verdammte/voron_2.4/Mobius-Extruder-M4/Mobius-Extruder-M4/README.md

# VORON M4 Extruder

Image of M4

This is the VORON M4 Extruder. It's a dual geared hobbed filament extruder designed for the Voron family of printers. It features a 4:1 belt driven design to provide torque while being able to be near silent. It borrows the best parts of the various extruders we've released over the past 5 years.

Voron Logo
