verdammte/voron_2.4/Voron-2-2.4r2/Voron-2-2.4r2/README.md

# Voron 2.4

Image of Voron 2.4

The official release of the Voron 2.4 3d printer.  You can find the BOM in the configurator located at the [Voron Design]( http://vorondesign.com/voron2.4) website.

Voron Logo
