verdammte/voron_2.4/Voron-2-2.4r2/Voron-2-2.4r2/firmware/klipper_configurations/SKR_1.4/readme.md

<B>VORON V2.4 SKR 1.4 Config</B>

This config file is for using two BigTreeTech SKR 1.4 boards on the Voron V2.4. For additional reference material, please reference BigTreeTech's Github page:

https://github.com/bigtreetech/BIGTREETECH-SKR-V1.3/tree/master/BTT%20SKR%20V1.4
