verdammte/voron_2.4/Voron-2-2.4r2/Voron-2-2.4r2/STLs/Tools/bottom_panel_modification.png

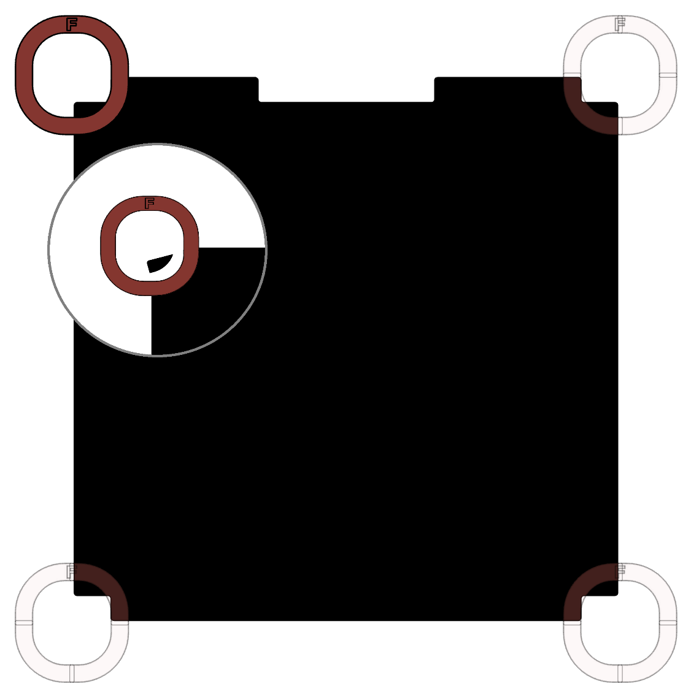
Voron-2-2.4r2/Voron-2-2.4r2/STLs/Tools/bottom_panel_modification.png
