verdammte/voron_2.4/Mobius-Extruder-M4/Mobius-Extruder-M4/STLs/main_body.stl

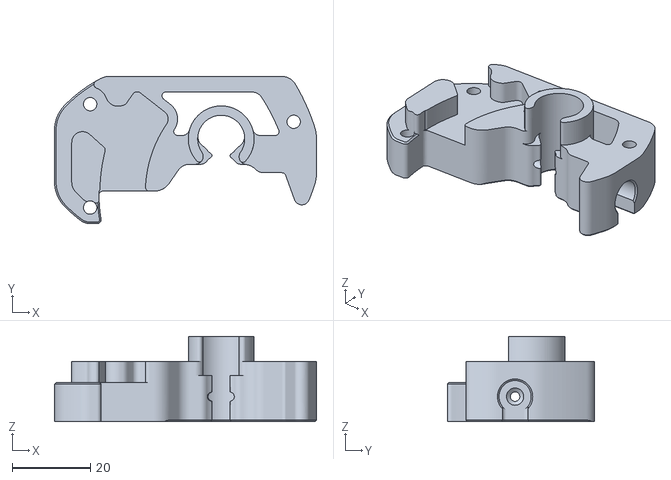
[picture p2: CAD file, 2022-04-12]
Mobius-Extruder-M4/Mobius-Extruder-M4/STLs/main_body.stl
66.8 x 37.6 x 21.8
