verdammte/voron_2.4/Voron-2-2.4r2/Voron-2-2.4r2/STLs/Z_Drive/z_drive_main_a_x2.stl

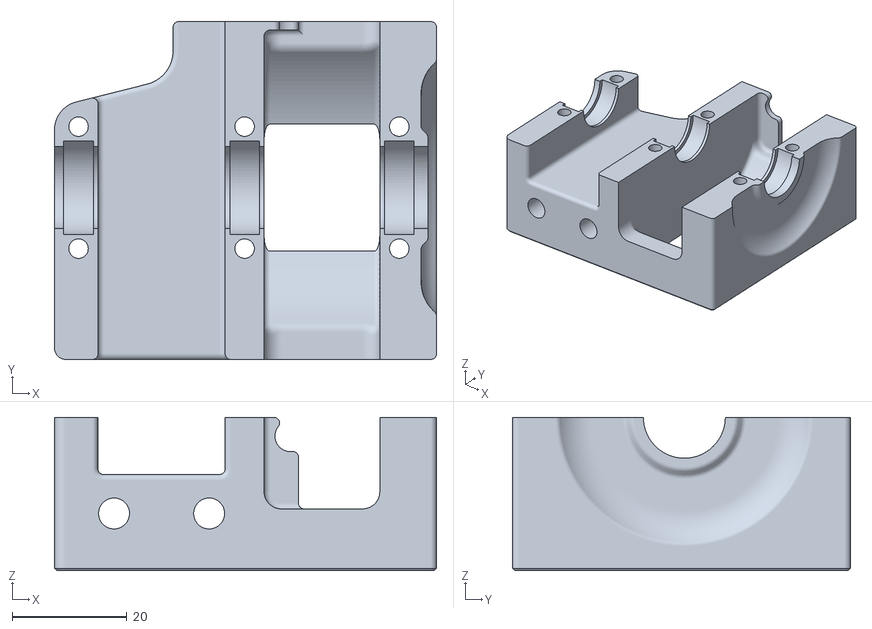
[picture p3: CAD file, 2022-04-12]
Voron-2-2.4r2/Voron-2-2.4r2/STLs/Z_Drive/z_drive_main_a_x2.stl
66.7 x 59.0 x 26.8
