verdammte/voron_2.4/Mobius-Extruder-M4/Mobius-Extruder-M4/STLs/motor_plate.stl

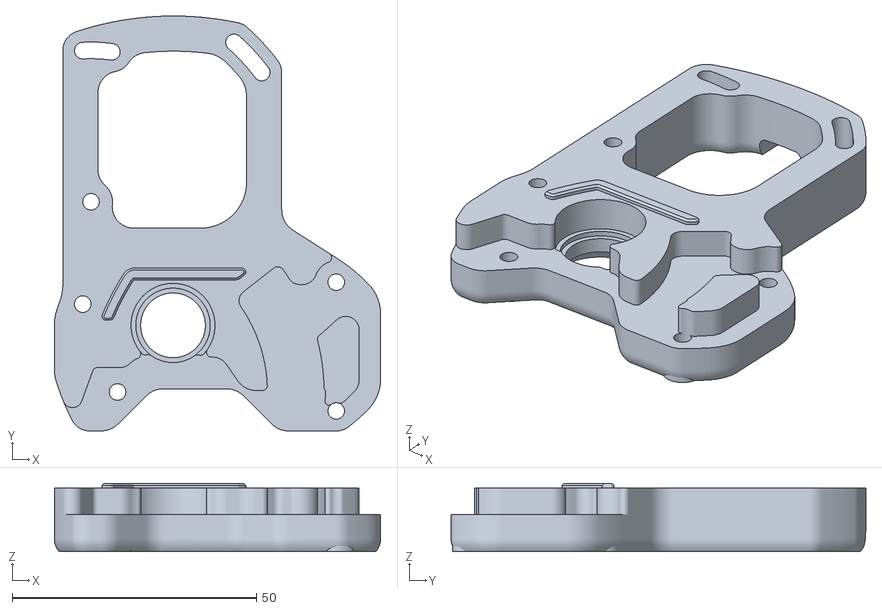
[picture p4: CAD file, 2022-04-12]
Mobius-Extruder-M4/Mobius-Extruder-M4/STLs/motor_plate.stl
66.8 x 85.0 x 14.0
