verdammte/voron_2.4/Voron-2-2.4r2/Voron-2-2.4r2/Drawing_DXFs/Build_Plate/MIC6_Bed_V2_350.step

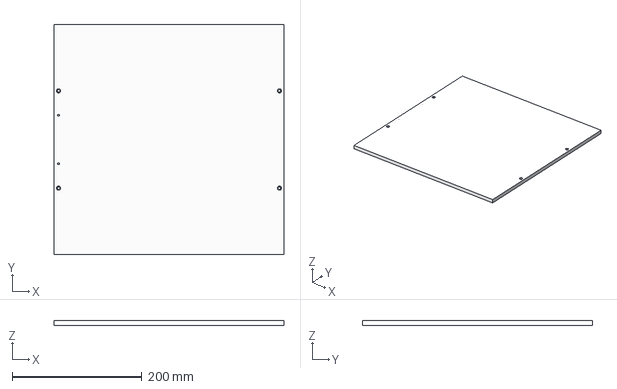
[picture p5: CAD file, 2022-04-12]
Voron-2-2.4r2/Voron-2-2.4r2/Drawing_DXFs/Build_Plate/MIC6_Bed_V2_350.step
355.0 x 355.0 x 7.76 mm
