verdammte/voron_2.4/Voron-2-2.4r2/Voron-2-2.4r2/Drawing_DXFs/Panels/250_Back_Panel.DXF

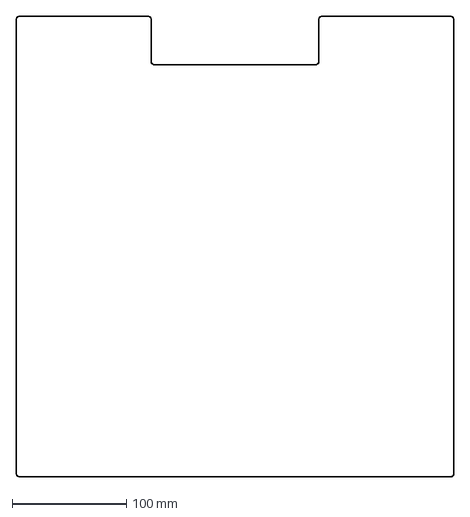
[picture p6: CAD file, 2022-04-12]
Voron-2-2.4r2/Voron-2-2.4r2/Drawing_DXFs/Panels/250_Back_Panel.DXF
383.0 x 403.0 mm
