verdammte/voron_2.4/Voron-2-2.4r2/Voron-2-2.4r2/STLs/Electronics_Bay/Controller_Mounts/GTR_bracket_set.stl

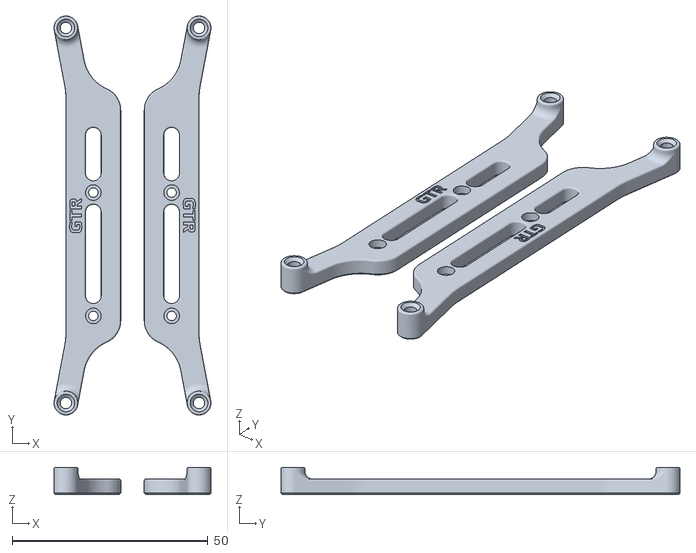
[picture p7: CAD file, 2022-04-12]
Voron-2-2.4r2/Voron-2-2.4r2/STLs/Electronics_Bay/Controller_Mounts/GTR_bracket_set.stl
40.1 x 101.9 x 7.00
