verdammte/voron_2.4/Voron-2-2.4r2/Voron-2-2.4r2/STLs/Electronics_Bay/Other_PS_Mounts/UHP_350_Mount_x2.stl

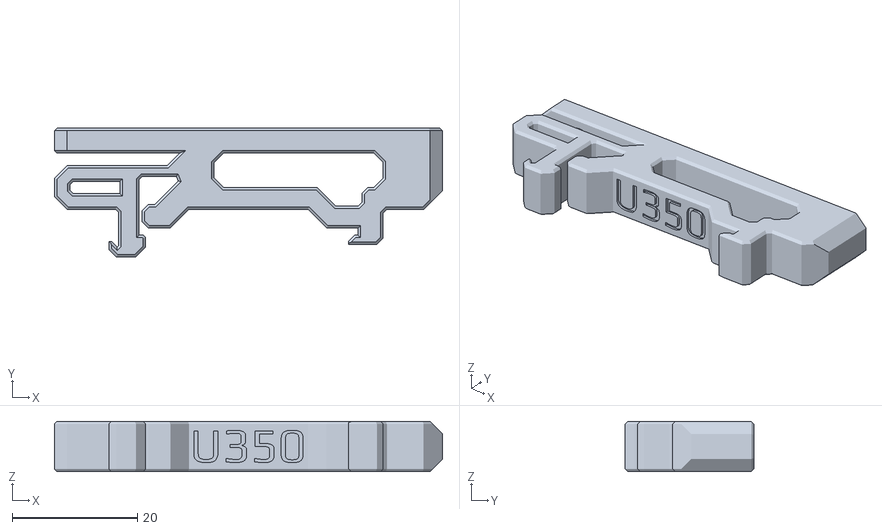
[picture p8: CAD file, 2022-04-12]
Voron-2-2.4r2/Voron-2-2.4r2/STLs/Electronics_Bay/Other_PS_Mounts/UHP_350_Mount_x2.stl
62.0 x 20.6 x 8.00
