verdammte/voron_2.4/Voron-2-2.4r2/Voron-2-2.4r2/STLs/Electronics_Bay/pcb_din_clip_x3.stl

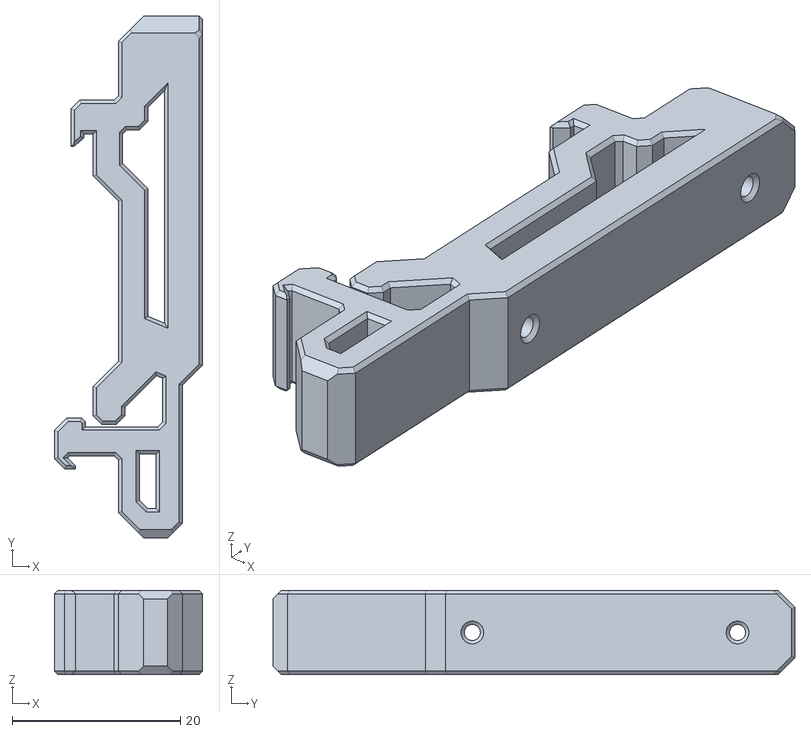
[picture p9: CAD file, 2022-04-12]
Voron-2-2.4r2/Voron-2-2.4r2/STLs/Electronics_Bay/pcb_din_clip_x3.stl
17.6 x 62.0 x 10.0
