verdammte/voron_2.4/Voron-2-2.4r2/Voron-2-2.4r2/STLs/Exhaust_Filter/[a]_exhaust_filter_mount_x2.stl

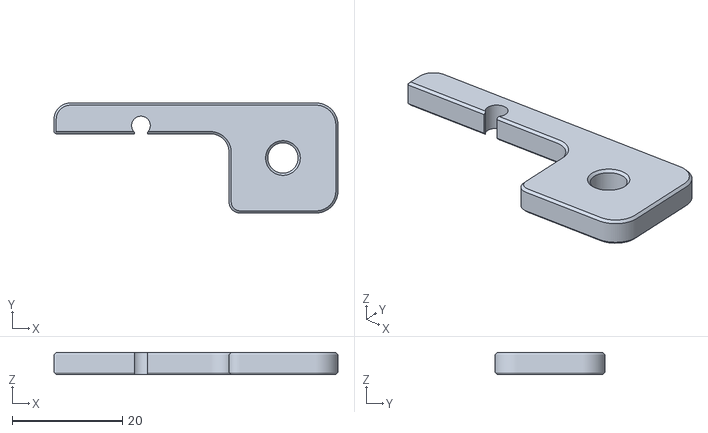
[picture p10: CAD file, 2022-04-12]
Voron-2-2.4r2/Voron-2-2.4r2/STLs/Exhaust_Filter/[a]_exhaust_filter_mount_x2.stl
51.6 x 20.0 x 4.00
