verdammte/voron_2.4/Voron-2-2.4r2/Voron-2-2.4r2/STLs/Gantry/X_Axis/X_Carriage/Bowden/bowden_dual_front_b.stl

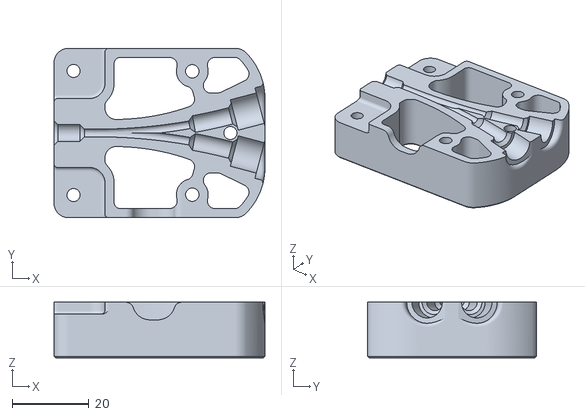
[picture p14: CAD file, 2022-04-12]
Voron-2-2.4r2/Voron-2-2.4r2/STLs/Gantry/X_Axis/X_Carriage/Bowden/bowden_dual_front_b.stl
55.0 x 44.2 x 14.5
