verdammte/voron_2.4/Voron-2-2.4r2/Voron-2-2.4r2/STLs/Gantry/X_Axis/X_Carriage/Direct_Feed/[a]_latch.stl

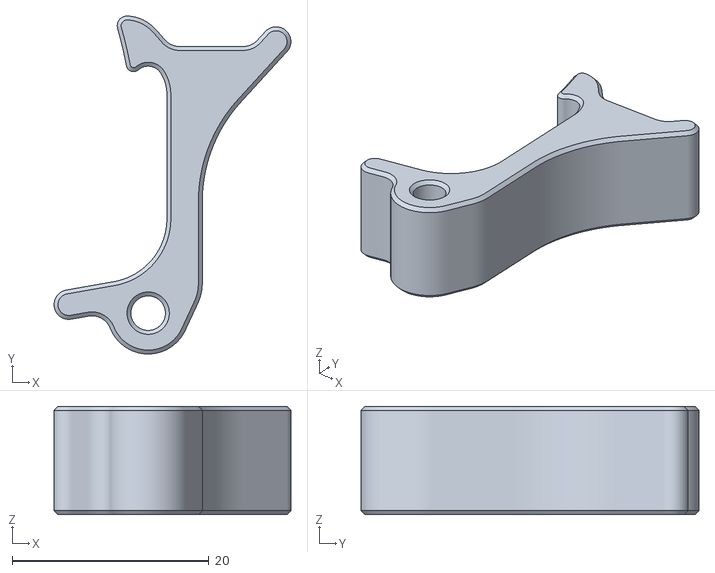
[picture p15: CAD file, 2022-04-12]
Voron-2-2.4r2/Voron-2-2.4r2/STLs/Gantry/X_Axis/X_Carriage/Direct_Feed/[a]_latch.stl
24.1 x 34.3 x 11.0
