verdammte/voron_2.4/Voron-2-2.4r2/Voron-2-2.4r2/STLs/Gantry/X_Axis/X_Carriage/Printheads/Dragonfly_BMO/printhead_front_dragonfly_bmo.stl

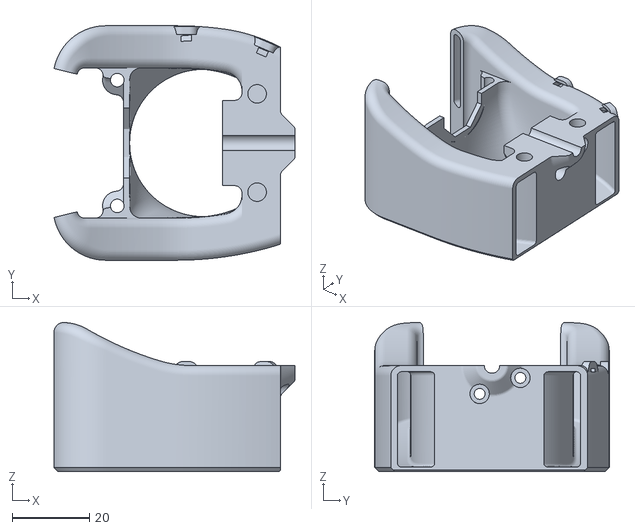
[picture p17: CAD file, 2022-04-12]
Voron-2-2.4r2/Voron-2-2.4r2/STLs/Gantry/X_Axis/X_Carriage/Printheads/Dragonfly_BMO/printhead_front_dragonfly_bmo.stl
62.3 x 60.6 x 38.5
