verdammte/voron_2.4/Voron-2-2.4r2/Voron-2-2.4r2/STLs/Gantry/X_Axis/X_Carriage/Printheads/E3D_V6/printhead_rear_e3dv6.stl

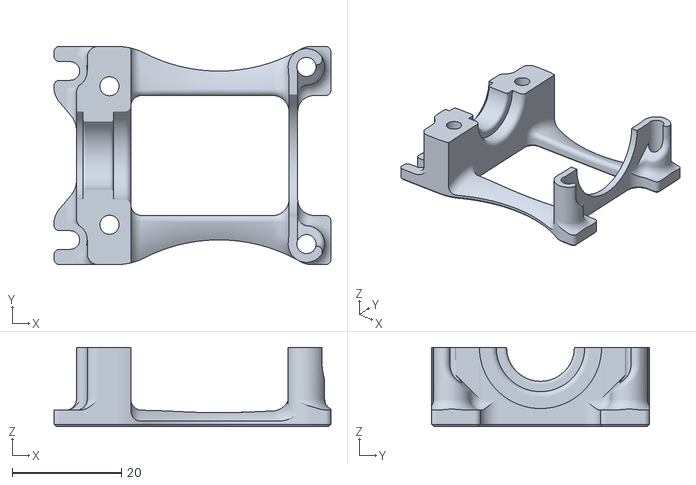
[picture p20: CAD file, 2022-04-12]
Voron-2-2.4r2/Voron-2-2.4r2/STLs/Gantry/X_Axis/X_Carriage/Printheads/E3D_V6/printhead_rear_e3dv6.stl
50.8 x 40.0 x 14.5
