verdammte/voron_2.4/Voron-2-2.4r2/Voron-2-2.4r2/STLs/Gantry/X_Axis/X_Carriage/Printheads/Slice_Mosquito/printhead_front_mosquito.stl

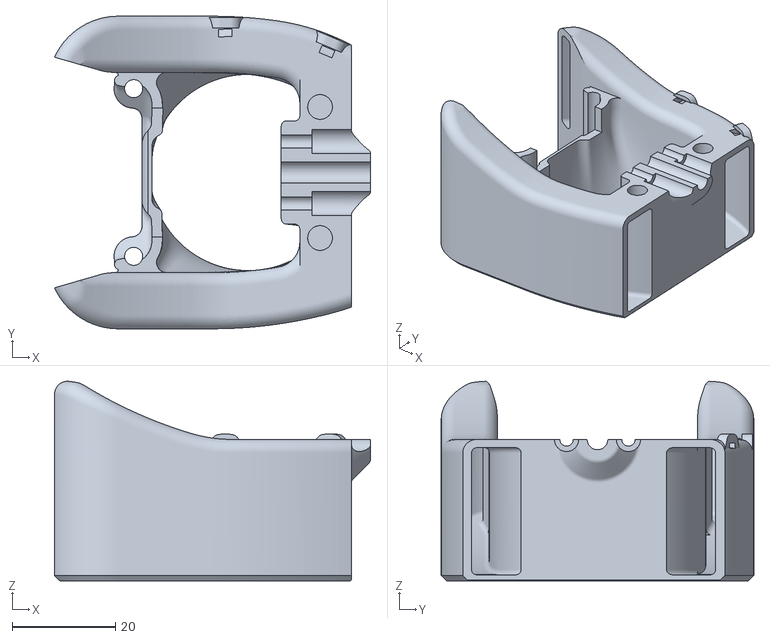
[picture p21: CAD file, 2022-04-12]
Voron-2-2.4r2/Voron-2-2.4r2/STLs/Gantry/X_Axis/X_Carriage/Printheads/Slice_Mosquito/printhead_front_mosquito.stl
61.2 x 60.6 x 38.7
