verdammte/voron_2.4/Voron-2-2.4r2/Voron-2-2.4r2/STLs/Gantry/X_Axis/XY_Joints/[a]_endstop_pod_hall_effect.stl

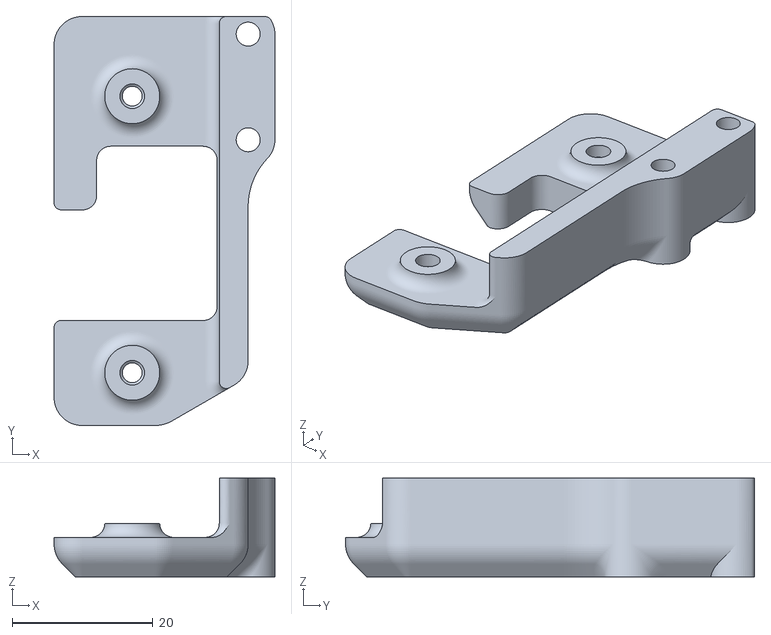
[picture p23: CAD file, 2022-04-12]
Voron-2-2.4r2/Voron-2-2.4r2/STLs/Gantry/X_Axis/XY_Joints/[a]_endstop_pod_hall_effect.stl
31.4 x 58.0 x 14.0
