verdammte/voron_2.4/Voron-2-2.4r2/Voron-2-2.4r2/STLs/Gantry/Z_Joints/z_joint_upper_x4.stl

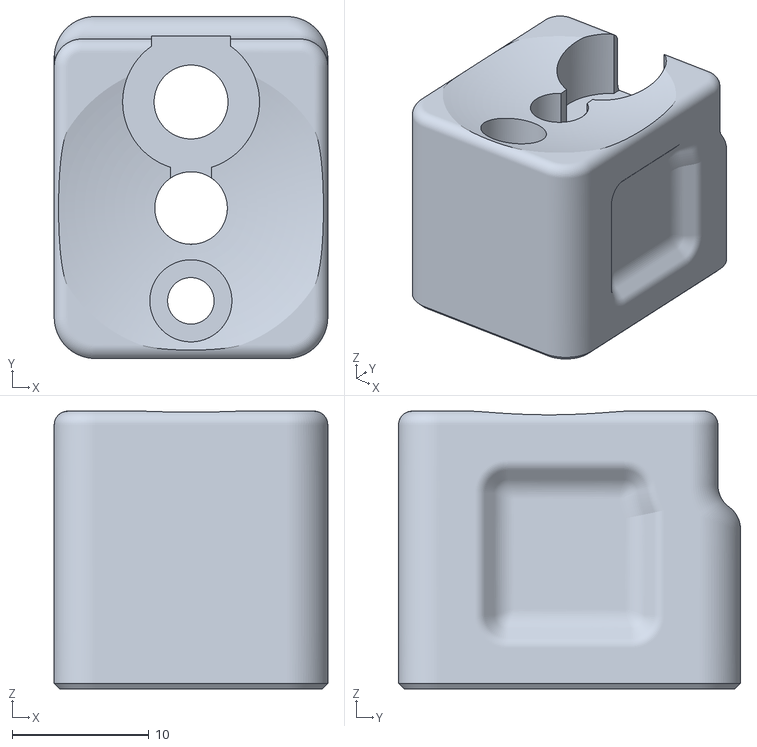
[picture p24: CAD file, 2022-04-12]
Voron-2-2.4r2/Voron-2-2.4r2/STLs/Gantry/Z_Joints/z_joint_upper_x4.stl
20.0 x 25.0 x 20.3
