verdammte/voron_2.4/Voron-2-2.4r2/Voron-2-2.4r2/STLs/Panel_Mounting/Front_Doors/latch_x2.stl

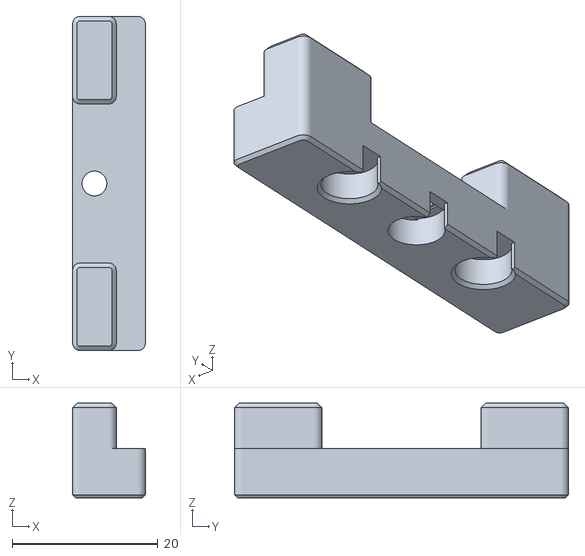
[picture p25: CAD file, 2022-04-12]
Voron-2-2.4r2/Voron-2-2.4r2/STLs/Panel_Mounting/Front_Doors/latch_x2.stl
10.0 x 45.9 x 13.0
