verdammte/voron_2.4/Voron-2-2.4r2/Voron-2-2.4r2/STLs/Panel_Mounting/z_belt_cover_b_x2.stl

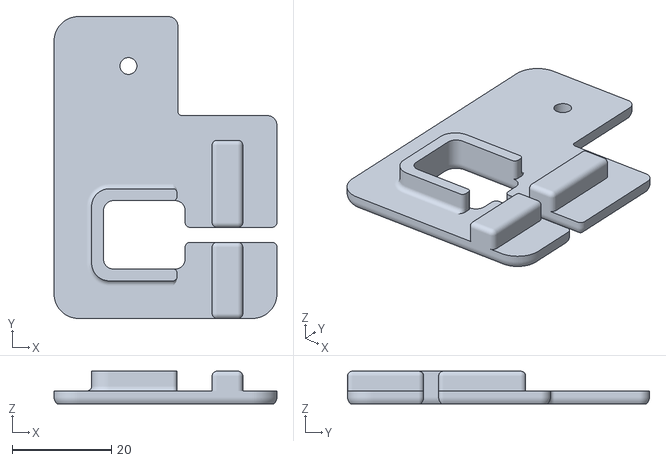
[picture p26: CAD file, 2022-04-12]
Voron-2-2.4r2/Voron-2-2.4r2/STLs/Panel_Mounting/z_belt_cover_b_x2.stl
45.0 x 61.0 x 6.60
