verdammte/voron_2.4/Voron-2-2.4r2/Voron-2-2.4r2/STLs/Skirts/250/side_skirt_b_250_x2.stl

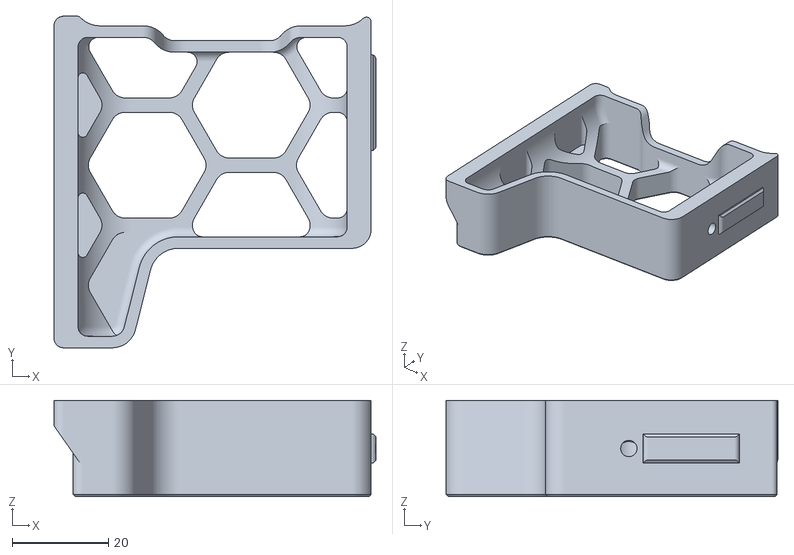
[picture p27: CAD file, 2022-04-12]
Voron-2-2.4r2/Voron-2-2.4r2/STLs/Skirts/250/side_skirt_b_250_x2.stl
67.0 x 69.0 x 20.0
