verdammte/voron_2.4/Voron-2-2.4r2/Voron-2-2.4r2/STLs/Skirts/300/front_skirt_a_300.stl

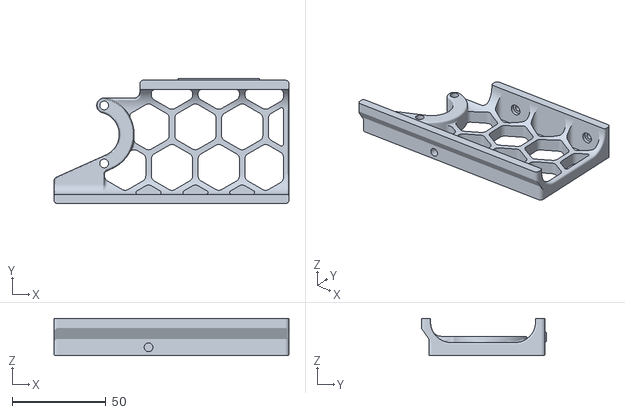
[picture p28: CAD file, 2022-04-12]
Voron-2-2.4r2/Voron-2-2.4r2/STLs/Skirts/300/front_skirt_a_300.stl
125.5 x 67.0 x 20.0
