verdammte/voron_2.4/Voron-2-2.4r2/Voron-2-2.4r2/STLs/Skirts/350/front_skirt_a_350.stl

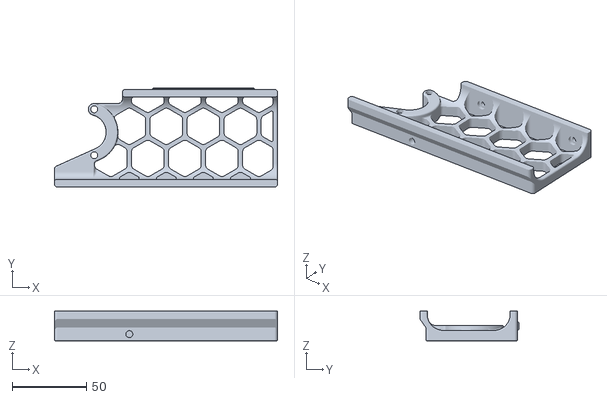
[picture p29: CAD file, 2022-04-12]
Voron-2-2.4r2/Voron-2-2.4r2/STLs/Skirts/350/front_skirt_a_350.stl
150.5 x 67.0 x 20.0
