verdammte/voron_2.4/Voron-2-2.4r2/Voron-2-2.4r2/STLs/Skirts/[a]_mini12864_case_hinge.stl

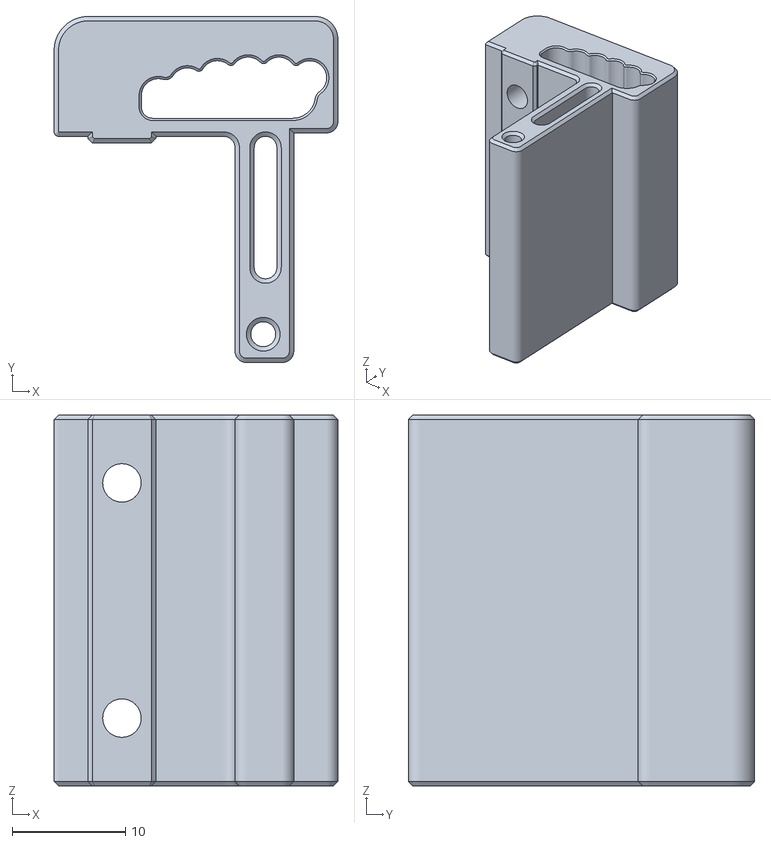
[picture p30: CAD file, 2022-04-12]
Voron-2-2.4r2/Voron-2-2.4r2/STLs/Skirts/[a]_mini12864_case_hinge.stl
25.1 x 30.6 x 32.8
