verdammte/voron_2.4/Voron-2-2.4r2/Voron-2-2.4r2/STLs/Spool_Management/spool_holder.stl

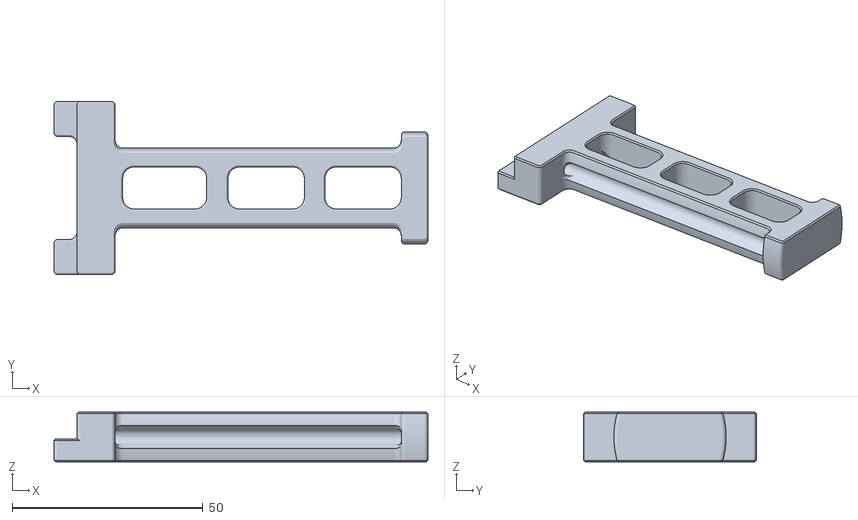
[picture p31: CAD file, 2022-04-12]
Voron-2-2.4r2/Voron-2-2.4r2/STLs/Spool_Management/spool_holder.stl
98.0 x 45.4 x 13.0
