verdammte/voron_2.4/Voron-2-2.4r2/Voron-2-2.4r2/STLs/Superceded_Parts/[a]_stopgap_80T_hubbed_gear.stl

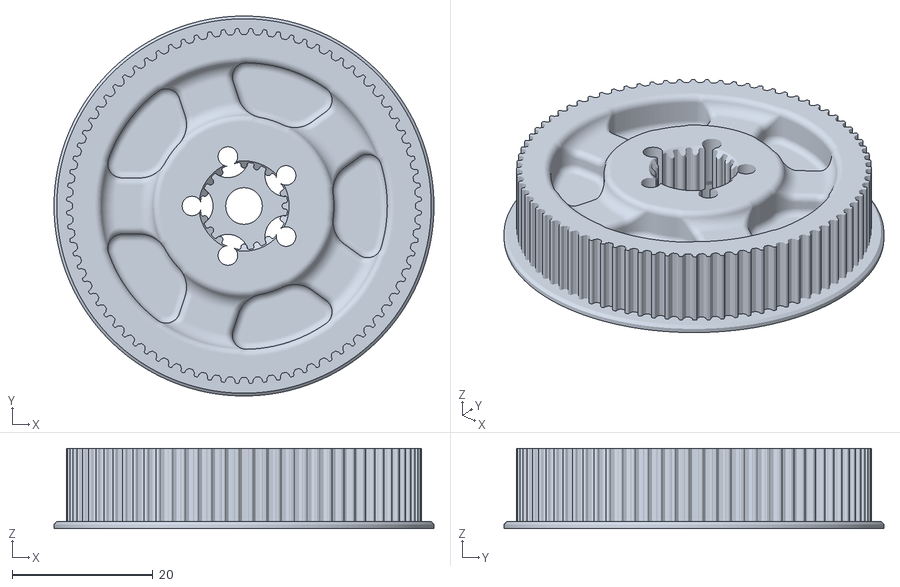
[picture p32: CAD file, 2022-04-12]
Voron-2-2.4r2/Voron-2-2.4r2/STLs/Superceded_Parts/[a]_stopgap_80T_hubbed_gear.stl
54.0 x 54.0 x 11.4
