verdammte/voron_2.4/Voron-2-2.4r2/Voron-2-2.4r2/STLs/Superceded_Parts/Frame_Brackets/lrs_bracket_frame.stl

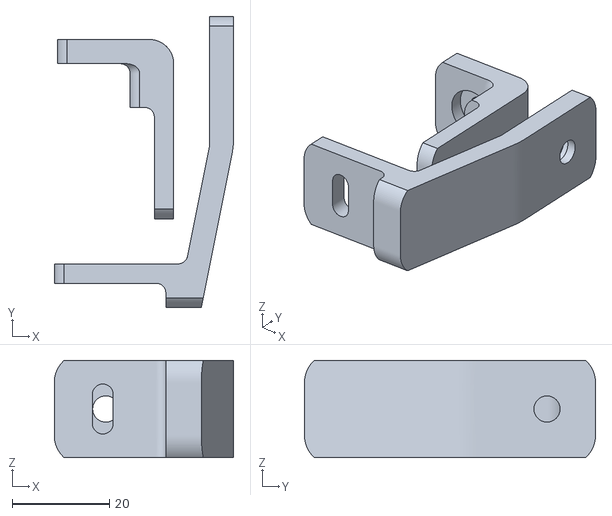
[picture p33: CAD file, 2022-04-12]
Voron-2-2.4r2/Voron-2-2.4r2/STLs/Superceded_Parts/Frame_Brackets/lrs_bracket_frame.stl
37.0 x 60.0 x 20.0
