verdammte/voron_2.4/Voron-2-2.4r2/Voron-2-2.4r2/STLs/Superceded_Parts/MGN9_X/x_carriage_pivot_block_MGN9.stl

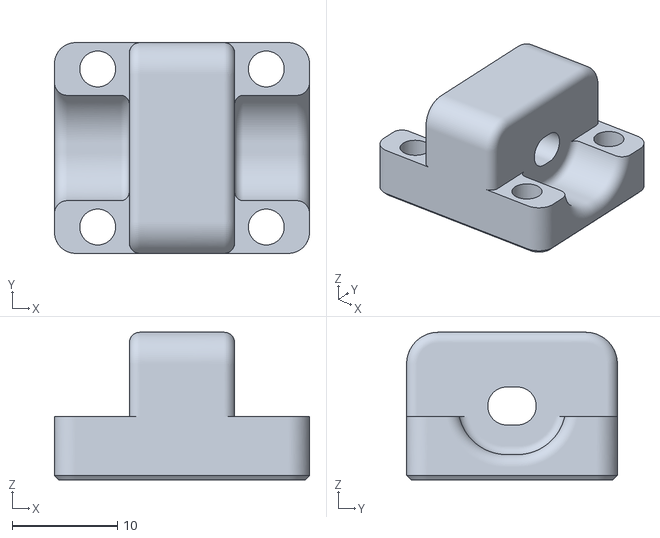
[picture p34: CAD file, 2022-04-12]
Voron-2-2.4r2/Voron-2-2.4r2/STLs/Superceded_Parts/MGN9_X/x_carriage_pivot_block_MGN9.stl
24.2 x 20.0 x 14.0
