verdammte/voron_2.4/Voron-2-2.4r2/Voron-2-2.4r2/STLs/Superceded_Parts/ZipChain/XY/zipchain2_xy_link_b.stl

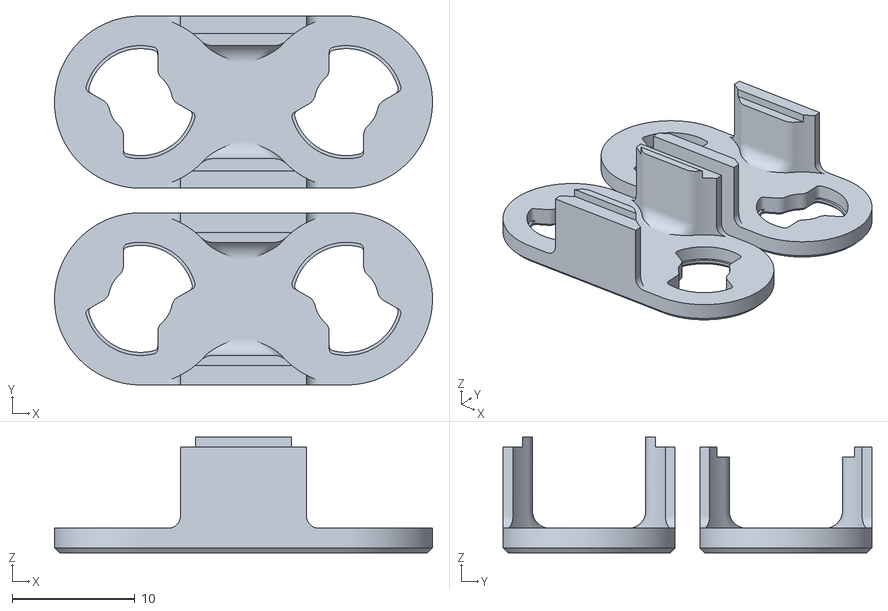
[picture p35: CAD file, 2022-04-12]
Voron-2-2.4r2/Voron-2-2.4r2/STLs/Superceded_Parts/ZipChain/XY/zipchain2_xy_link_b.stl
30.7 x 30.0 x 9.40
