verdammte/voron_2.4/Voron-2-2.4r2/Voron-2-2.4r2/STLs/Superceded_Parts/ZipChain/Z/zipchain2_z_link_b_locking.stl

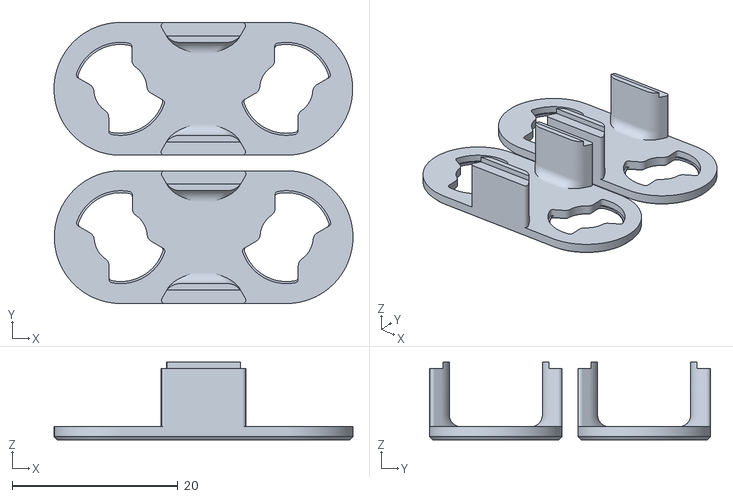
[picture p36: CAD file, 2022-04-12]
Voron-2-2.4r2/Voron-2-2.4r2/STLs/Superceded_Parts/ZipChain/Z/zipchain2_z_link_b_locking.stl
36.0 x 33.9 x 9.40
