verdammte/voron_2.4/Voron-2-2.4r2/Voron-2-2.4r2/STLs/Test_Prints/Thread_Test_3_x1_Rev1.STL

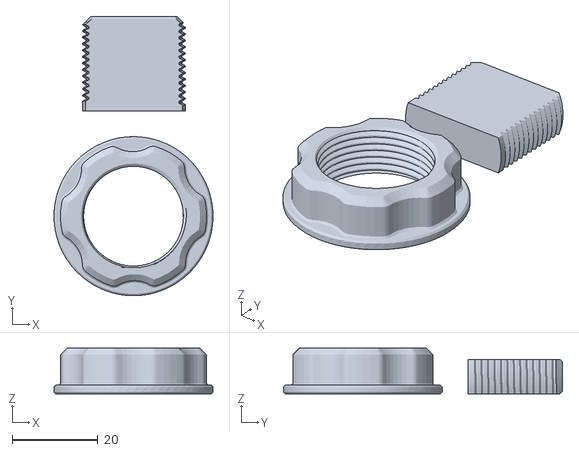
[picture p37: CAD file, 2022-04-12]
Voron-2-2.4r2/Voron-2-2.4r2/STLs/Test_Prints/Thread_Test_3_x1_Rev1.STL
37.0 x 65.0 x 10.6
