verdammte/voron_2.4/Voron-2-2.4r2/Voron-2-2.4r2/STLs/Tools/MGN9_rail_guide_x2.stl

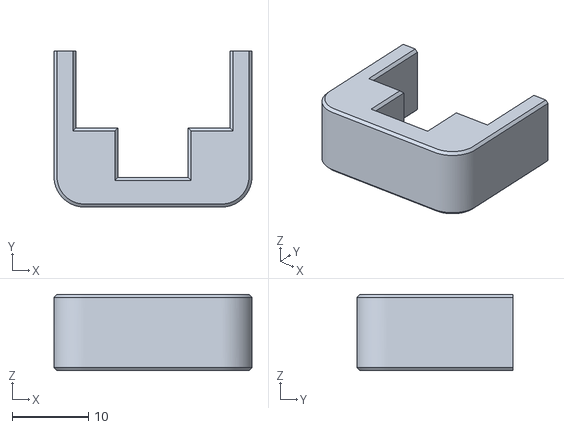
[picture p38: CAD file, 2022-04-12]
Voron-2-2.4r2/Voron-2-2.4r2/STLs/Tools/MGN9_rail_guide_x2.stl
26.0 x 20.5 x 10.0
