verdammte/voron_2.4/Voron-2-2.4r2/Voron-2-2.4r2/STLs/Z_Drive/z_motor_mount_b_x2.stl

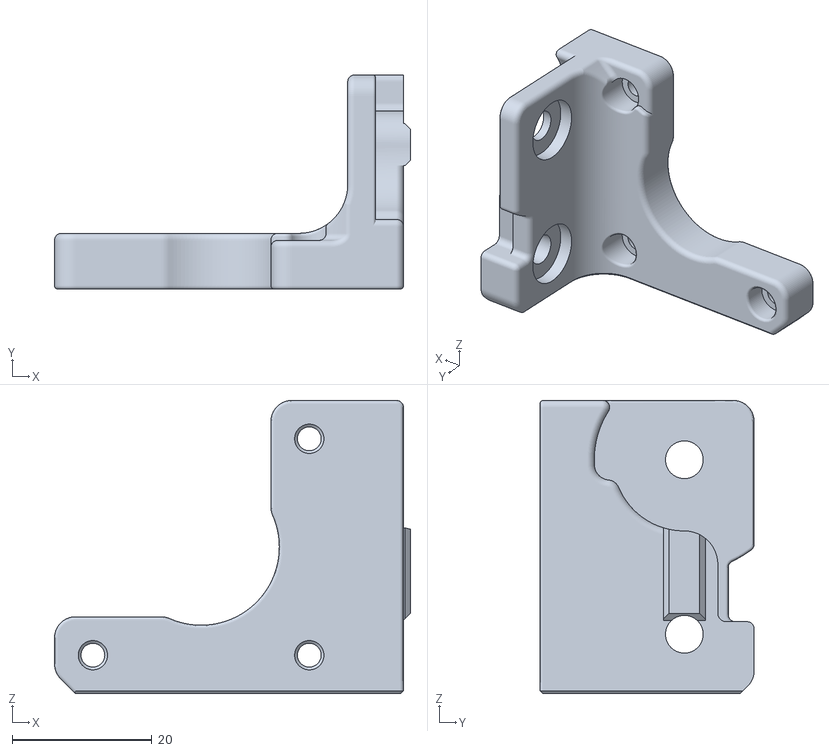
[picture p39: CAD file, 2022-04-12]
Voron-2-2.4r2/Voron-2-2.4r2/STLs/Z_Drive/z_motor_mount_b_x2.stl
51.0 x 30.7 x 42.0
