verdammte/voron_2.4/Voron-2-2.4r2/Voron-2-2.4r2/STLs/Z_Endstop/nozzle_probe.stl

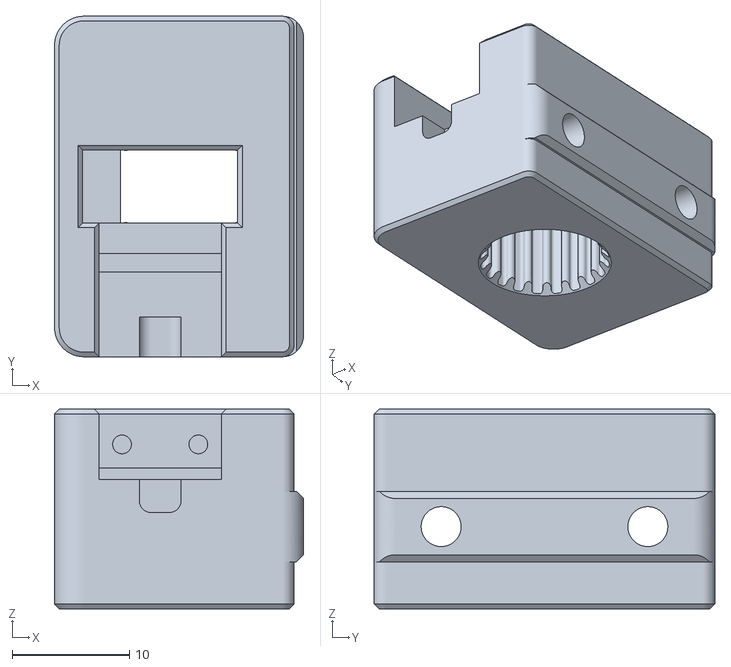
[picture p40: CAD file, 2022-04-12]
Voron-2-2.4r2/Voron-2-2.4r2/STLs/Z_Endstop/nozzle_probe.stl
21.2 x 29.0 x 17.0
