verdammte/voron_2.4/Voron-2-2.4r2/Voron-2-2.4r2/STLs/Z_Idlers/z_tensioner_bracket_b_x2.stl

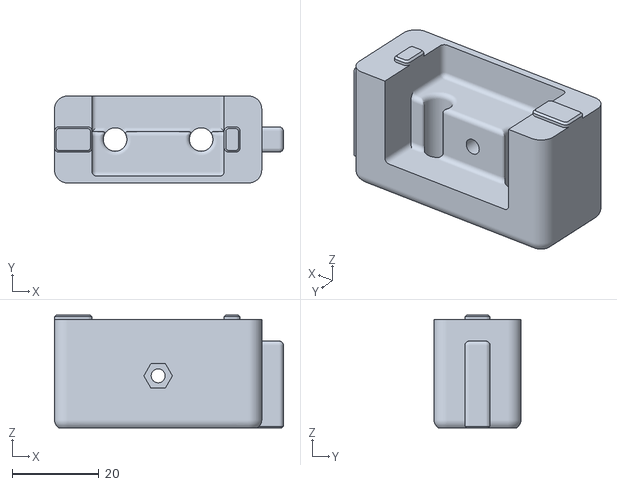
[picture p41: CAD file, 2022-04-12]
Voron-2-2.4r2/Voron-2-2.4r2/STLs/Z_Idlers/z_tensioner_bracket_b_x2.stl
52.7 x 20.0 x 26.0
