verdammte/voron_2.4/Voron-2-2.4r2/Voron-2-2.4r2/Drawing_DXFs/Panels/350_Back_Panel.DXF

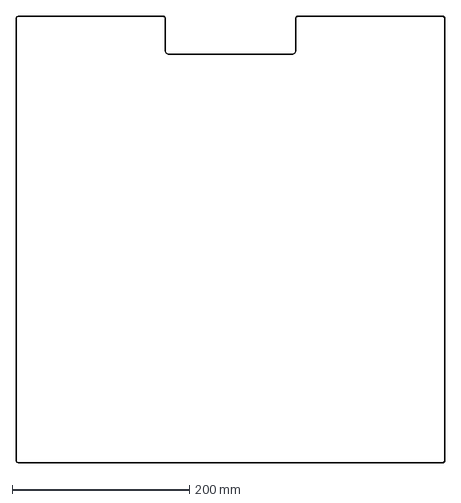
[picture p42: CAD file, 2022-04-12]
Voron-2-2.4r2/Voron-2-2.4r2/Drawing_DXFs/Panels/350_Back_Panel.DXF
483.0 x 503.0 mm
