verdammte/voron_2.4/Voron-2-2.4r2/Voron-2-2.4r2/STLs/Electronics_Bay/Controller_Mounts/BIGDIPPER_bracket_set.stl

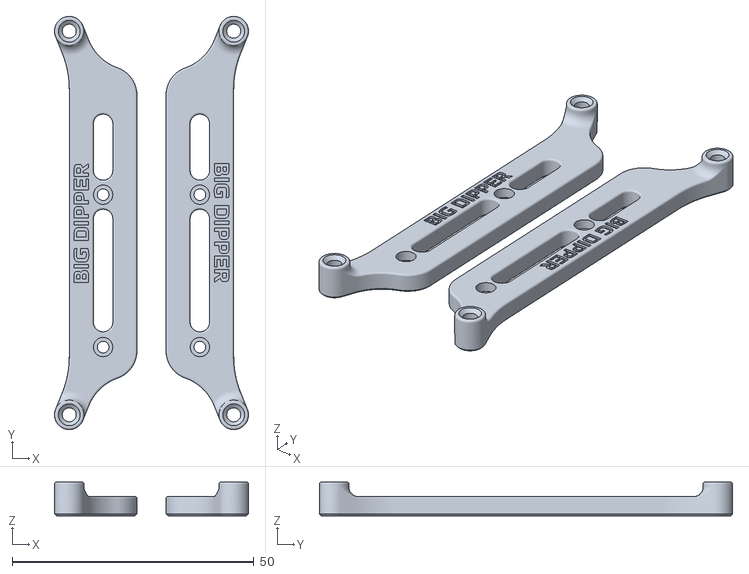
[picture p43: CAD file, 2022-04-12]
Voron-2-2.4r2/Voron-2-2.4r2/STLs/Electronics_Bay/Controller_Mounts/BIGDIPPER_bracket_set.stl
40.1 x 85.4 x 7.00
