verdammte/voron_2.4/Voron-2-2.4r2/Voron-2-2.4r2/STLs/Electronics_Bay/Other_PS_Mounts/UHP_200_Mount_x2.stl

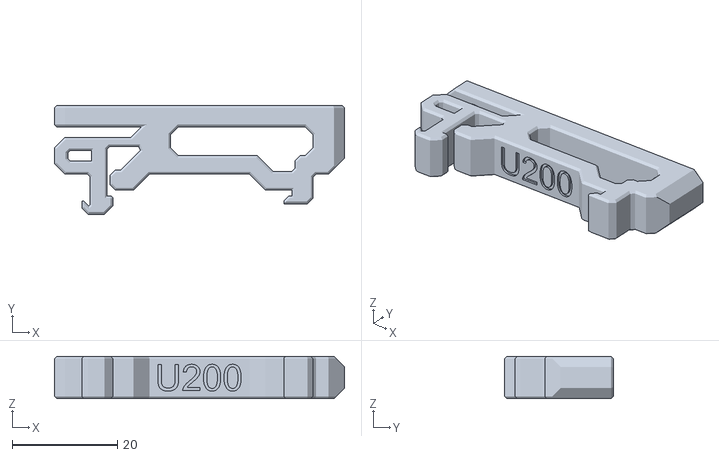
[picture p44: CAD file, 2022-04-12]
Voron-2-2.4r2/Voron-2-2.4r2/STLs/Electronics_Bay/Other_PS_Mounts/UHP_200_Mount_x2.stl
55.0 x 20.6 x 8.00
