verdammte/voron_2.4/Voron-2-2.4r2/Voron-2-2.4r2/STLs/Electronics_Bay/wago_221-415_mount_3x5.stl

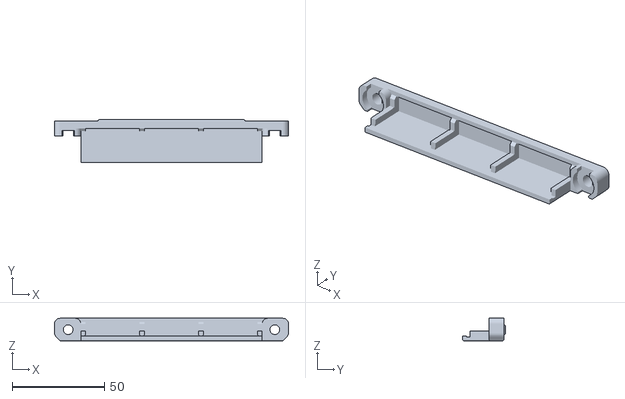
[picture p45: CAD file, 2022-04-12]
Voron-2-2.4r2/Voron-2-2.4r2/STLs/Electronics_Bay/wago_221-415_mount_3x5.stl
126.8 x 23.0 x 12.2
