verdammte/voron_2.4/Voron-2-2.4r2/Voron-2-2.4r2/STLs/Exhaust_Filter/exhaust_filter_grill.stl

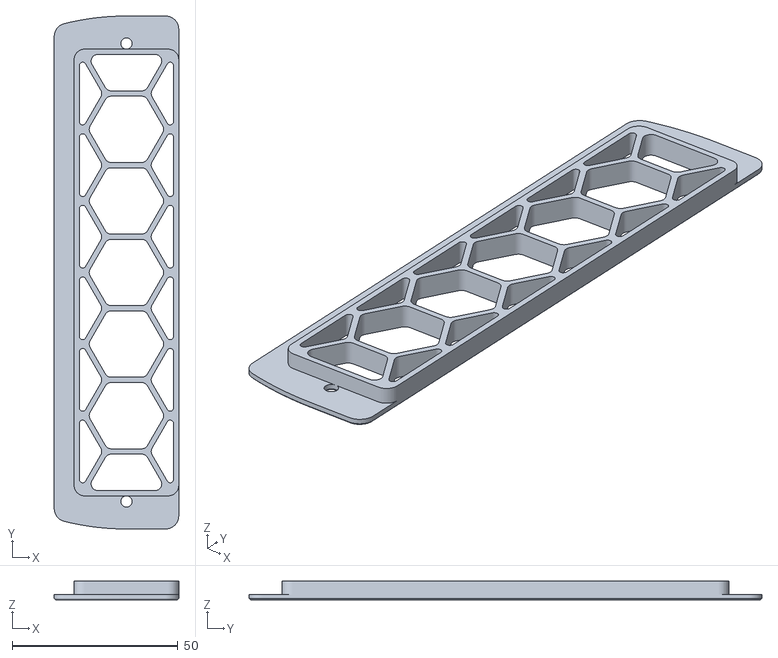
[picture p46: CAD file, 2022-04-12]
Voron-2-2.4r2/Voron-2-2.4r2/STLs/Exhaust_Filter/exhaust_filter_grill.stl
37.6 x 154.8 x 5.60
