verdammte/voron_2.4/Voron-2-2.4r2/Voron-2-2.4r2/STLs/Gantry/AB_Drive_Units/b_drive_frame_lower.stl

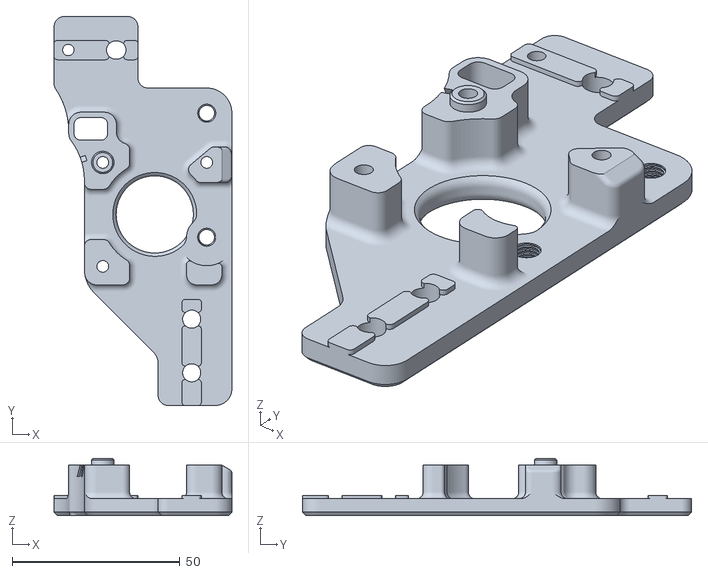
[picture p47: CAD file, 2022-04-12]
Voron-2-2.4r2/Voron-2-2.4r2/STLs/Gantry/AB_Drive_Units/b_drive_frame_lower.stl
53.0 x 116.0 x 17.0
