verdammte/voron_2.4/Voron-2-2.4r2/Voron-2-2.4r2/STLs/Gantry/Front_Idlers/front_idler_left_upper.stl

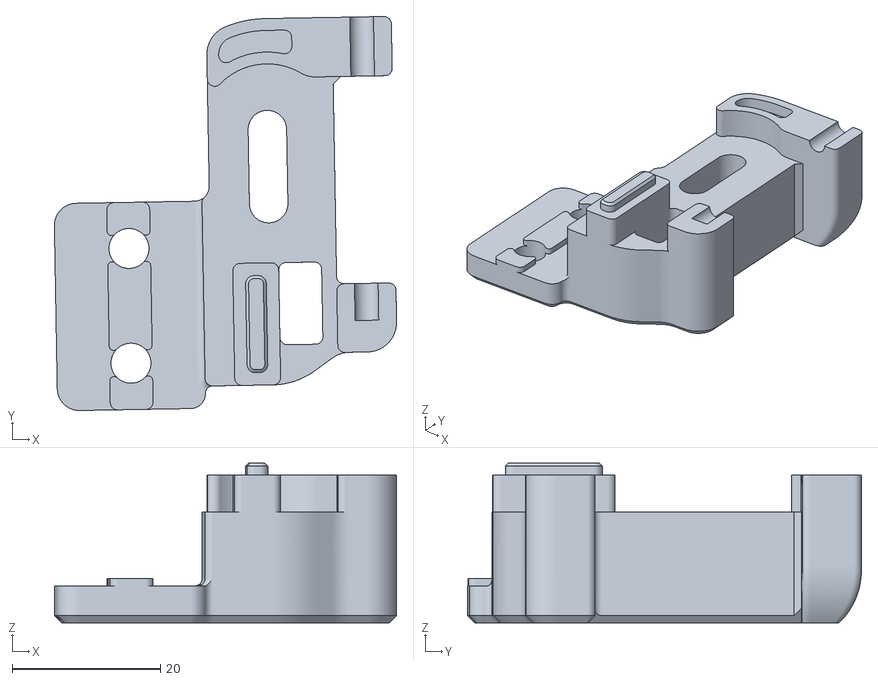
[picture p48: CAD file, 2022-04-12]
Voron-2-2.4r2/Voron-2-2.4r2/STLs/Gantry/Front_Idlers/front_idler_left_upper.stl
46.2 x 53.2 x 21.6
