verdammte/voron_2.4/Voron-2-2.4r2/Voron-2-2.4r2/STLs/Gantry/X_Axis/X_Carriage/Direct_Feed/[a]_connector_cover.stl

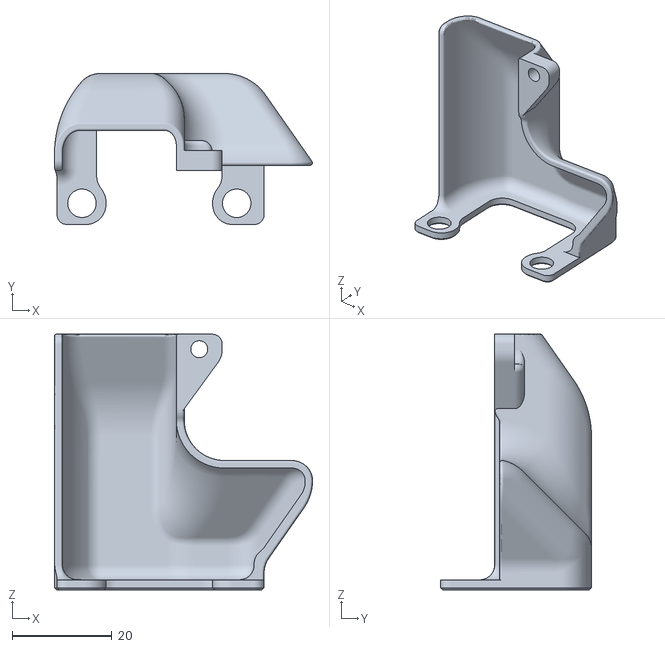
[picture p50: CAD file, 2022-04-12]
Voron-2-2.4r2/Voron-2-2.4r2/STLs/Gantry/X_Axis/X_Carriage/Direct_Feed/[a]_connector_cover.stl
51.7 x 30.3 x 51.2
