verdammte/voron_2.4/Voron-2-2.4r2/Voron-2-2.4r2/STLs/Gantry/X_Axis/X_Carriage/Printheads/Dragonfly_BMO/printhead_rear_dragonfly_bmo.stl

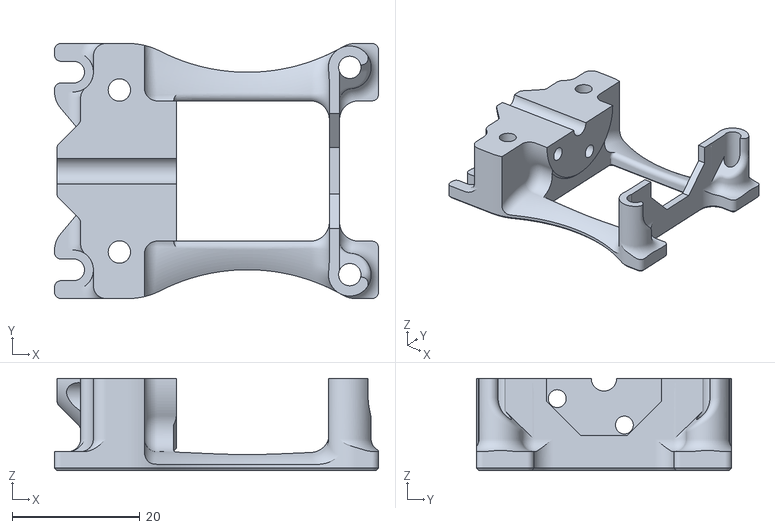
[picture p51: CAD file, 2022-04-12]
Voron-2-2.4r2/Voron-2-2.4r2/STLs/Gantry/X_Axis/X_Carriage/Printheads/Dragonfly_BMO/printhead_rear_dragonfly_bmo.stl
50.8 x 40.0 x 14.5
