verdammte/voron_2.4/Voron-2-2.4r2/Voron-2-2.4r2/STLs/Gantry/X_Axis/X_Carriage/x_carriage_frame_right_MGN12.stl

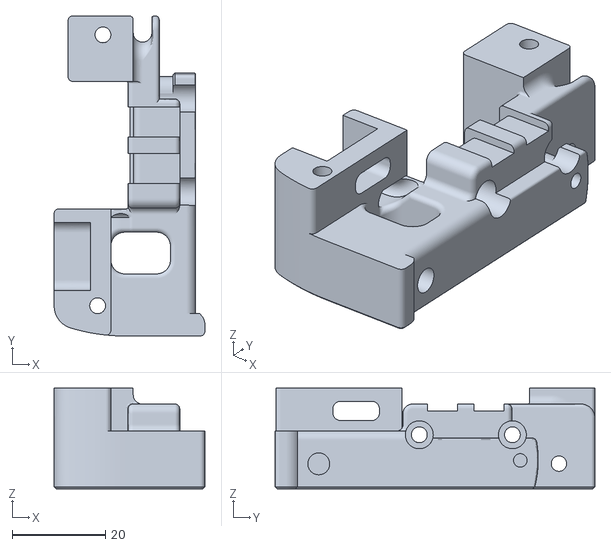
[picture p54: CAD file, 2022-04-12]
Voron-2-2.4r2/Voron-2-2.4r2/STLs/Gantry/X_Axis/X_Carriage/x_carriage_frame_right_MGN12.stl
32.4 x 68.8 x 21.6
