verdammte/voron_2.4/Voron-2-2.4r2/Voron-2-2.4r2/STLs/Gantry/X_Axis/XY_Joints/[a]_xy_joint_cable_bridge_2hole.stl

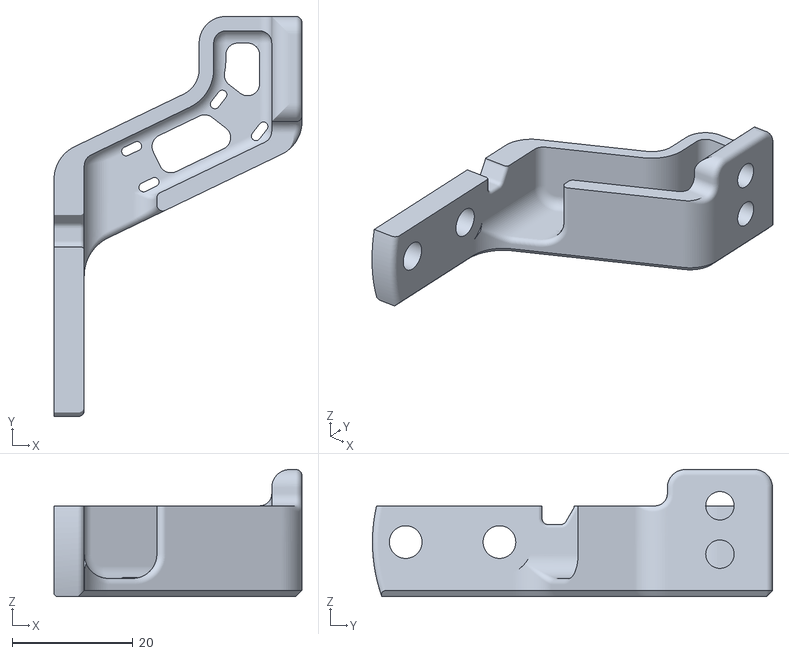
[picture p55: CAD file, 2022-04-12]
Voron-2-2.4r2/Voron-2-2.4r2/STLs/Gantry/X_Axis/XY_Joints/[a]_xy_joint_cable_bridge_2hole.stl
41.0 x 66.1 x 21.0
