verdammte/voron_2.4/Voron-2-2.4r2/Voron-2-2.4r2/STLs/Gantry/z_chain_guide.stl

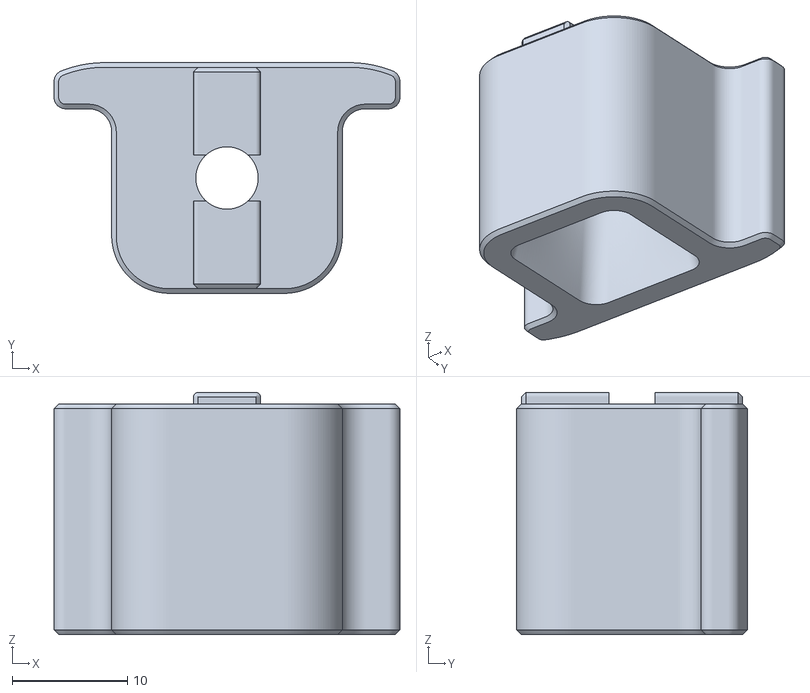
[picture p56: CAD file, 2022-04-12]
Voron-2-2.4r2/Voron-2-2.4r2/STLs/Gantry/z_chain_guide.stl
30.0 x 20.0 x 21.0
