verdammte/voron_2.4/Voron-2-2.4r2/Voron-2-2.4r2/STLs/Panel_Mounting/Front_Doors/handle_a_x2.stl

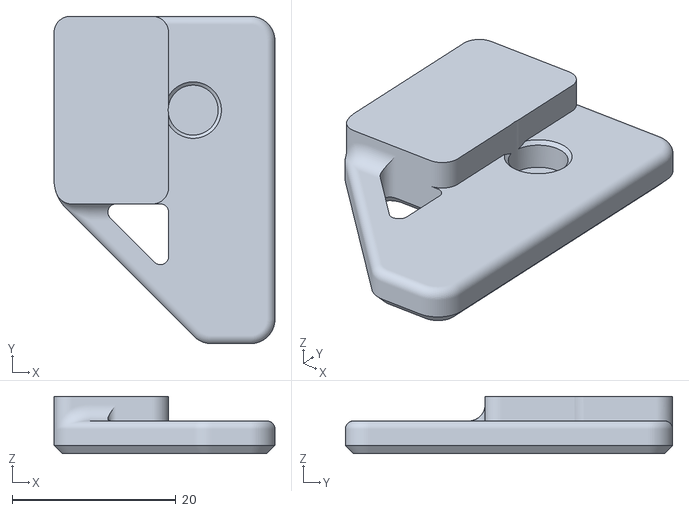
[picture p58: CAD file, 2022-04-12]
Voron-2-2.4r2/Voron-2-2.4r2/STLs/Panel_Mounting/Front_Doors/handle_a_x2.stl
27.0 x 40.0 x 7.00
