verdammte/voron_2.4/Voron-2-2.4r2/Voron-2-2.4r2/STLs/Panel_Mounting/midspan_panel_clip_4mm_x7.stl

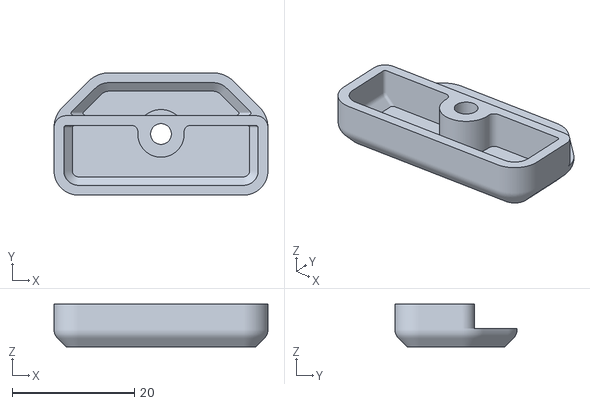
[picture p59: CAD file, 2022-04-12]
Voron-2-2.4r2/Voron-2-2.4r2/STLs/Panel_Mounting/midspan_panel_clip_4mm_x7.stl
35.0 x 20.0 x 7.00
