verdammte/voron_2.4/Voron-2-2.4r2/Voron-2-2.4r2/STLs/Skirts/250/front_skirt_a_250.stl

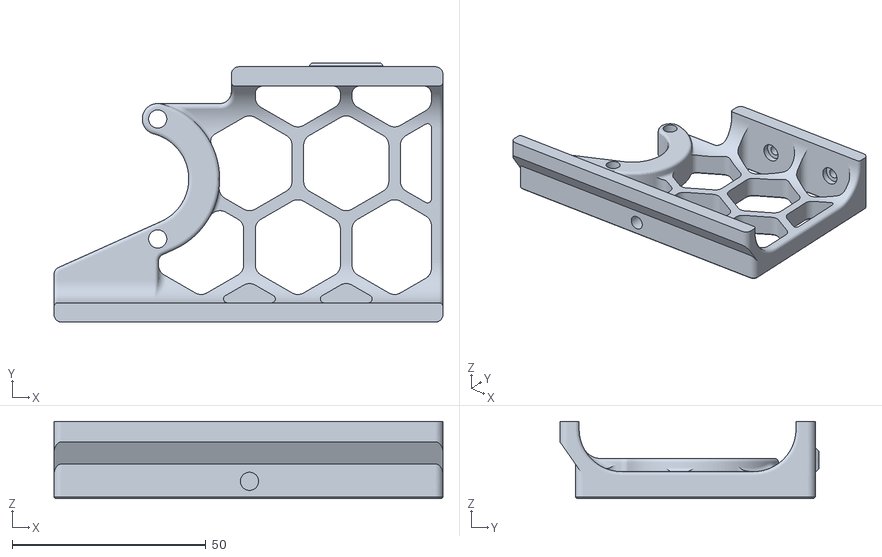
[picture p60: CAD file, 2022-04-12]
Voron-2-2.4r2/Voron-2-2.4r2/STLs/Skirts/250/front_skirt_a_250.stl
100.5 x 67.0 x 20.0
