verdammte/voron_2.4/Voron-2-2.4r2/Voron-2-2.4r2/STLs/Skirts/300/side_skirt_b_300_x2.stl

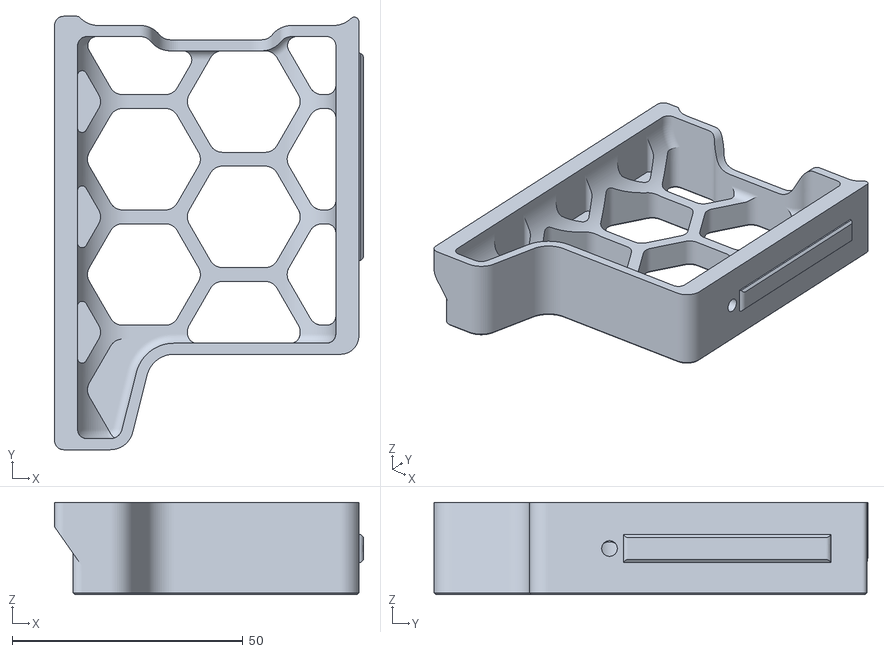
[picture p61: CAD file, 2022-04-12]
Voron-2-2.4r2/Voron-2-2.4r2/STLs/Skirts/300/side_skirt_b_300_x2.stl
67.0 x 94.0 x 20.0
