verdammte/voron_2.4/Voron-2-2.4r2/Voron-2-2.4r2/STLs/Skirts/350/side_skirt_a_350_x2.stl

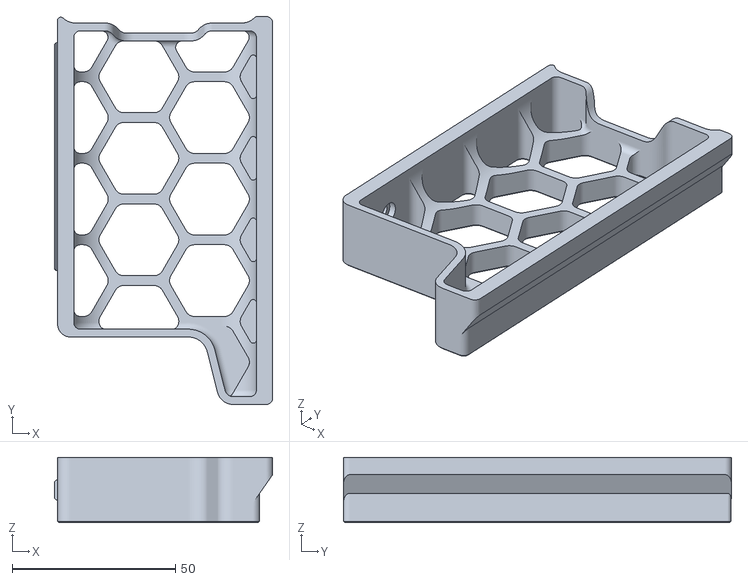
[picture p62: CAD file, 2022-04-12]
Voron-2-2.4r2/Voron-2-2.4r2/STLs/Skirts/350/side_skirt_a_350_x2.stl
67.0 x 119.0 x 20.0
