verdammte/voron_2.4/Voron-2-2.4r2/Voron-2-2.4r2/STLs/Skirts/[a]_belt_guard_b_x2.stl

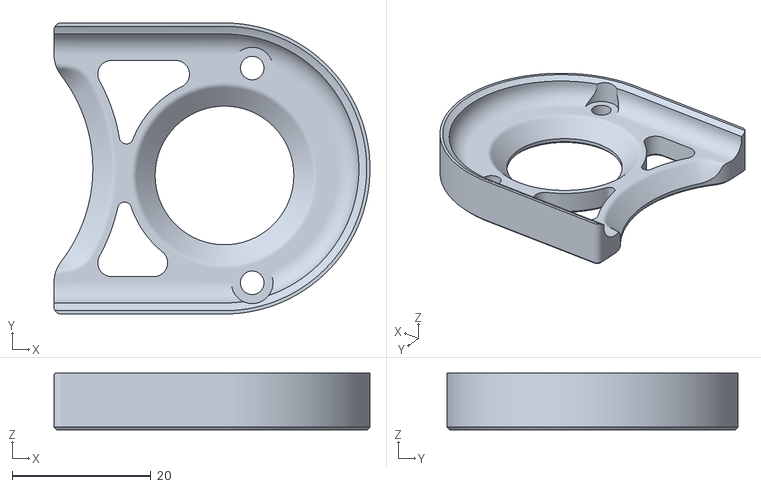
[picture p63: CAD file, 2022-04-12]
Voron-2-2.4r2/Voron-2-2.4r2/STLs/Skirts/[a]_belt_guard_b_x2.stl
45.6 x 42.0 x 8.20
