verdammte/voron_2.4/Voron-2-2.4r2/Voron-2-2.4r2/STLs/Spool_Management/bowden_retainer.stl

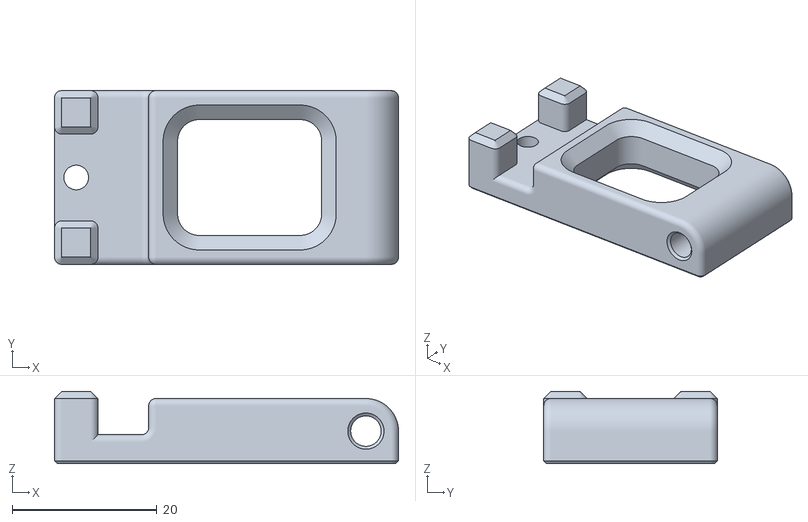
[picture p64: CAD file, 2022-04-12]
Voron-2-2.4r2/Voron-2-2.4r2/STLs/Spool_Management/bowden_retainer.stl
47.5 x 24.0 x 10.00
