verdammte/voron_2.4/Voron-2-2.4r2/Voron-2-2.4r2/STLs/Superceded_Parts/[a]_z_tensioner_x4_6mm.stl

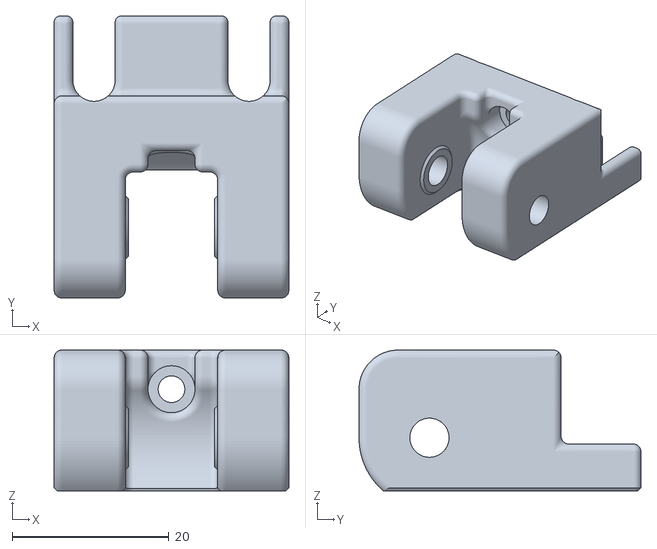
[picture p65: CAD file, 2022-04-12]
Voron-2-2.4r2/Voron-2-2.4r2/STLs/Superceded_Parts/[a]_z_tensioner_x4_6mm.stl
30.0 x 36.0 x 18.0
