verdammte/voron_2.4/Voron-2-2.4r2/Voron-2-2.4r2/STLs/Superceded_Parts/Frame_Brackets/rs_35_bracket_frame.stl

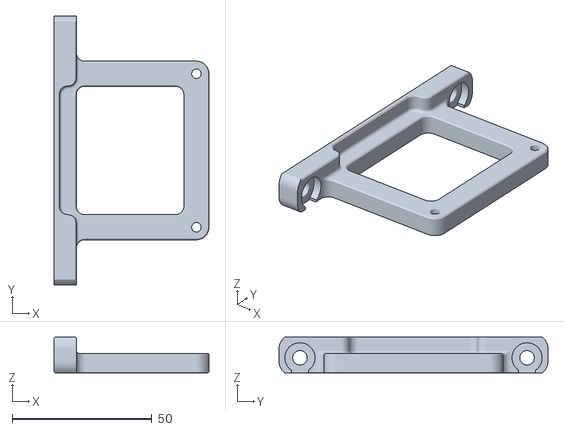
[picture p66: CAD file, 2022-04-12]
Voron-2-2.4r2/Voron-2-2.4r2/STLs/Superceded_Parts/Frame_Brackets/rs_35_bracket_frame.stl
55.5 x 96.3 x 12.8
