verdammte/voron_2.4/Voron-2-2.4r2/Voron-2-2.4r2/STLs/Superceded_Parts/ZipChain/XY/zipchain2_xy_end.stl

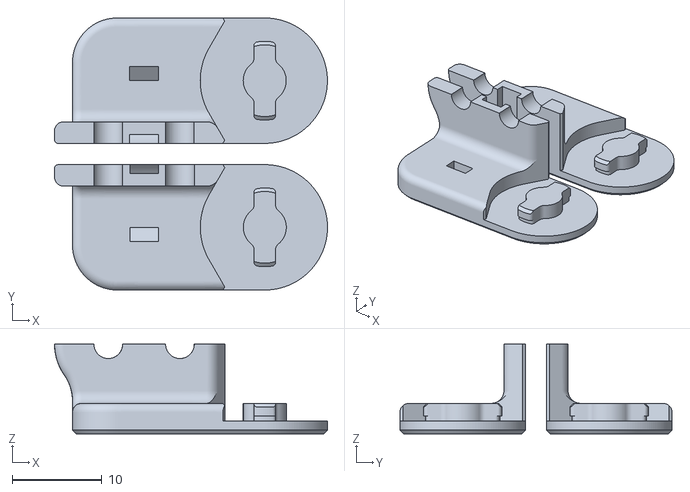
[picture p68: CAD file, 2022-04-12]
Voron-2-2.4r2/Voron-2-2.4r2/STLs/Superceded_Parts/ZipChain/XY/zipchain2_xy_end.stl
30.5 x 30.4 x 10.0
