verdammte/voron_2.4/Voron-2-2.4r2/Voron-2-2.4r2/STLs/Superceded_Parts/ZipChain/Z/zipchain2_z_end.stl

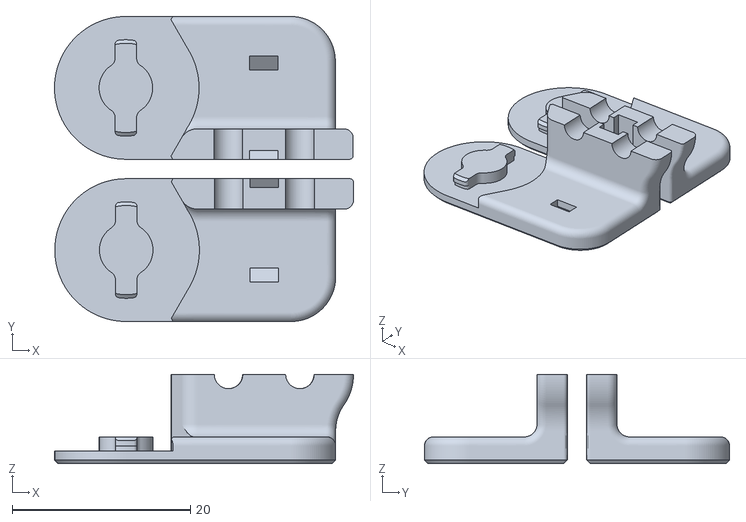
[picture p69: CAD file, 2022-04-12]
Voron-2-2.4r2/Voron-2-2.4r2/STLs/Superceded_Parts/ZipChain/Z/zipchain2_z_end.stl
33.5 x 34.2 x 10.0
