verdammte/voron_2.4/Voron-2-2.4r2/Voron-2-2.4r2/STLs/Test_Prints/Voron_Design_Cube_v7.stl

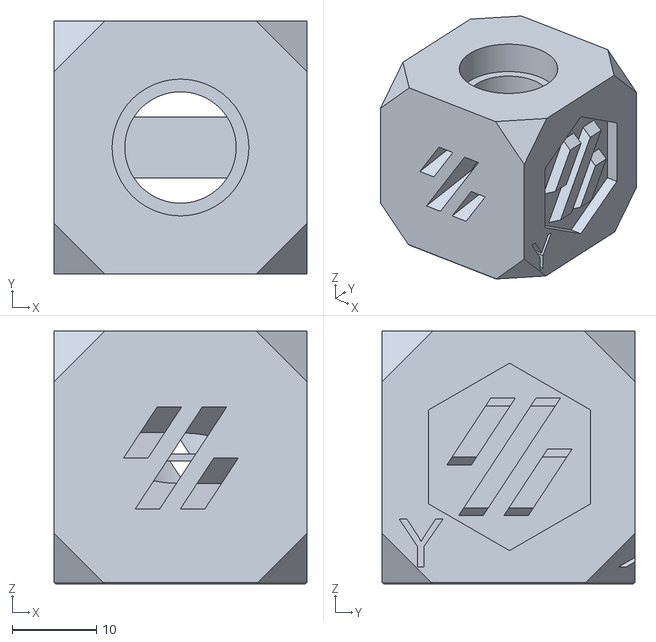
[picture p70: CAD file, 2022-04-12]
Voron-2-2.4r2/Voron-2-2.4r2/STLs/Test_Prints/Voron_Design_Cube_v7.stl
30.0 x 30.0 x 30.0
