verdammte/voron_2.4/Voron-2-2.4r2/Voron-2-2.4r2/STLs/Tools/bottom_panel_template.stl

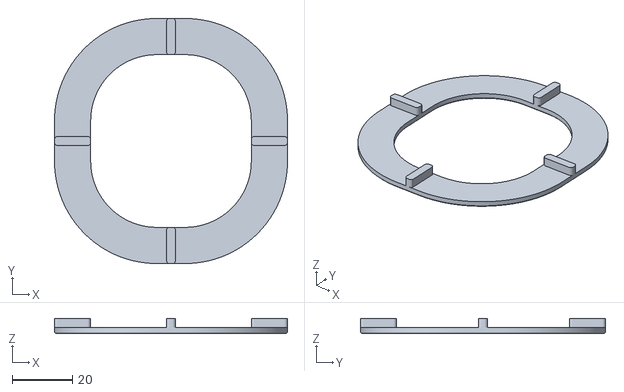
[picture p71: CAD file, 2022-04-12]
Voron-2-2.4r2/Voron-2-2.4r2/STLs/Tools/bottom_panel_template.stl
77.2 x 81.2 x 5.00
