verdammte/voron_2.4/Voron-2-2.4r2/Voron-2-2.4r2/STLs/Z_Drive/[a]_belt_tensioner_a_x2.stl

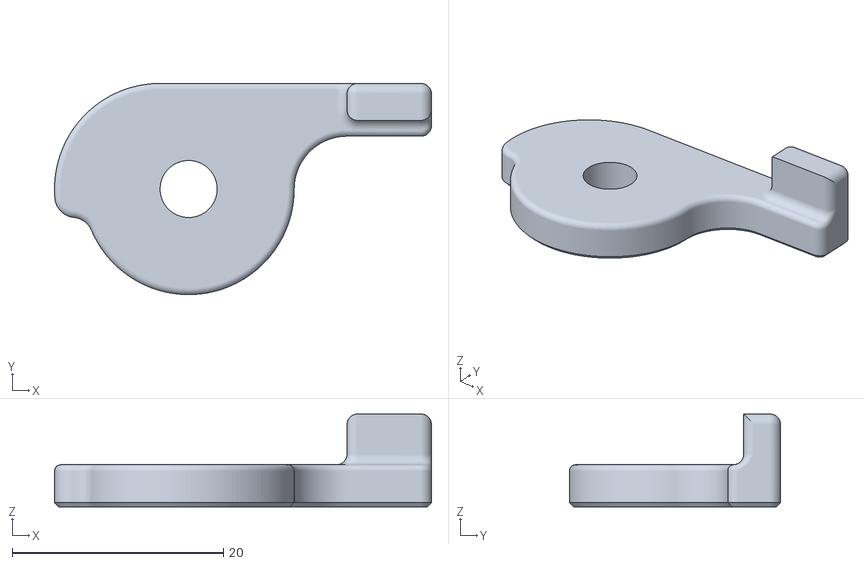
[picture p72: CAD file, 2022-04-12]
Voron-2-2.4r2/Voron-2-2.4r2/STLs/Z_Drive/[a]_belt_tensioner_a_x2.stl
35.7 x 20.0 x 8.80
