verdammte/voron_2.4/Mobius-Extruder-M4/Mobius-Extruder-M4/STLs/[a]_guidler_mirror.stl

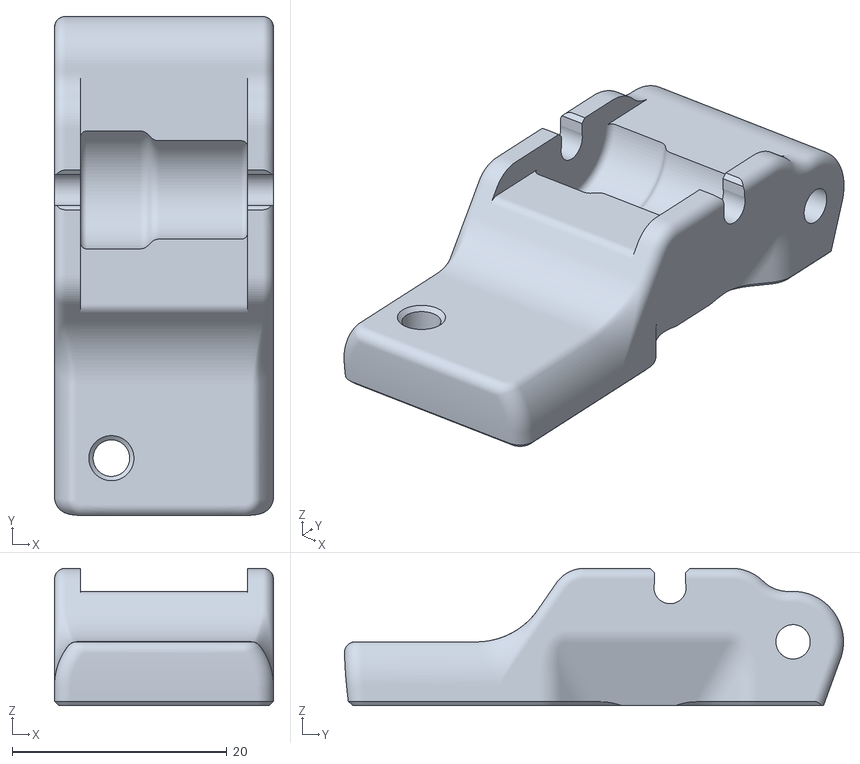
[picture p73: CAD file, 2022-04-12]
Mobius-Extruder-M4/Mobius-Extruder-M4/STLs/[a]_guidler_mirror.stl
20.4 x 46.5 x 12.8
