verdammte/voron_2.4/Voron-2-2.4r2/Voron-2-2.4r2/Drawing_DXFs/Panels/350_Bottom_Panel.dxf

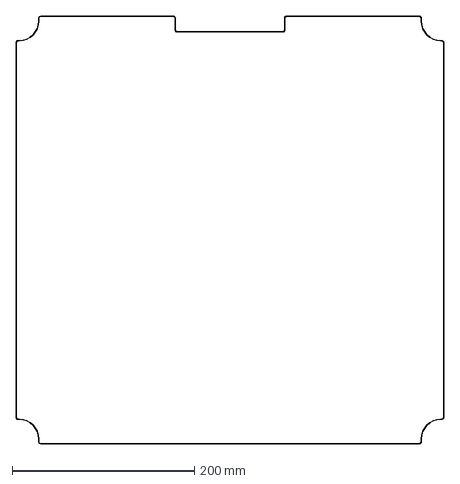
[picture p75: CAD file, 2022-04-12]
Voron-2-2.4r2/Voron-2-2.4r2/Drawing_DXFs/Panels/350_Bottom_Panel.dxf
469.2 x 469.2 mm
