verdammte/voron_2.4/Voron-2-2.4r2/Voron-2-2.4r2/STLs/Electronics_Bay/Controller_Mounts/Duet2_Duet3Mini5_bracket_set.stl

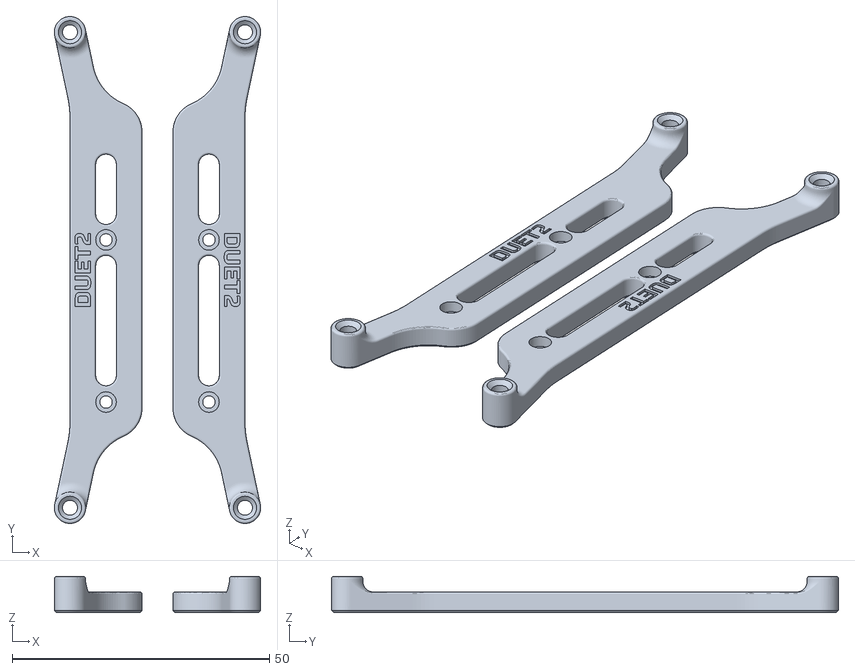
[picture p76: CAD file, 2022-04-12]
Voron-2-2.4r2/Voron-2-2.4r2/STLs/Electronics_Bay/Controller_Mounts/Duet2_Duet3Mini5_bracket_set.stl
40.1 x 98.5 x 7.00
