verdammte/voron_2.4/Voron-2-2.4r2/Voron-2-2.4r2/STLs/Electronics_Bay/rs25_psu_bracket.stl

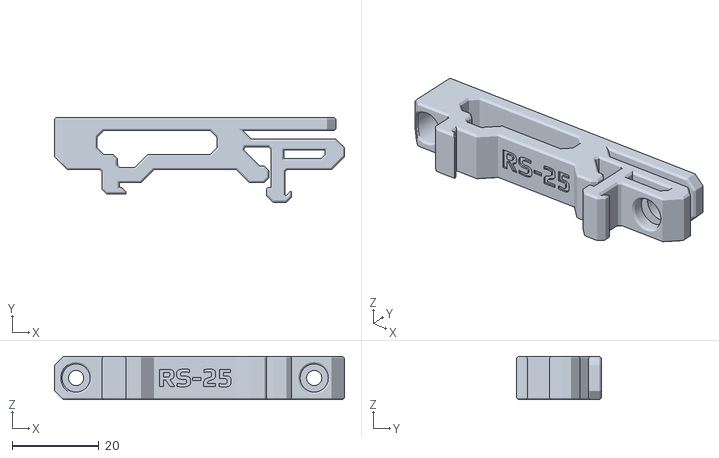
[picture p77: CAD file, 2022-04-12]
Voron-2-2.4r2/Voron-2-2.4r2/STLs/Electronics_Bay/rs25_psu_bracket.stl
67.0 x 19.6 x 10.0
