verdammte/voron_2.4/Voron-2-2.4r2/Voron-2-2.4r2/STLs/Exhaust_Filter/exhaust_filter_housing.stl

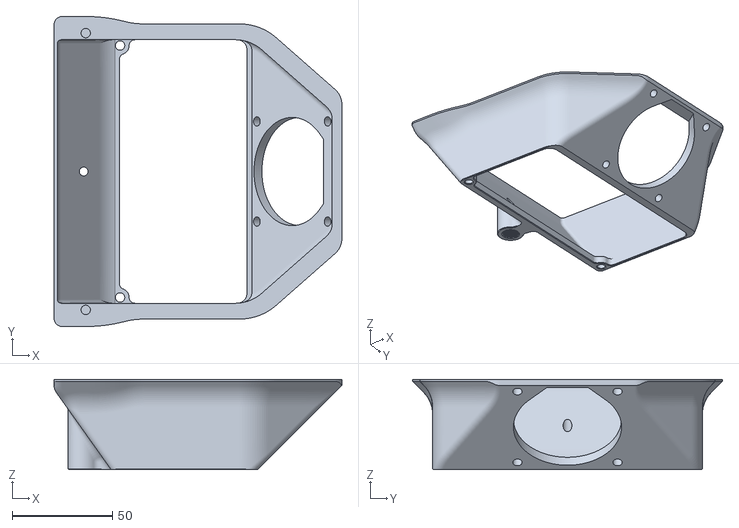
[picture p78: CAD file, 2022-04-12]
Voron-2-2.4r2/Voron-2-2.4r2/STLs/Exhaust_Filter/exhaust_filter_housing.stl
143.7 x 154.8 x 45.0
