verdammte/voron_2.4/Voron-2-2.4r2/Voron-2-2.4r2/STLs/Gantry/[a]_z_belt_clip_lower_x4.stl

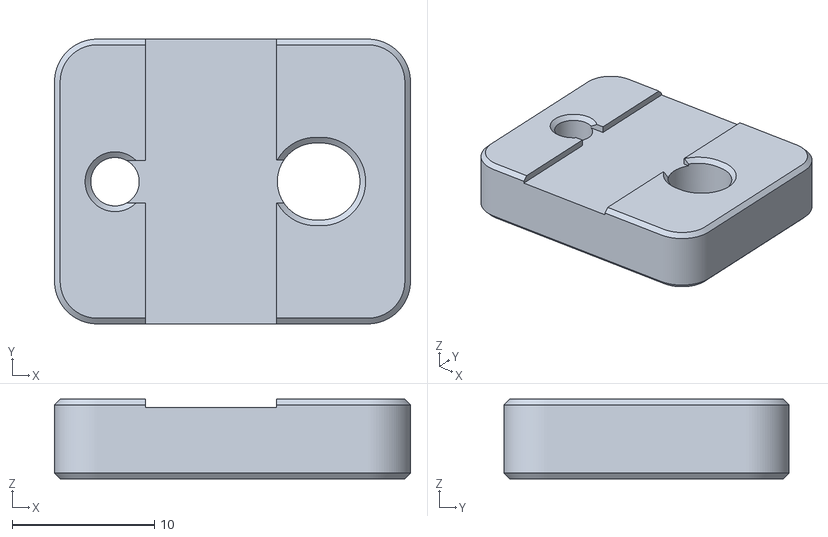
[picture p79: CAD file, 2022-04-12]
Voron-2-2.4r2/Voron-2-2.4r2/STLs/Gantry/[a]_z_belt_clip_lower_x4.stl
25.0 x 20.0 x 5.60
