verdammte/voron_2.4/Voron-2-2.4r2/Voron-2-2.4r2/STLs/Gantry/AB_Drive_Units/b_drive_frame_upper.stl

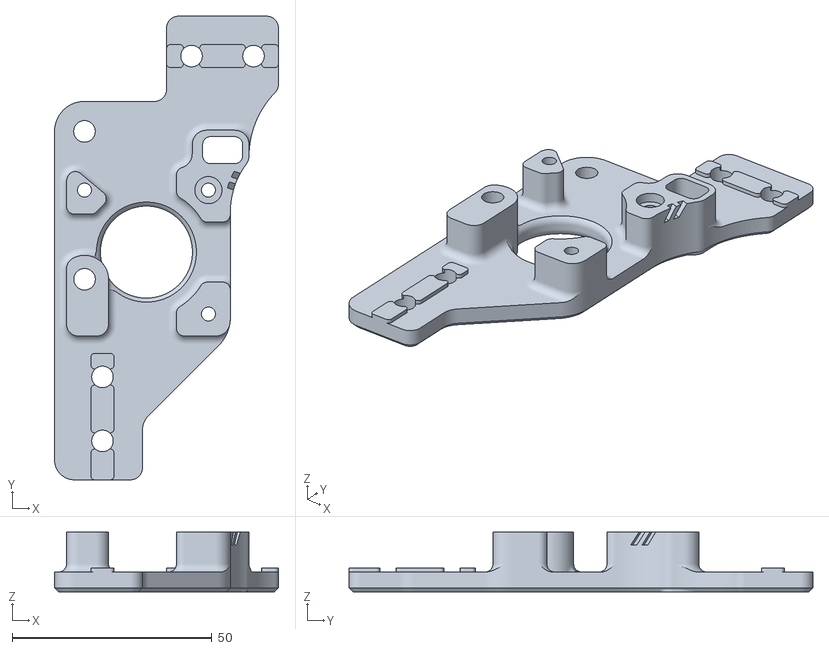
[picture p80: CAD file, 2022-04-12]
Voron-2-2.4r2/Voron-2-2.4r2/STLs/Gantry/AB_Drive_Units/b_drive_frame_upper.stl
56.0 x 116.0 x 15.0
