verdammte/voron_2.4/Voron-2-2.4r2/Voron-2-2.4r2/STLs/Gantry/Front_Idlers/front_idler_right_upper.stl

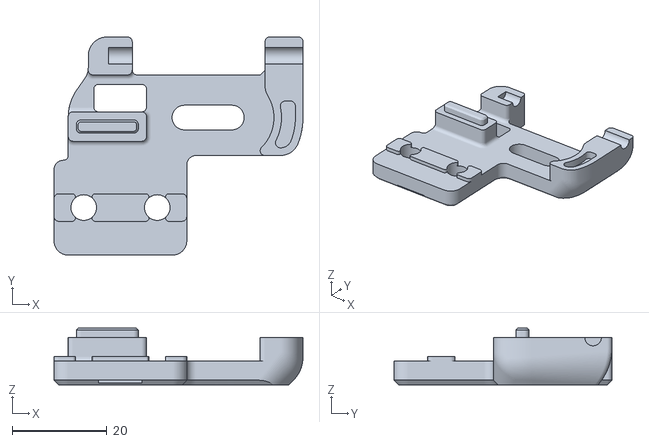
[picture p81: CAD file, 2022-04-12]
Voron-2-2.4r2/Voron-2-2.4r2/STLs/Gantry/Front_Idlers/front_idler_right_upper.stl
52.5 x 46.0 x 12.0
