verdammte/voron_2.4/Voron-2-2.4r2/Voron-2-2.4r2/STLs/Gantry/X_Axis/X_Carriage/Bowden/bowden_dual_front_a.stl

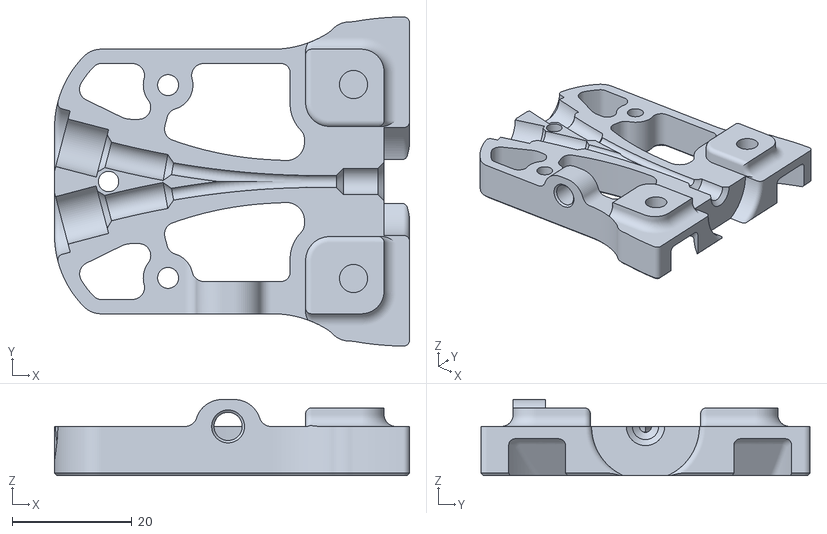
[picture p82: CAD file, 2022-04-12]
Voron-2-2.4r2/Voron-2-2.4r2/STLs/Gantry/X_Axis/X_Carriage/Bowden/bowden_dual_front_a.stl
59.3 x 55.0 x 12.7
