verdammte/voron_2.4/Voron-2-2.4r2/Voron-2-2.4r2/STLs/Gantry/X_Axis/X_Carriage/Direct_Feed/extruder_body.stl

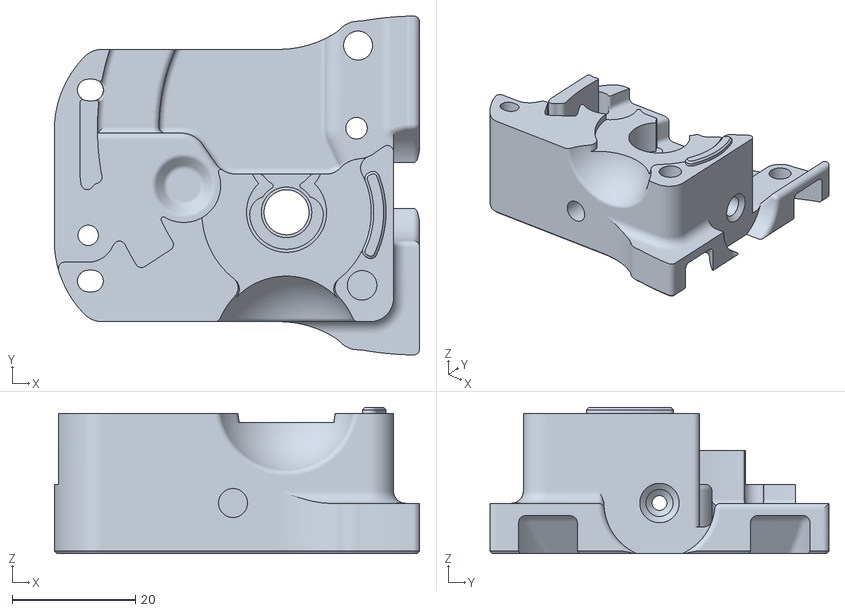
[picture p83: CAD file, 2022-04-12]
Voron-2-2.4r2/Voron-2-2.4r2/STLs/Gantry/X_Axis/X_Carriage/Direct_Feed/extruder_body.stl
59.3 x 55.0 x 23.7
