verdammte/voron_2.4/Voron-2-2.4r2/Voron-2-2.4r2/STLs/Gantry/Z_Joints/z_joint_lower_x4.stl

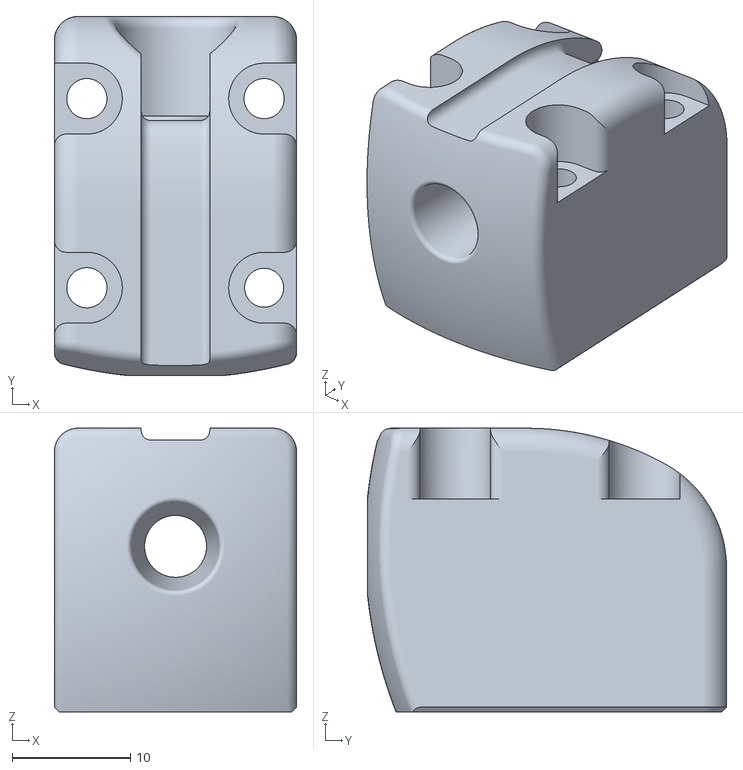
[picture p86: CAD file, 2022-04-12]
Voron-2-2.4r2/Voron-2-2.4r2/STLs/Gantry/Z_Joints/z_joint_lower_x4.stl
20.5 x 30.4 x 24.0
