verdammte/voron_2.4/Voron-2-2.4r2/Voron-2-2.4r2/STLs/Skirts/350/rear_center_skirt_350.stl

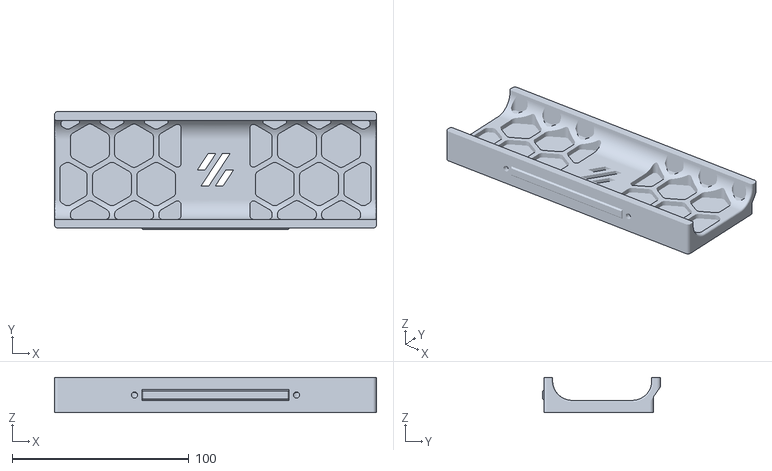
[picture p87: CAD file, 2022-04-12]
Voron-2-2.4r2/Voron-2-2.4r2/STLs/Skirts/350/rear_center_skirt_350.stl
182.0 x 66.8 x 20.0
