verdammte/voron_2.4/Voron-2-2.4r2/Voron-2-2.4r2/STLs/Skirts/power_inlet_filtered.stl

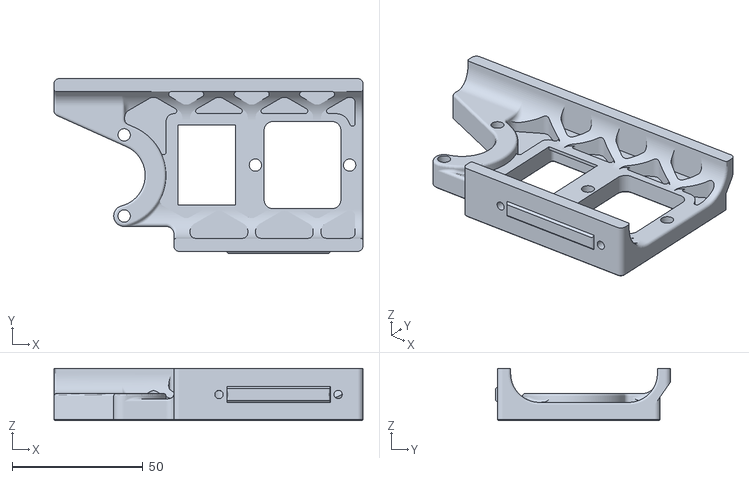
[picture p88: CAD file, 2022-04-12]
Voron-2-2.4r2/Voron-2-2.4r2/STLs/Skirts/power_inlet_filtered.stl
118.0 x 66.8 x 20.0
