verdammte/voron_2.4/Voron-2-2.4r2/Voron-2-2.4r2/STLs/Superceded_Parts/Frame_Brackets/raspberry_pi_bracket.stl

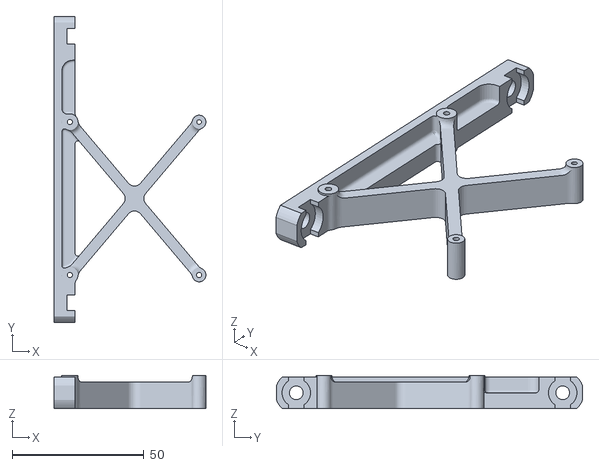
[picture p89: CAD file, 2022-04-12]
Voron-2-2.4r2/Voron-2-2.4r2/STLs/Superceded_Parts/Frame_Brackets/raspberry_pi_bracket.stl
57.6 x 116.0 x 12.6
