verdammte/voron_2.4/Voron-2-2.4r2/Voron-2-2.4r2/STLs/Superceded_Parts/MGN9_X/xy_joint_right_upper_MGN9.stl

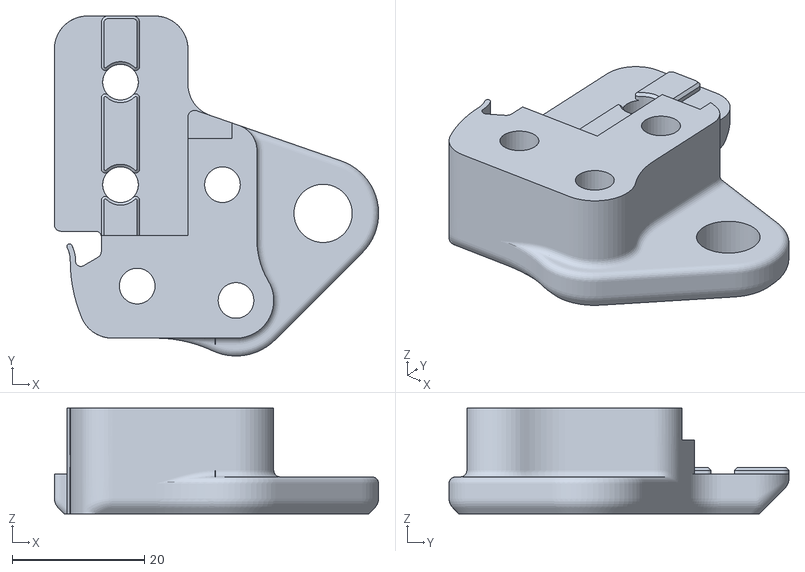
[picture p90: CAD file, 2022-04-12]
Voron-2-2.4r2/Voron-2-2.4r2/STLs/Superceded_Parts/MGN9_X/xy_joint_right_upper_MGN9.stl
49.0 x 51.4 x 16.0
