verdammte/voron_2.4/Voron-2-2.4r2/Voron-2-2.4r2/STLs/Superceded_Parts/ZipChain/XY/zipchain2_xy_link_a.stl

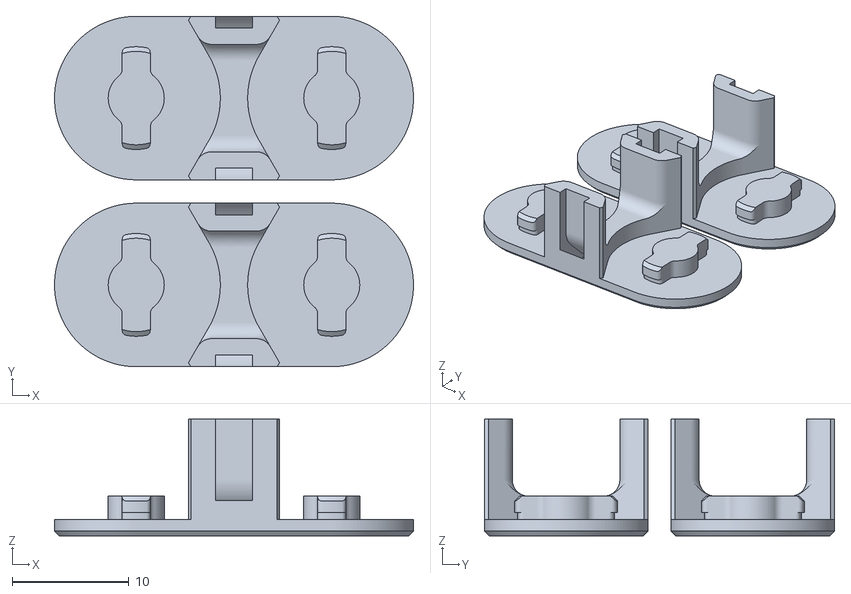
[picture p91: CAD file, 2022-04-12]
Voron-2-2.4r2/Voron-2-2.4r2/STLs/Superceded_Parts/ZipChain/XY/zipchain2_xy_link_a.stl
30.7 x 30.0 x 10.0
