verdammte/voron_2.4/Voron-2-2.4r2/Voron-2-2.4r2/STLs/Test_Prints/Filament_Card_Caddy_25.stl

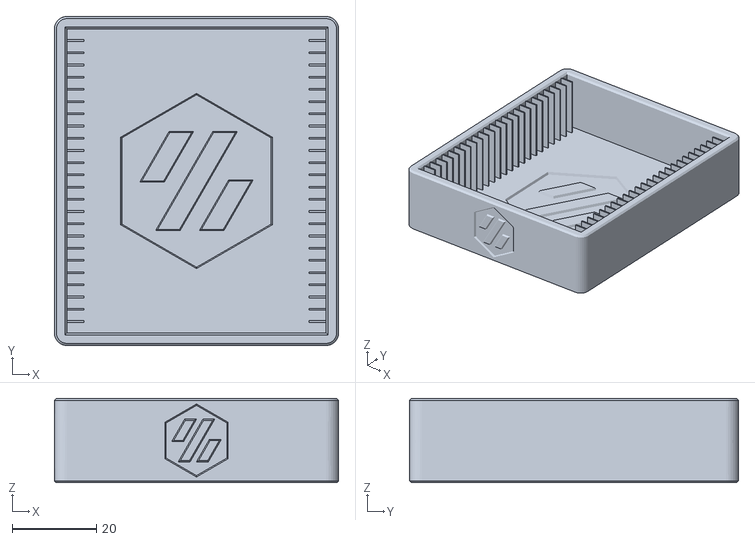
[picture p92: CAD file, 2022-04-12]
Voron-2-2.4r2/Voron-2-2.4r2/STLs/Test_Prints/Filament_Card_Caddy_25.stl
67.5 x 78.1 x 20.0
