verdammte/voron_2.4/Voron-2-2.4r2/Voron-2-2.4r2/STLs/Tools/pulley_jig.stl

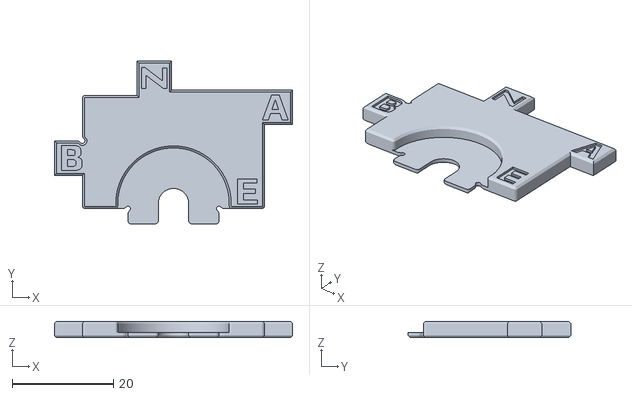
[picture p93: CAD file, 2022-04-12]
Voron-2-2.4r2/Voron-2-2.4r2/STLs/Tools/pulley_jig.stl
47.0 x 32.2 x 3.20
