verdammte/voron_2.4/Voron-2-2.4r2/Voron-2-2.4r2/STLs/Z_Idlers/[a]_z_tensioner_x4_9mm.stl

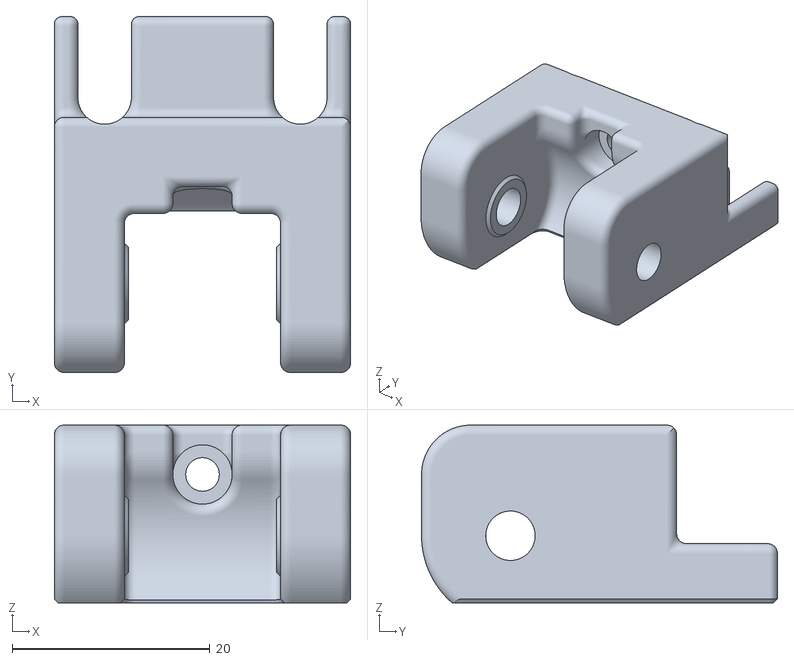
[picture p94: CAD file, 2022-04-12]
Voron-2-2.4r2/Voron-2-2.4r2/STLs/Z_Idlers/[a]_z_tensioner_x4_9mm.stl
30.0 x 36.0 x 18.0
