verdammte/voron_2.4/Mobius-Extruder-M4/Mobius-Extruder-M4/STLs/[a]_80t_gear.stl

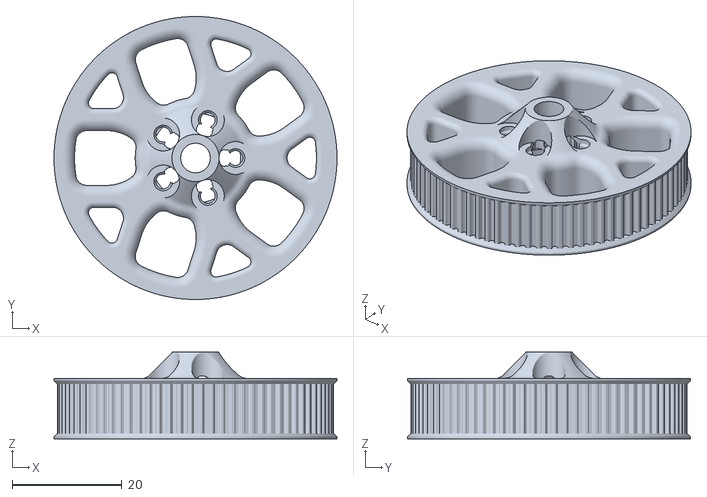
[picture p95: CAD file, 2022-04-12]
Mobius-Extruder-M4/Mobius-Extruder-M4/STLs/[a]_80t_gear.stl
51.6 x 51.6 x 15.8
