verdammte/voron_2.4/Voron-2-2.4r2/Voron-2-2.4r2/Drawing_DXFs/Panels/300_Back_Panel.DXF

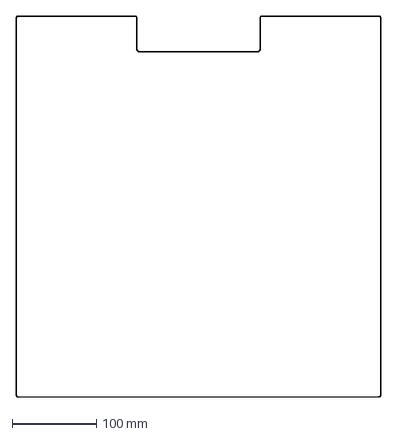
[picture p97: CAD file, 2022-04-12]
Voron-2-2.4r2/Voron-2-2.4r2/Drawing_DXFs/Panels/300_Back_Panel.DXF
433.0 x 453.0 mm
