verdammte/voron_2.4/Voron-2-2.4r2/Voron-2-2.4r2/STLs/Electronics_Bay/PSU_stabilizer_50mm.stl

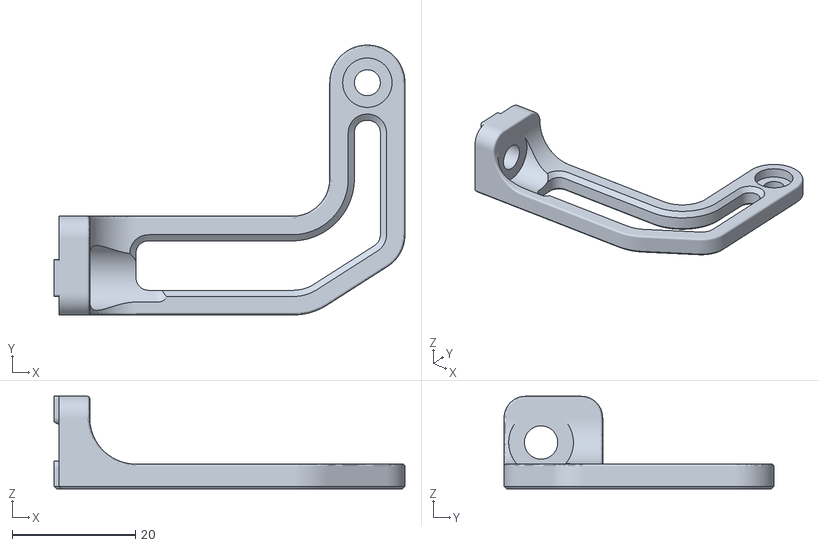
[picture p99: CAD file, 2022-04-12]
Voron-2-2.4r2/Voron-2-2.4r2/STLs/Electronics_Bay/PSU_stabilizer_50mm.stl
56.9 x 43.8 x 15.0
