verdammte/voron_2.4/Voron-2-2.4r2/Voron-2-2.4r2/STLs/Exhaust_Filter/[a]_exhaust_fan_grill.stl

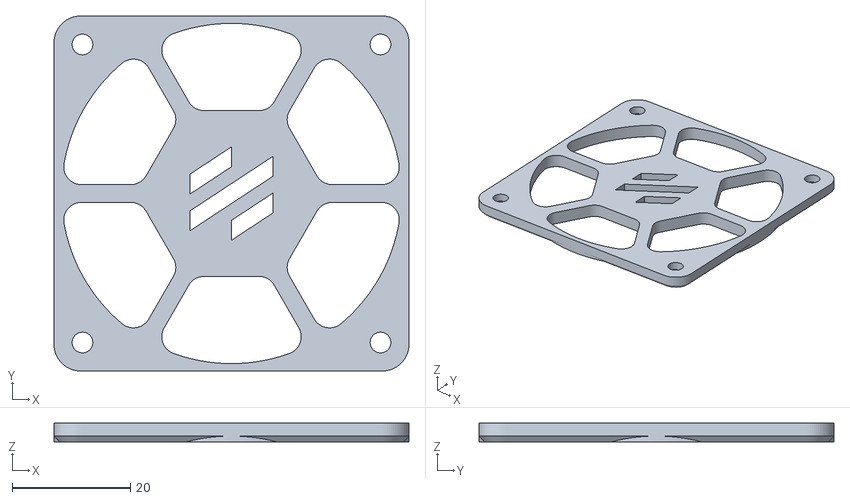
[picture p100: CAD file, 2022-04-12]
Voron-2-2.4r2/Voron-2-2.4r2/STLs/Exhaust_Filter/[a]_exhaust_fan_grill.stl
60.0 x 60.0 x 3.20
