verdammte/voron_2.4/Voron-2-2.4r2/Voron-2-2.4r2/STLs/Gantry/Front_Idlers/[a]_tensioner_left.stl

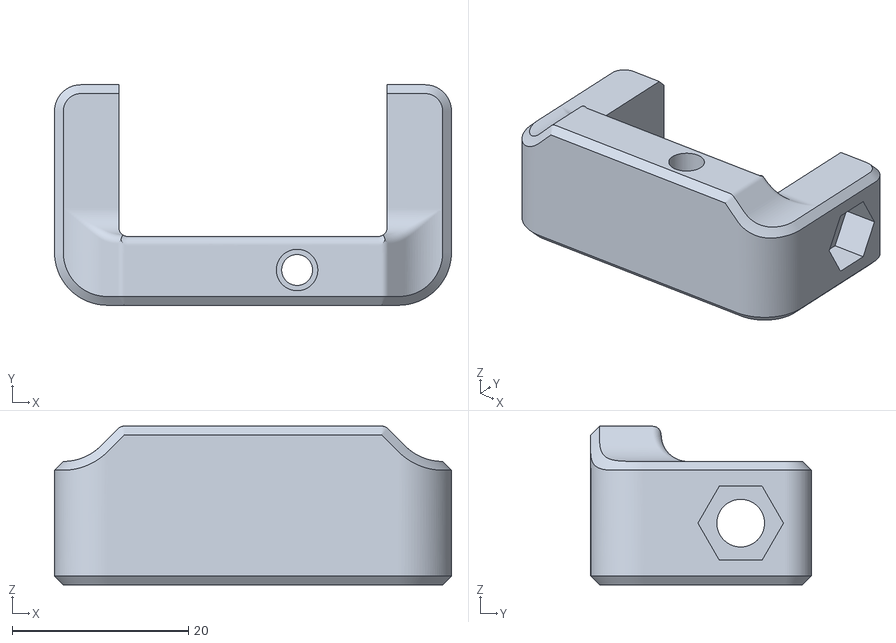
[picture p101: CAD file, 2022-04-12]
Voron-2-2.4r2/Voron-2-2.4r2/STLs/Gantry/Front_Idlers/[a]_tensioner_left.stl
45.0 x 25.0 x 18.0
