verdammte/voron_2.4/Voron-2-2.4r2/Voron-2-2.4r2/STLs/Gantry/X_Axis/X_Carriage/[a]_blower_housing_front.stl

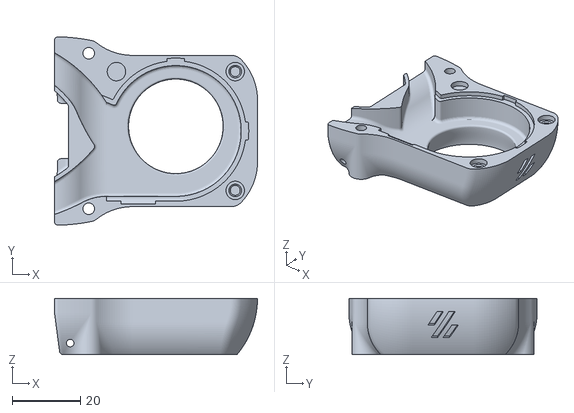
[picture p102: CAD file, 2022-04-12]
Voron-2-2.4r2/Voron-2-2.4r2/STLs/Gantry/X_Axis/X_Carriage/[a]_blower_housing_front.stl
59.3 x 55.0 x 16.5
