verdammte/voron_2.4/Voron-2-2.4r2/Voron-2-2.4r2/STLs/Gantry/X_Axis/X_Carriage/Bowden/bowden_single_tl_collet_adapter.stl

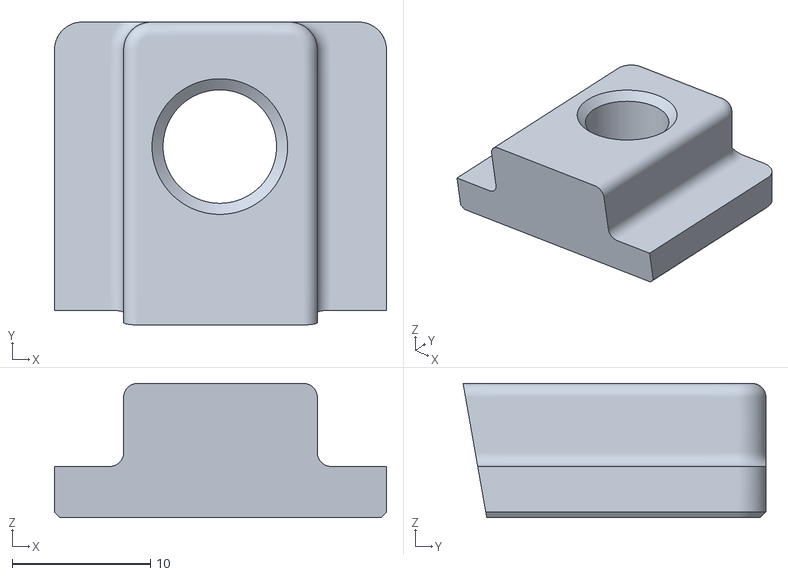
[picture p103: CAD file, 2022-04-12]
Voron-2-2.4r2/Voron-2-2.4r2/STLs/Gantry/X_Axis/X_Carriage/Bowden/bowden_single_tl_collet_adapter.stl
24.0 x 21.9 x 9.70
