verdammte/voron_2.4/Voron-2-2.4r2/Voron-2-2.4r2/STLs/Gantry/X_Axis/X_Carriage/Direct_Feed/extruder_motor_plate.stl

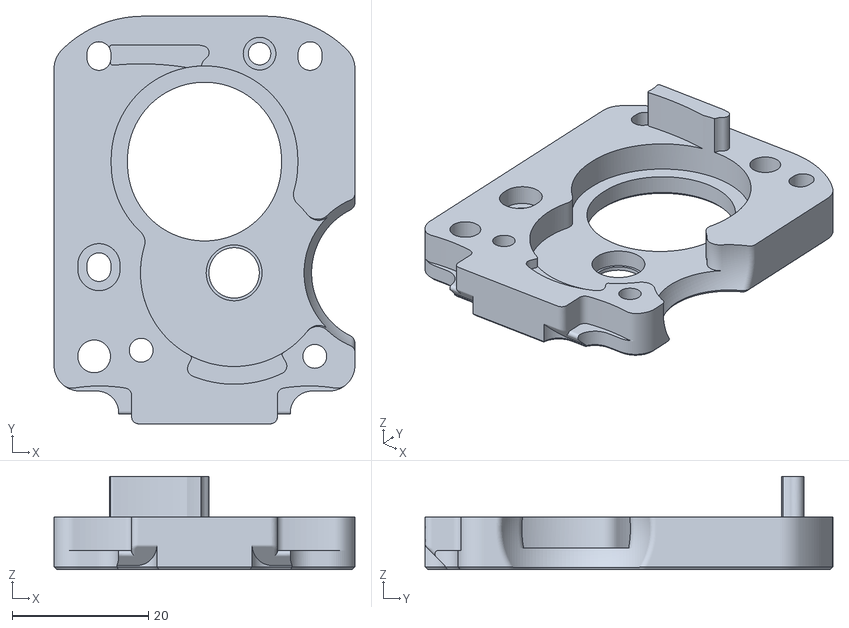
[picture p104: CAD file, 2022-04-12]
Voron-2-2.4r2/Voron-2-2.4r2/STLs/Gantry/X_Axis/X_Carriage/Direct_Feed/extruder_motor_plate.stl
44.2 x 59.9 x 13.7
