verdammte/voron_2.4/Voron-2-2.4r2/Voron-2-2.4r2/STLs/Gantry/X_Axis/XY_Joints/xy_joint_right_lower_MGN12.stl

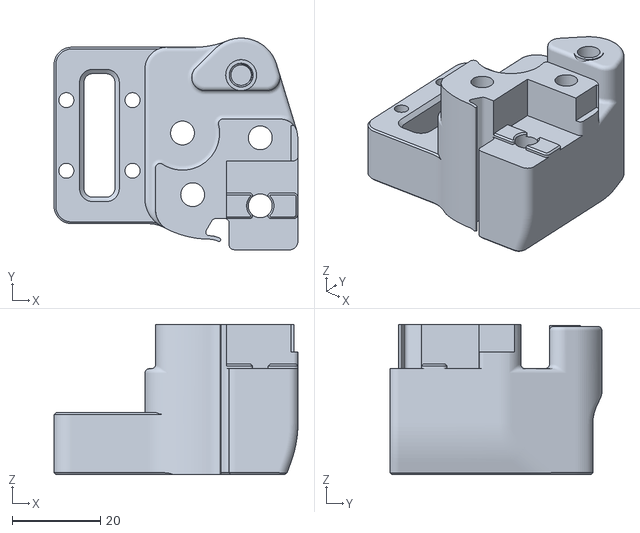
[picture p105: CAD file, 2022-04-12]
Voron-2-2.4r2/Voron-2-2.4r2/STLs/Gantry/X_Axis/XY_Joints/xy_joint_right_lower_MGN12.stl
55.3 x 48.0 x 34.0
