verdammte/voron_2.4/Voron-2-2.4r2/Voron-2-2.4r2/STLs/Gantry/z_chain_bottom_anchor.stl

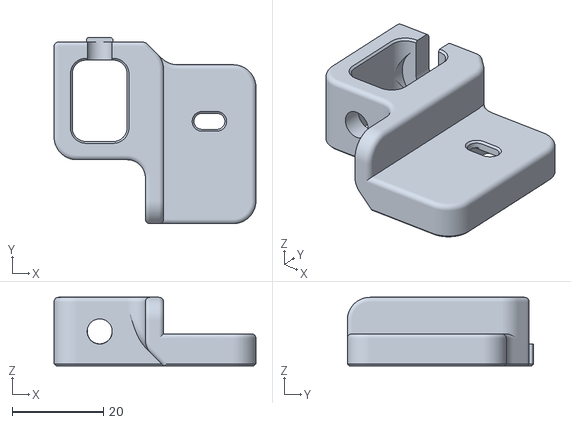
[picture p106: CAD file, 2022-04-12]
Voron-2-2.4r2/Voron-2-2.4r2/STLs/Gantry/z_chain_bottom_anchor.stl
44.2 x 40.8 x 15.0
