verdammte/voron_2.4/Voron-2-2.4r2/Voron-2-2.4r2/STLs/Panel_Mounting/bottom_panel_hinge_x2.stl

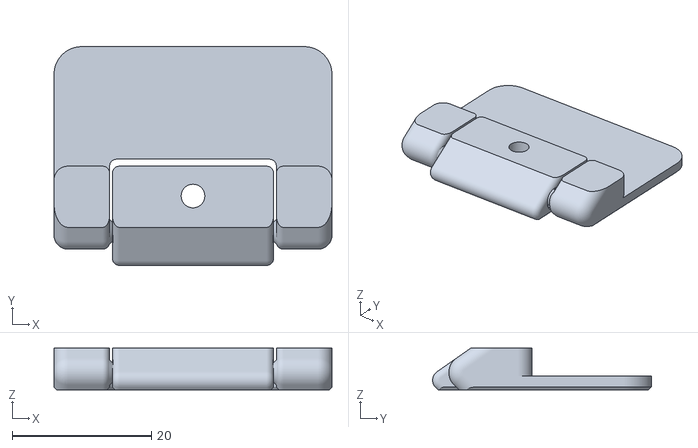
[picture p107: CAD file, 2022-04-12]
Voron-2-2.4r2/Voron-2-2.4r2/STLs/Panel_Mounting/bottom_panel_hinge_x2.stl
40.0 x 31.5 x 6.00
