verdammte/voron_2.4/Voron-2-2.4r2/Voron-2-2.4r2/STLs/Panel_Mounting/Front_Doors/door_hinge_x6.stl

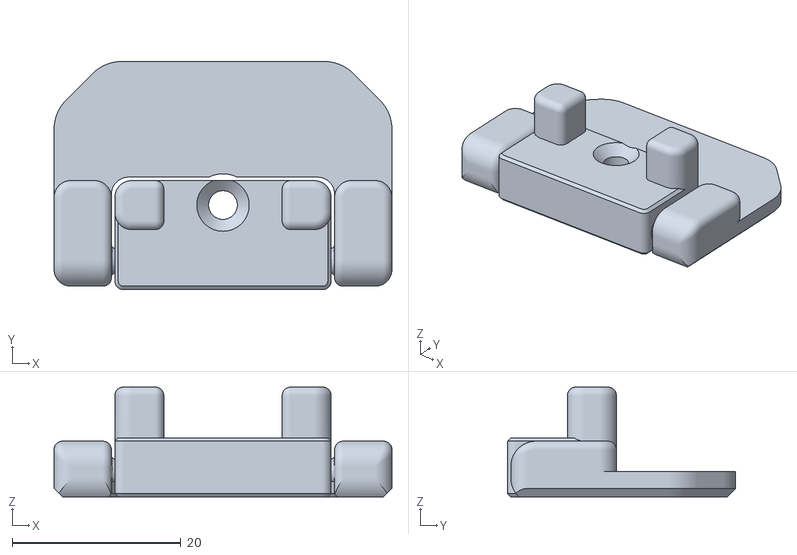
[picture p108: CAD file, 2022-04-12]
Voron-2-2.4r2/Voron-2-2.4r2/STLs/Panel_Mounting/Front_Doors/door_hinge_x6.stl
40.0 x 27.0 x 13.0
