verdammte/voron_2.4/Voron-2-2.4r2/Voron-2-2.4r2/STLs/Skirts/250/rear_center_skirt_250.stl

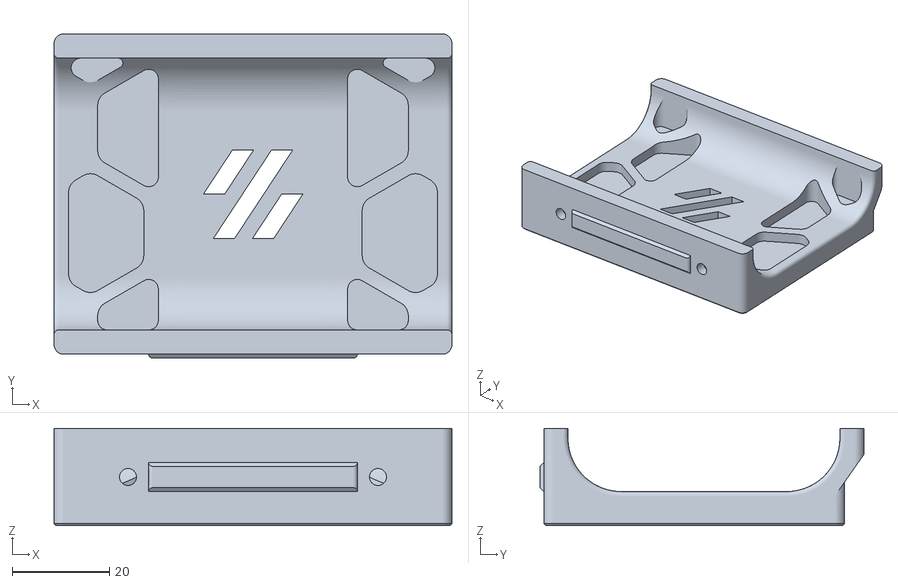
[picture p109: CAD file, 2022-04-12]
Voron-2-2.4r2/Voron-2-2.4r2/STLs/Skirts/250/rear_center_skirt_250.stl
82.0 x 66.8 x 20.0
