verdammte/voron_2.4/Voron-2-2.4r2/Voron-2-2.4r2/STLs/Skirts/[a]_fan_grill_open_optional_x2.stl

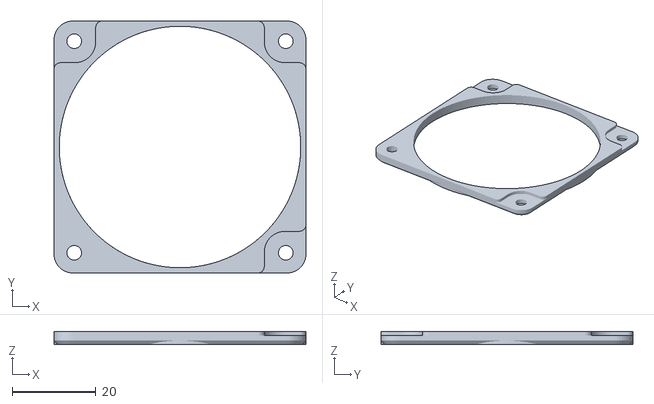
[picture p110: CAD file, 2022-04-12]
Voron-2-2.4r2/Voron-2-2.4r2/STLs/Skirts/[a]_fan_grill_open_optional_x2.stl
60.0 x 60.0 x 3.20
