verdammte/voron_2.4/Voron-2-2.4r2/Voron-2-2.4r2/STLs/Superceded_Parts/Frame_Brackets/rs_25_psu_bracket_frame.stl

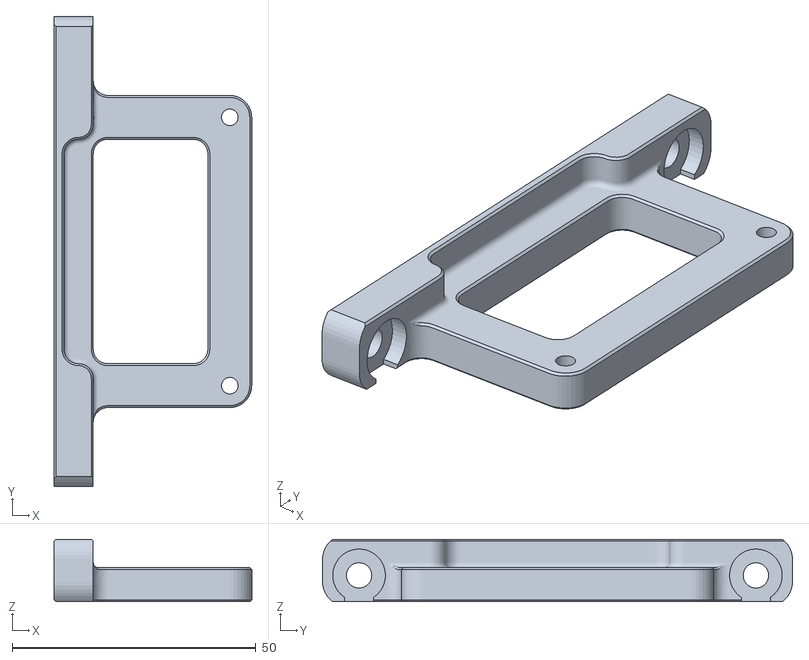
[picture p111: CAD file, 2022-04-12]
Voron-2-2.4r2/Voron-2-2.4r2/STLs/Superceded_Parts/Frame_Brackets/rs_25_psu_bracket_frame.stl
40.5 x 96.3 x 12.8
