verdammte/voron_2.4/Voron-2-2.4r2/Voron-2-2.4r2/STLs/Superceded_Parts/MGN9_X/x_carriage_frame_left_MGN9.stl

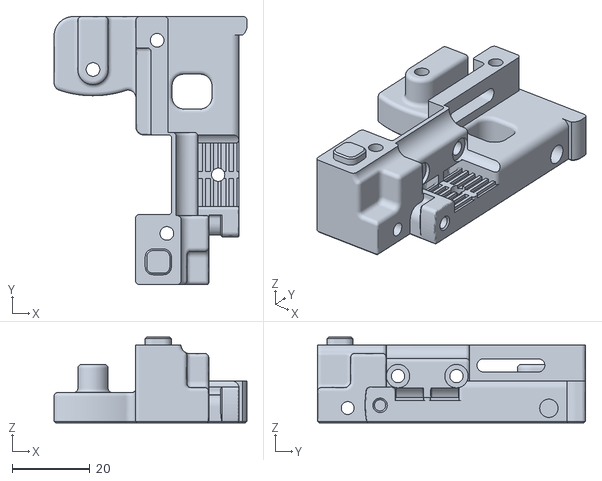
[picture p112: CAD file, 2022-04-12]
Voron-2-2.4r2/Voron-2-2.4r2/STLs/Superceded_Parts/MGN9_X/x_carriage_frame_left_MGN9.stl
49.5 x 68.8 x 22.0
