verdammte/voron_2.4/Voron-2-2.4r2/Voron-2-2.4r2/STLs/Superceded_Parts/ZipChain/Z/zipchain2_z_link_a.stl

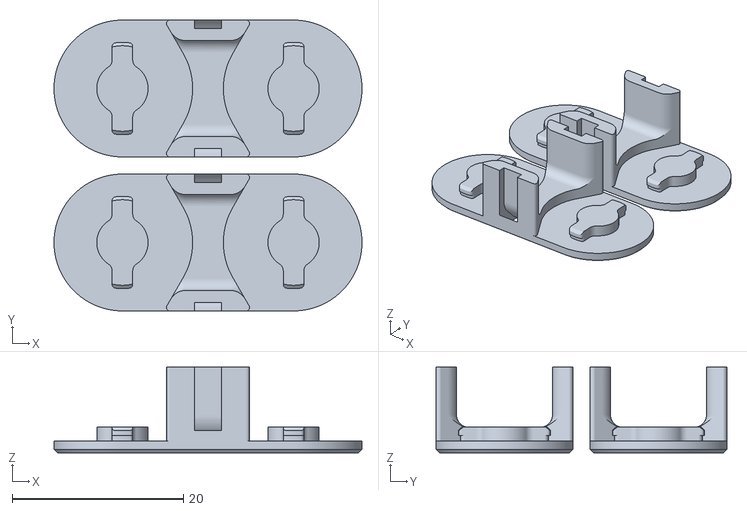
[picture p113: CAD file, 2022-04-12]
Voron-2-2.4r2/Voron-2-2.4r2/STLs/Superceded_Parts/ZipChain/Z/zipchain2_z_link_a.stl
36.0 x 34.0 x 10.0
