verdammte/voron_2.4/Voron-2-2.4r2/Voron-2-2.4r2/STLs/Test_Prints/Heatset_Practice.stl

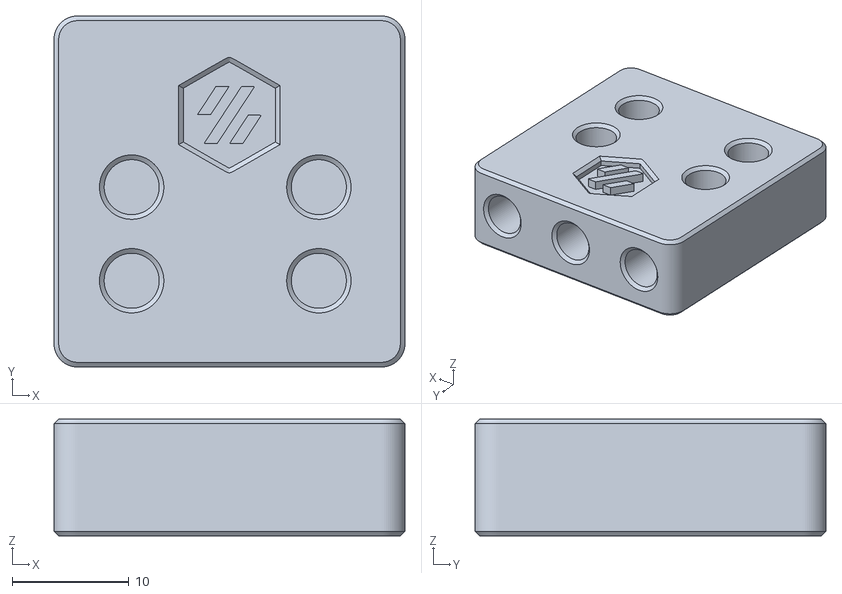
[picture p114: CAD file, 2022-04-12]
Voron-2-2.4r2/Voron-2-2.4r2/STLs/Test_Prints/Heatset_Practice.stl
30.0 x 30.0 x 10.0
