verdammte/voron_2.4/Voron-2-2.4r2/Voron-2-2.4r2/STLs/Tools/bed_hole_marking_template_x1_Rev2.STL

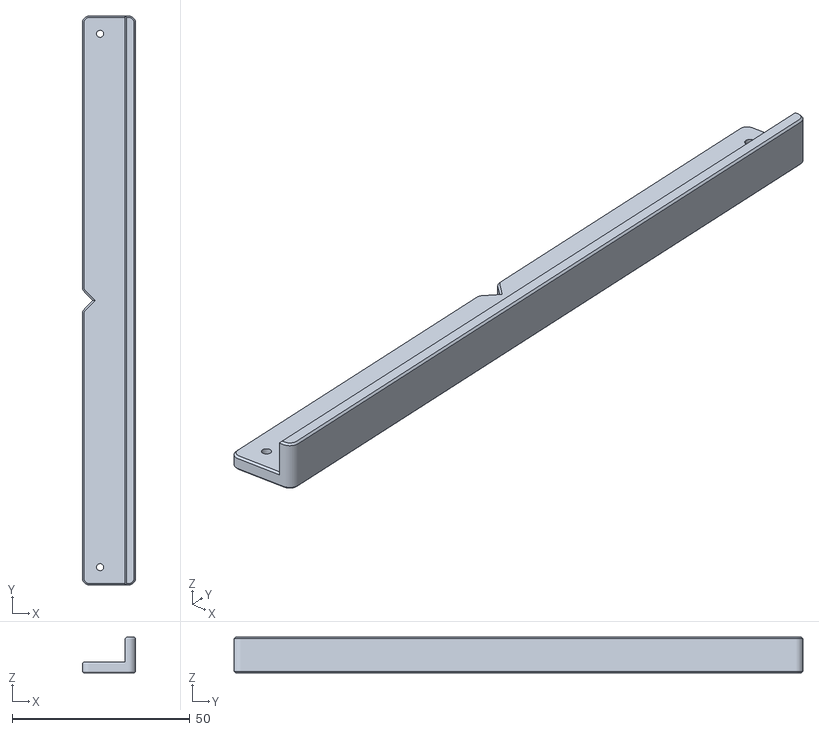
[picture p115: CAD file, 2022-04-12]
Voron-2-2.4r2/Voron-2-2.4r2/STLs/Tools/bed_hole_marking_template_x1_Rev2.STL
15.0 x 160.0 x 10.0
