verdammte/voron_2.4/Voron-2-2.4r2/Voron-2-2.4r2/STLs/Z_Drive/[a]_z_drive_baseplate_b_x2.stl

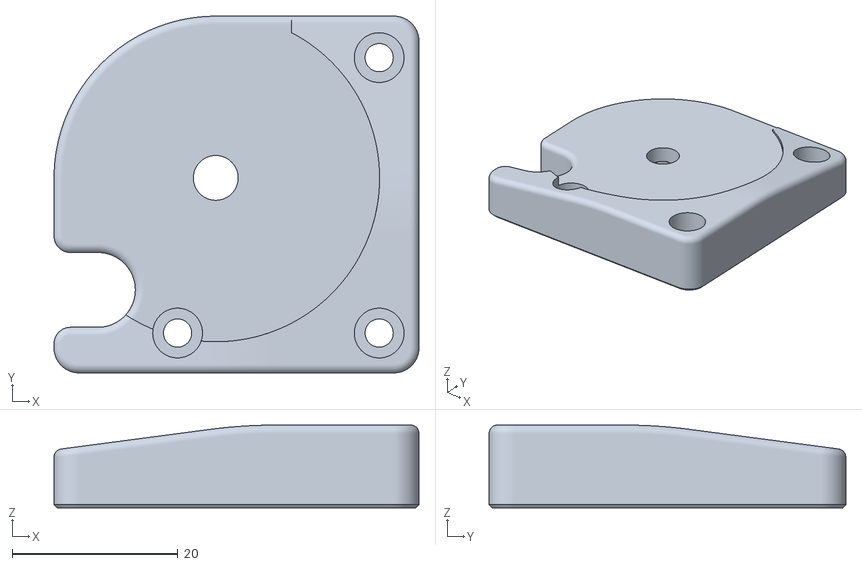
[picture p116: CAD file, 2022-04-12]
Voron-2-2.4r2/Voron-2-2.4r2/STLs/Z_Drive/[a]_z_drive_baseplate_b_x2.stl
44.0 x 43.0 x 10.0
