verdammte/voron_2.4/Voron-2-2.4r2/Voron-2-2.4r2/Drawing_DXFs/Panels/300_Deck_Panel.dxf

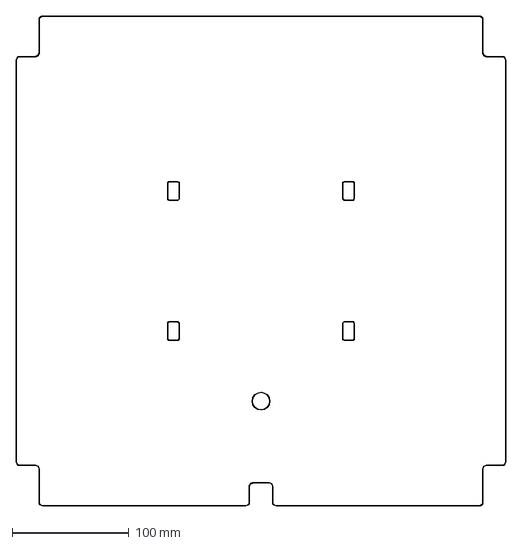
[picture p117: CAD file, 2022-04-12]
Voron-2-2.4r2/Voron-2-2.4r2/Drawing_DXFs/Panels/300_Deck_Panel.dxf
419.0 x 419.0 mm
