verdammte/voron_2.4/Voron-2-2.4r2/Voron-2-2.4r2/STLs/Electronics_Bay/Controller_Mounts/S6_bracket_set.stl

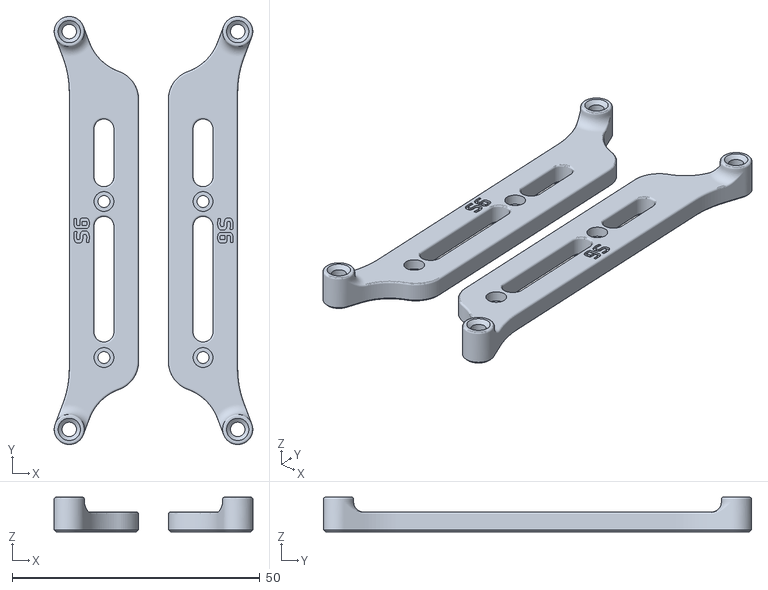
[picture p118: CAD file, 2022-04-12]
Voron-2-2.4r2/Voron-2-2.4r2/STLs/Electronics_Bay/Controller_Mounts/S6_bracket_set.stl
40.1 x 86.4 x 7.00
