verdammte/voron_2.4/Voron-2-2.4r2/Voron-2-2.4r2/STLs/Electronics_Bay/lrs_200_psu_bracket_x2.stl

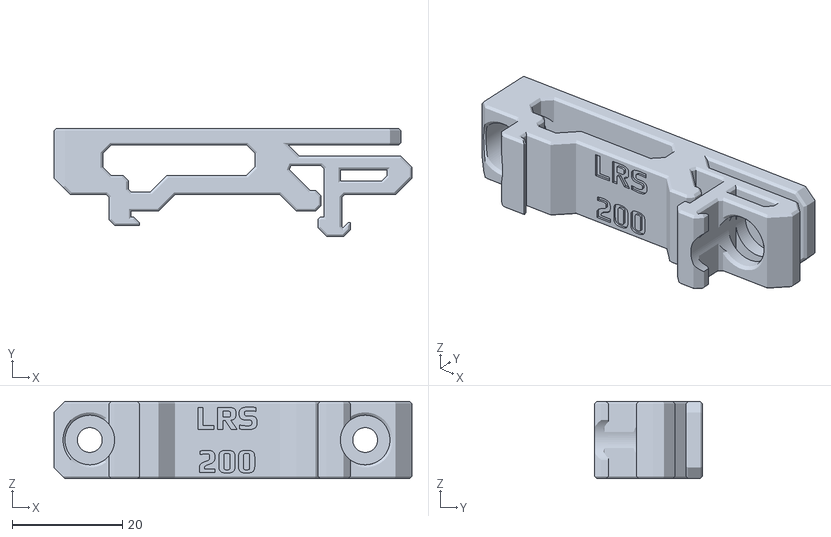
[picture p119: CAD file, 2022-04-12]
Voron-2-2.4r2/Voron-2-2.4r2/STLs/Electronics_Bay/lrs_200_psu_bracket_x2.stl
65.0 x 19.6 x 14.0
