verdammte/voron_2.4/Voron-2-2.4r2/Voron-2-2.4r2/STLs/Exhaust_Filter/[a]_filter_access_cover.stl

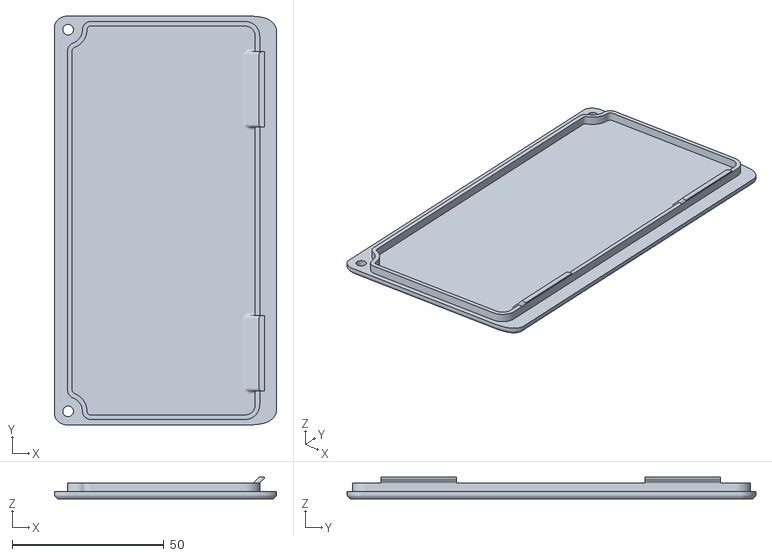
[picture p120: CAD file, 2022-04-12]
Voron-2-2.4r2/Voron-2-2.4r2/STLs/Exhaust_Filter/[a]_filter_access_cover.stl
73.2 x 134.8 x 7.20
