verdammte/voron_2.4/Voron-2-2.4r2/Voron-2-2.4r2/STLs/Gantry/AB_Drive_Units/[a]_z_chain_retainer_bracket_x2.stl

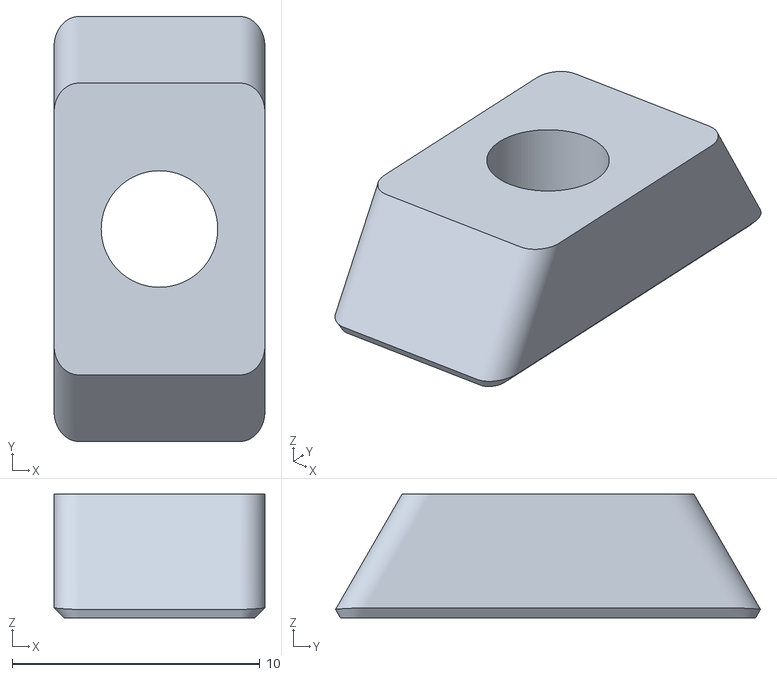
[picture p121: CAD file, 2022-04-12]
Voron-2-2.4r2/Voron-2-2.4r2/STLs/Gantry/AB_Drive_Units/[a]_z_chain_retainer_bracket_x2.stl
8.50 x 17.1 x 5.00
