verdammte/voron_2.4/Voron-2-2.4r2/Voron-2-2.4r2/STLs/Gantry/Front_Idlers/front_idler_right_lower.stl

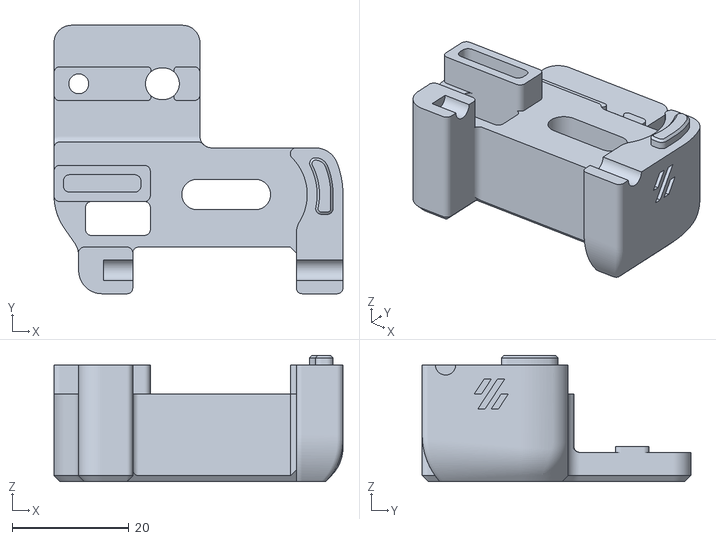
[picture p122: CAD file, 2022-04-12]
Voron-2-2.4r2/Voron-2-2.4r2/STLs/Gantry/Front_Idlers/front_idler_right_lower.stl
49.5 x 46.0 x 21.6
