verdammte/voron_2.4/Voron-2-2.4r2/Voron-2-2.4r2/STLs/Gantry/X_Axis/X_Carriage/Direct_Feed/chain_anchor_3hole.stl

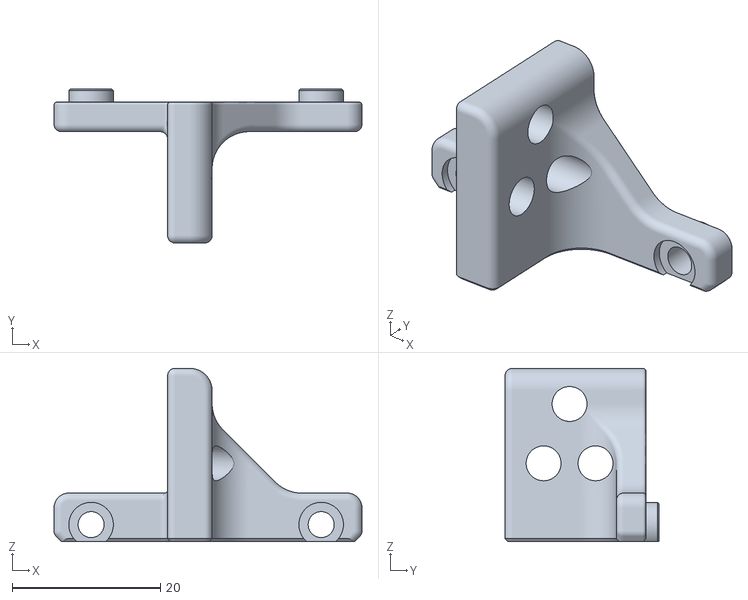
[picture p124: CAD file, 2022-04-12]
Voron-2-2.4r2/Voron-2-2.4r2/STLs/Gantry/X_Axis/X_Carriage/Direct_Feed/chain_anchor_3hole.stl
41.5 x 20.7 x 23.4
