verdammte/voron_2.4/Voron-2-2.4r2/Voron-2-2.4r2/STLs/Panel_Mounting/bottom_panel_clip_x4.stl

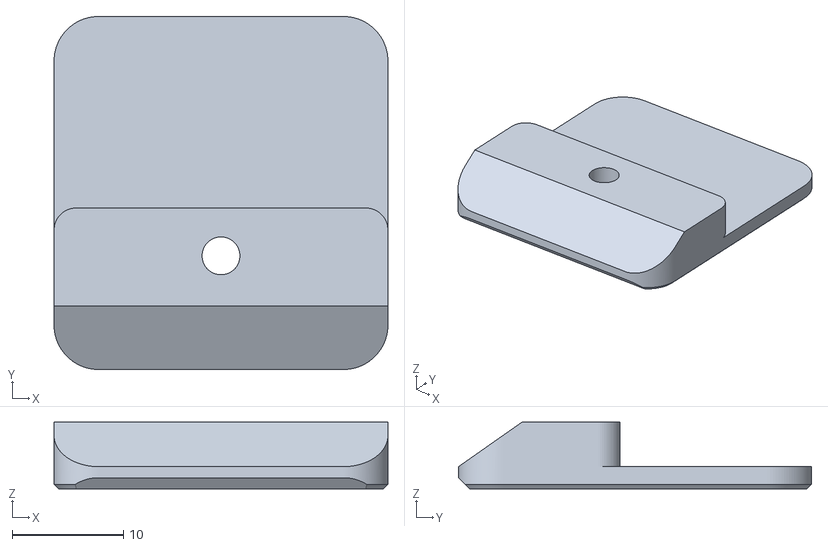
[picture p126: CAD file, 2022-04-12]
Voron-2-2.4r2/Voron-2-2.4r2/STLs/Panel_Mounting/bottom_panel_clip_x4.stl
30.0 x 31.7 x 6.00
