verdammte/voron_2.4/Voron-2-2.4r2/Voron-2-2.4r2/STLs/Skirts/300/rear_center_skirt_300.stl

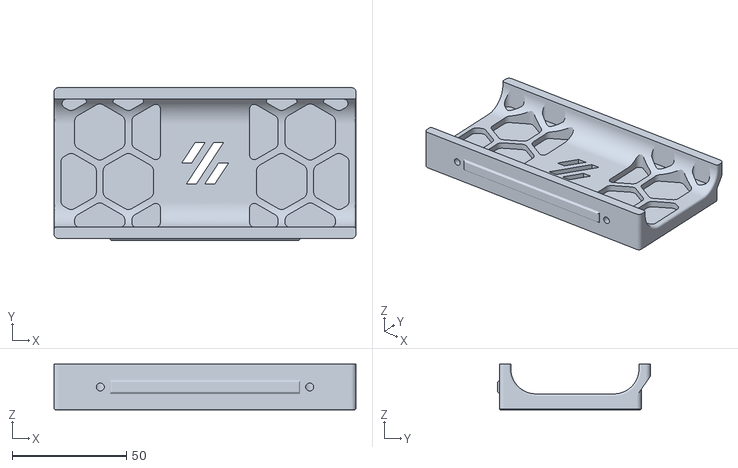
[picture p127: CAD file, 2022-04-12]
Voron-2-2.4r2/Voron-2-2.4r2/STLs/Skirts/300/rear_center_skirt_300.stl
132.0 x 66.8 x 20.0
