verdammte/voron_2.4/Voron-2-2.4r2/Voron-2-2.4r2/STLs/Superceded_Parts/Frame_Brackets/skr_mini_e3_bracket_frame.stl

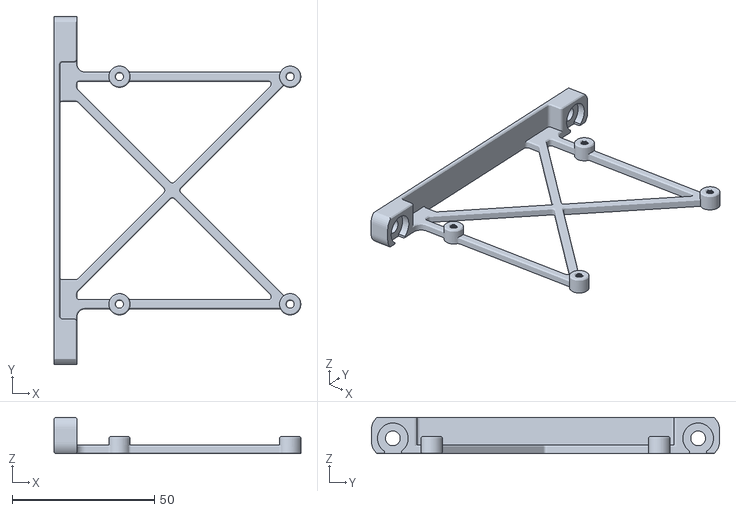
[picture p128: CAD file, 2022-04-12]
Voron-2-2.4r2/Voron-2-2.4r2/STLs/Superceded_Parts/Frame_Brackets/skr_mini_e3_bracket_frame.stl
86.8 x 122.3 x 12.8
