verdammte/voron_2.4/Voron-2-2.4r2/Voron-2-2.4r2/STLs/Superceded_Parts/MGN9_X/xy_joint_right_lower_MGN9.stl

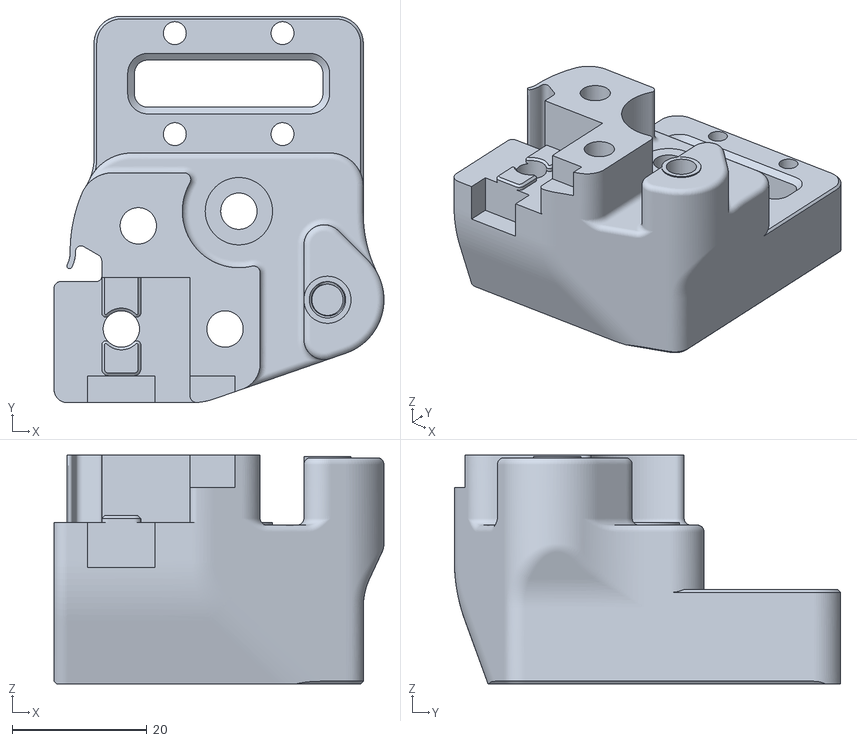
[picture p129: CAD file, 2022-04-12]
Voron-2-2.4r2/Voron-2-2.4r2/STLs/Superceded_Parts/MGN9_X/xy_joint_right_lower_MGN9.stl
49.0 x 57.4 x 34.0
