verdammte/voron_2.4/Voron-2-2.4r2/Voron-2-2.4r2/STLs/Test_Prints/Filament_Card.stl

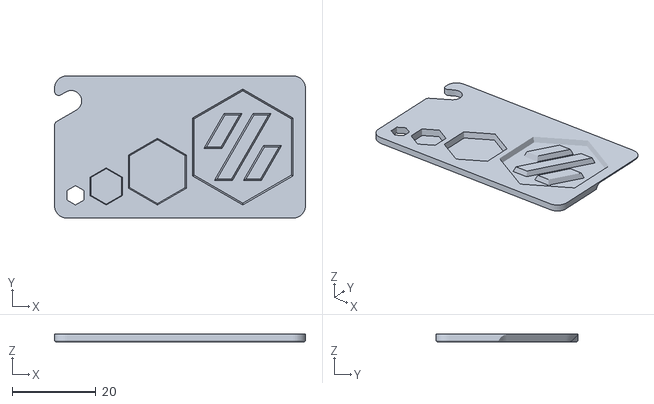
[picture p130: CAD file, 2022-04-12]
Voron-2-2.4r2/Voron-2-2.4r2/STLs/Test_Prints/Filament_Card.stl
60.0 x 34.0 x 2.00
