verdammte/voron_2.4/Voron-2-2.4r2/Voron-2-2.4r2/STLs/Tools/MGN12_rail_guide_x2.stl

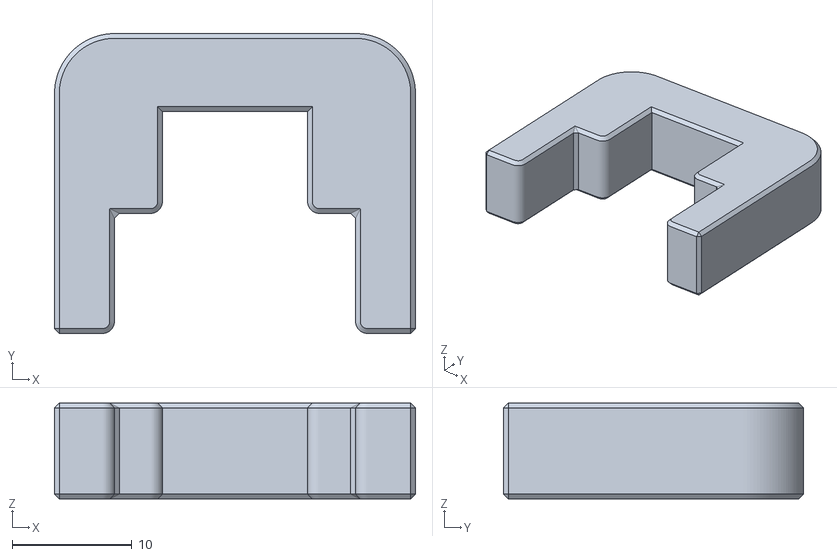
[picture p131: CAD file, 2022-04-12]
Voron-2-2.4r2/Voron-2-2.4r2/STLs/Tools/MGN12_rail_guide_x2.stl
30.1 x 25.0 x 8.00
