verdammte/voron_2.4/Mobius-Extruder-M4/Mobius-Extruder-M4/STLs/end_plate_mirror.stl

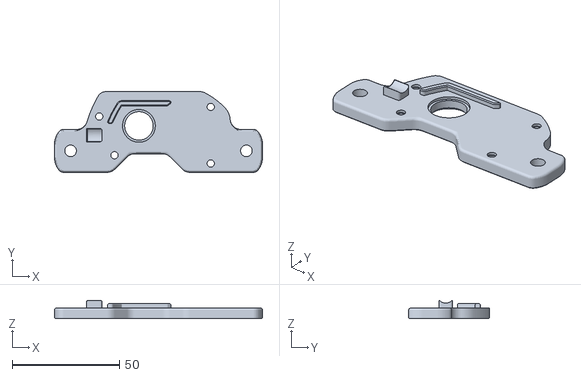
[picture p132: CAD file, 2022-04-12]
Mobius-Extruder-M4/Mobius-Extruder-M4/STLs/end_plate_mirror.stl
96.8 x 37.6 x 8.60
