verdammte/voron_2.4/Voron-2-2.4r2/Voron-2-2.4r2/Drawing_DXFs/Build_Plate/VORON_Design_-_2.4Build_Plate_250mm.dxf

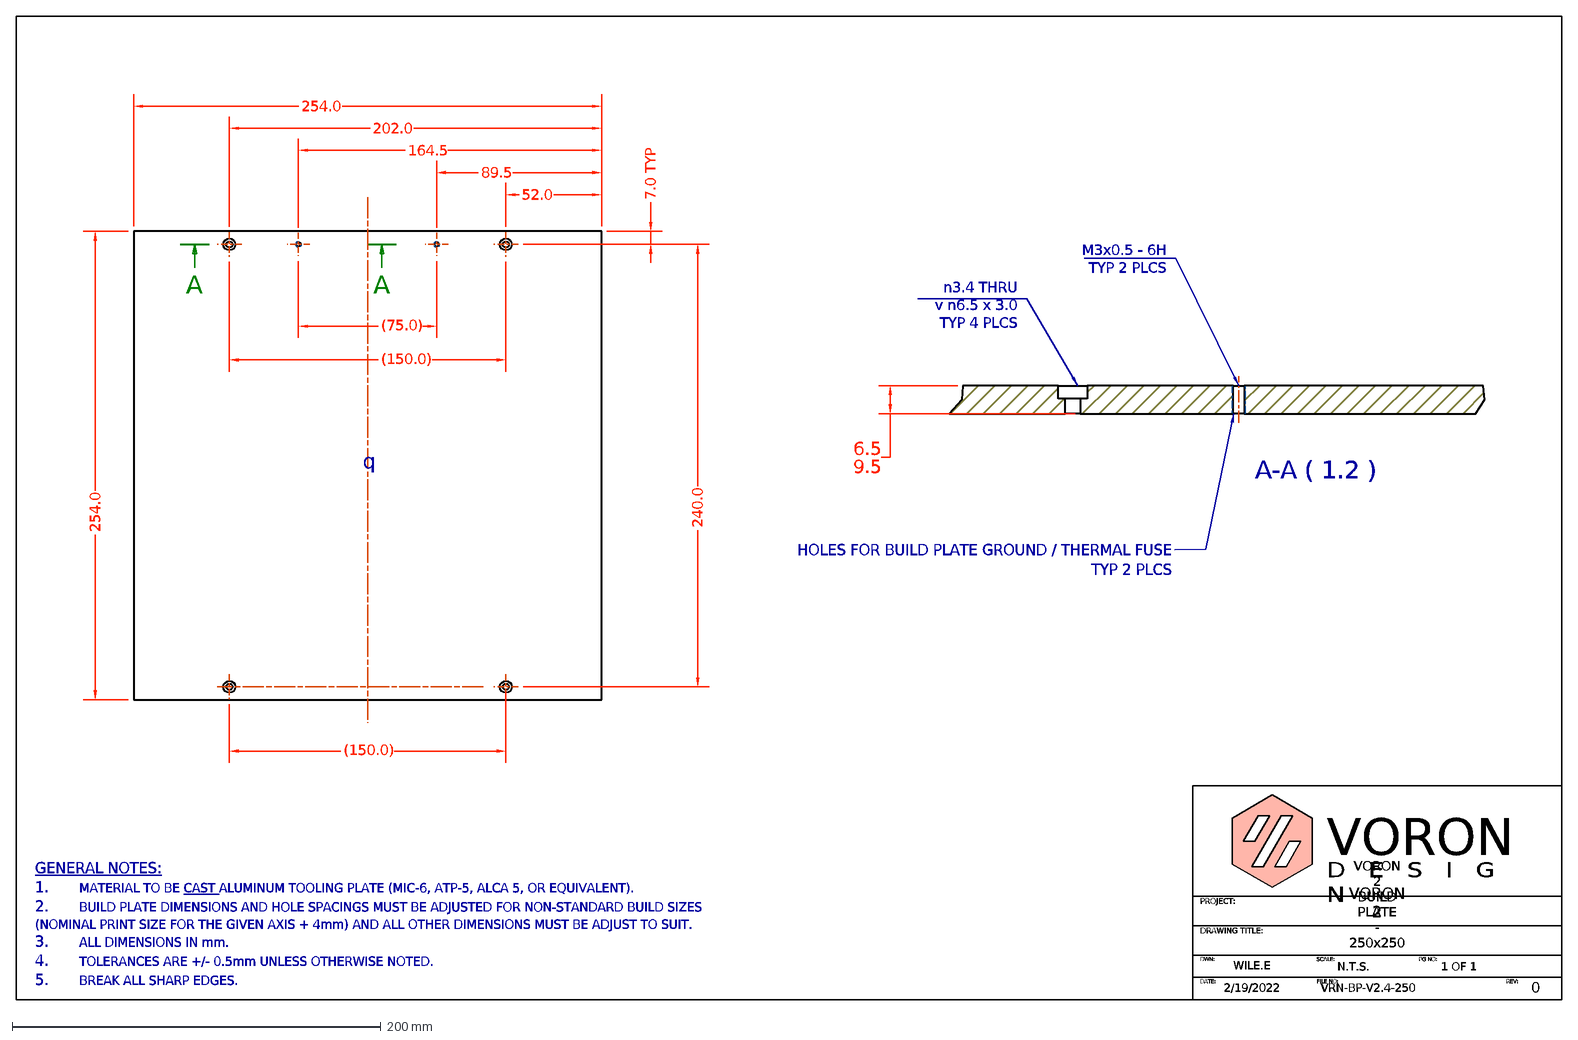
[picture p133: CAD file, 2022-04-12]
Voron-2-2.4r2/Voron-2-2.4r2/Drawing_DXFs/Build_Plate/VORON_Design_-_2.4Build_Plate_250mm.dxf
2/19/2022
VRN-BP-V2.4-250
VORON 2
WILE.E
0
DATE:
FILE NO:
PROJECT:
DRAWING TITLE:
SCALE:
PG NO:
DWN:
1 OF 1
N.T.S.
VORON
D E S I G N
REV:
VORON 2 BUILD PLATE - 250x250
A
A-A ( 1.2 )
6.5^9.5
164.5
240.0
7.0 TYP
(150.0)
GENERAL NOTES: 1. MATERIAL TO BE CAST ALUMINUM TOOLING PLATE (MIC-6, ATP-5, ALCA 5, OR EQUIVALENT). 2. BUILD PLATE DIMENSIONS AND HOLE SPACINGS MUST BE ADJUSTED
254.0
89.5
202.0
HOLES FOR BUILD PLATE GROUND / THERMAL FUSE TYP 2 PLCS
52.0
M3x0.5 - 6H TYP 2 PLCS
(75.0)
