verdammte/voron_2.4/Voron-2-2.4r2/Voron-2-2.4r2/Drawing_DXFs/Panels/350_Deck_Panel.dxf

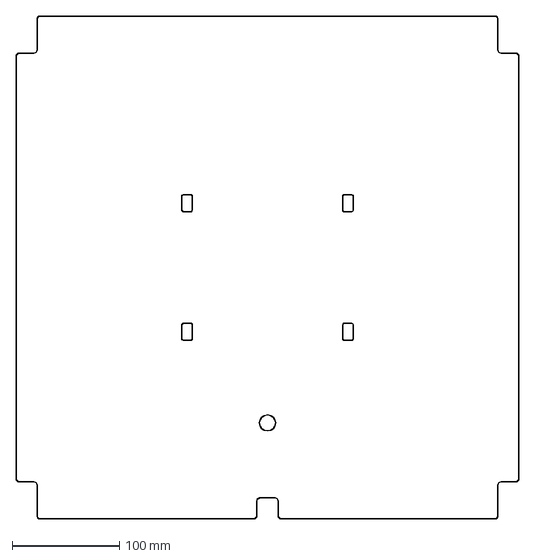
[picture p134: CAD file, 2022-04-12]
Voron-2-2.4r2/Voron-2-2.4r2/Drawing_DXFs/Panels/350_Deck_Panel.dxf
469.0 x 469.0 mm
