verdammte/voron_2.4/(list of files, cad)

Other CAD files:
Voron-2-2.4r2/Voron-2-2.4r2/STLs/Z_Drive/z_drive_main_b_x2.stl
Mobius-Extruder-M4/Mobius-Extruder-M4/STLs/main_body_mirror.stl
Voron-2-2.4r2/Voron-2-2.4r2/STLs/Z_Idlers/z_tensioner_bracket_a_x2.stl
Voron-2-2.4r2/Voron-2-2.4r2/STLs/Panel_Mounting/Front_Doors/handle_b_x2.stl
Voron-2-2.4r2/Voron-2-2.4r2/STLs/Panel_Mounting/z_belt_cover_a_x2.stl
Voron-2-2.4r2/Voron-2-2.4r2/STLs/Skirts/250/front_skirt_b_250.stl
Voron-2-2.4r2/Voron-2-2.4r2/STLs/Skirts/300/side_skirt_a_300_x2.stl
Voron-2-2.4r2/Voron-2-2.4r2/STLs/Superceded_Parts/ZipChain/Z/zipchain2_z_link_b.stl
Voron-2-2.4r2/Voron-2-2.4r2/STLs/Gantry/AB_Drive_Units/a_drive_frame_upper.stl
Voron-2-2.4r2/Voron-2-2.4r2/STLs/Skirts/300/front_skirt_b_300.stl
Voron-2-2.4r2/Voron-2-2.4r2/STLs/Skirts/350/front_skirt_b_350.stl
Mobius-Extruder-M4/Mobius-Extruder-M4/STLs/motor_plate_mirror.stl
Voron-2-2.4r2/Voron-2-2.4r2/STLs/Gantry/X_Axis/XY_Joints/[a]_xy_joint_cable_bridge_3hole.stl
Voron-2-2.4r2/Voron-2-2.4r2/STLs/Skirts/250/side_skirt_a_250_x2.stl
Voron-2-2.4r2/Voron-2-2.4r2/STLs/Skirts/350/side_skirt_b_350_x2.stl
Voron-2-2.4r2/Voron-2-2.4r2/STLs/Skirts/[a]_fan_grill_a_x2.stl
Voron-2-2.4r2/Voron-2-2.4r2/STLs/Z_Drive/[a]_z_drive_baseplate_a_x2.stl
Mobius-Extruder-M4/Mobius-Extruder-M4/STLs/[a]_5x4mm_spacer.stl
Mobius-Extruder-M4/Mobius-Extruder-M4/STLs/[a]_guidler.stl
Mobius-Extruder-M4/Mobius-Extruder-M4/STLs/[a]_latch.stl
Mobius-Extruder-M4/Mobius-Extruder-M4/STLs/end_plate.stl
Mobius-Extruder-M4/Mobius-Extruder-M4/STLs/latch_shuttle.stl
Voron-2-2.4r2/Voron-2-2.4r2/Drawing_DXFs/Build_Plate/MIC6_Bed_V2_250.step
Voron-2-2.4r2/Voron-2-2.4r2/Drawing_DXFs/Build_Plate/MIC6_Bed_V2_300.step
Voron-2-2.4r2/Voron-2-2.4r2/Drawing_DXFs/Panels/250_Bottom_Panel.dxf
Voron-2-2.4r2/Voron-2-2.4r2/Drawing_DXFs/Panels/250_Deck_Panel.dxf
Voron-2-2.4r2/Voron-2-2.4r2/Drawing_DXFs/Panels/300_Bottom_Panel.dxf
Voron-2-2.4r2/Voron-2-2.4r2/STLs/Electronics_Bay/Controller_Mounts/BTT_MOT_EXP_bracket.stl
Voron-2-2.4r2/Voron-2-2.4r2/STLs/Electronics_Bay/Controller_Mounts/SKR_Pro_bracket_set.stl
Voron-2-2.4r2/Voron-2-2.4r2/STLs/Electronics_Bay/Controller_Mounts/SKR_bracket_inline_set.stl
Voron-2-2.4r2/Voron-2-2.4r2/STLs/Electronics_Bay/Controller_Mounts/Spider_bracket_set.stl
Voron-2-2.4r2/Voron-2-2.4r2/STLs/Electronics_Bay/raspberrypi_bracket.stl
Voron-2-2.4r2/Voron-2-2.4r2/STLs/Gantry/AB_Drive_Units/[a]_cable_cover.stl
Voron-2-2.4r2/Voron-2-2.4r2/STLs/Gantry/Front_Idlers/[a]_tensioner_right.stl
Voron-2-2.4r2/Voron-2-2.4r2/STLs/Gantry/X_Axis/XY_Joints/[a]_endstop_pod_D2F_switch.stl
Voron-2-2.4r2/Voron-2-2.4r2/STLs/Gantry/X_Axis/XY_Joints/xy_joint_left_lower_MGN12.stl
Voron-2-2.4r2/Voron-2-2.4r2/STLs/Gantry/X_Axis/XY_Joints/xy_joint_left_upper_MGN12.stl
Voron-2-2.4r2/Voron-2-2.4r2/STLs/Gantry/X_Axis/X_Carriage/Direct_Feed/[a]_guidler.stl
Voron-2-2.4r2/Voron-2-2.4r2/STLs/Gantry/X_Axis/X_Carriage/Direct_Feed/[a]_latch_shuttle.stl
Voron-2-2.4r2/Voron-2-2.4r2/STLs/Gantry/X_Axis/X_Carriage/Direct_Feed/chain_anchor_2hole.stl
Voron-2-2.4r2/Voron-2-2.4r2/STLs/Gantry/X_Axis/X_Carriage/Direct_Feed/extruder_motor_plate_for_pcb.stl
Voron-2-2.4r2/Voron-2-2.4r2/STLs/Gantry/X_Axis/X_Carriage/blower_housing_rear.stl
Voron-2-2.4r2/Voron-2-2.4r2/STLs/Gantry/X_Axis/X_Carriage/probe_retainer_bracket.stl
Voron-2-2.4r2/Voron-2-2.4r2/STLs/Gantry/X_Axis/X_Carriage/probe_retainer_bracket_9mm.stl
Voron-2-2.4r2/Voron-2-2.4r2/STLs/Panel_Mounting/corner_panel_clip_4mm_x8.stl
Voron-2-2.4r2/Voron-2-2.4r2/STLs/Panel_Mounting/corner_panel_clip_6mm_x8.stl
Voron-2-2.4r2/Voron-2-2.4r2/STLs/Panel_Mounting/deck_support_3mm_x8.stl
Voron-2-2.4r2/Voron-2-2.4r2/STLs/Panel_Mounting/deck_support_4mm_x8.stl
Voron-2-2.4r2/Voron-2-2.4r2/STLs/Panel_Mounting/midspan_panel_clip_6mm_x8.stl
Voron-2-2.4r2/Voron-2-2.4r2/STLs/Skirts/[a]_belt_guard_a_x2.stl
Voron-2-2.4r2/Voron-2-2.4r2/STLs/Skirts/[a]_btt_knob_light_shield.stl
Voron-2-2.4r2/Voron-2-2.4r2/STLs/Skirts/[a]_fan_grill_b_x2.stl
Voron-2-2.4r2/Voron-2-2.4r2/STLs/Skirts/[a]_fan_grill_retainer_x2.stl
Voron-2-2.4r2/Voron-2-2.4r2/STLs/Skirts/[a]_keystone_blank_insert.stl
Voron-2-2.4r2/Voron-2-2.4r2/STLs/Skirts/[a]_mini12864_case_front_insert.stl
Voron-2-2.4r2/Voron-2-2.4r2/STLs/Skirts/keystone_panel.stl
Voron-2-2.4r2/Voron-2-2.4r2/STLs/Skirts/mini12864_case_front.stl
Voron-2-2.4r2/Voron-2-2.4r2/STLs/Skirts/mini12864_case_rear.stl
Voron-2-2.4r2/Voron-2-2.4r2/STLs/Skirts/power_inlet_IECGS_1.2mm.stl
Voron-2-2.4r2/Voron-2-2.4r2/STLs/Skirts/power_inlet_IECGS_1mm.stl
Voron-2-2.4r2/Voron-2-2.4r2/STLs/Skirts/side_fan_support_x2.stl
Voron-2-2.4r2/Voron-2-2.4r2/STLs/Superceded_Parts/Frame_Brackets/dual_ramps_bracket_frame.stl
Voron-2-2.4r2/Voron-2-2.4r2/STLs/Superceded_Parts/Frame_Brackets/duet_duex_bracket_frame_x2.stl
Voron-2-2.4r2/Voron-2-2.4r2/STLs/Superceded_Parts/Frame_Brackets/mks_gen_1.4_bracket_frame_x2.stl
Voron-2-2.4r2/Voron-2-2.4r2/STLs/Superceded_Parts/Frame_Brackets/mks_gen_L_bracket_frame_x2.stl
Voron-2-2.4r2/Voron-2-2.4r2/STLs/Superceded_Parts/Frame_Brackets/skr_1.3_bracket_frame.stl
Voron-2-2.4r2/Voron-2-2.4r2/STLs/Superceded_Parts/MGN9_X/[a]_belt_clamp_MGN9_x2.stl
Voron-2-2.4r2/Voron-2-2.4r2/STLs/Superceded_Parts/MGN9_X/x_carriage_frame_right_MGN9.stl
Voron-2-2.4r2/Voron-2-2.4r2/STLs/Superceded_Parts/MGN9_X/xy_joint_left_lower_MGN9.stl
Voron-2-2.4r2/Voron-2-2.4r2/STLs/Test_Prints/Thread_Test_1_x1_Rev1.STL
Voron-2-2.4r2/Voron-2-2.4r2/STLs/Test_Prints/Thread_Test_2_x1_Rev1.STL
Voron-2-2.4r2/Voron-2-2.4r2/STLs/Z_Drive/[a]_belt_tensioner_b_x2.stl
Voron-2-2.4r2/Voron-2-2.4r2/STLs/Z_Drive/z_drive_retainer_a_x2.stl
Voron-2-2.4r2/Voron-2-2.4r2/STLs/Z_Drive/z_drive_retainer_b_x2.stl
Voron-2-2.4r2/Voron-2-2.4r2/STLs/Z_Drive/z_motor_mount_a_x2.stl
