verdammte/voron_2.4/Assembly_Manual_M4.pdf

1

### WWW.VORONDESIGN.COM

VERSION 2020-10-19

# M4 ASSEMBLY MANUAL

## We build space shuttles with gardening tools

so anyone can have a space shuttle of their own.

# VORON

2

INTRODUCTION | WWW.VORONDESIGN.COM

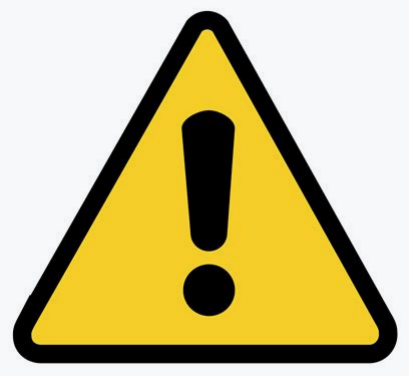
[picture p136: figure]

Before you begin on your journey, a word of caution.

In the comfort of your own home you are about to assemble a robot. This
machine can maim, burn, and electrocute you if you are not careful. Please
do not become the first VORON fatality. There is no special Reddit flair for that.

Please, read the entire manual before you start assembly. As you begin wrenching, please check our Discord channels for any tips and questions that may halt your progress.

Most of all, good luck!
THE VORON TEAM

3

INTRODUCTION | WWW.VORONDESIGN.COM

PART PRINTING GUIDELINES
The Voron Team has provided the following print guidelines for you to follow in order to have the best chance at success with your parts. There are often questions about substituting materials or changing printing standards, but we recommend you follow these.

3D PRINTING PROCESS
Fused Deposition Modeling (FDM)

MATERIAL
ABS

LAYER HEIGHT
Recommended: 0.2mm

EXTRUSION WIDTH
Recommended: Forced 0.4mm

INFILL TYPE
Grid, Gyroid, Honeycomb, Triangle or Cubic

INFILL PERCENTAGE
Recommended: 40%

WALL COUNT
Recommended: 4

SOLID TOP/BOTTOM LAYERS
Recommended: 5

PRINT IT FORWARD (PIF)
Often times our community members have issues printing ABS will bootstrap themselves into a VORON using our Print It Forward program. This is a service where approved members with VORON printers can make you a functional set of parts to get your own machine up and running.
Check Discord if you have any interest in having someone help you out.

4

INTRODUCTION | WWW.VORONDESIGN.COM

HOW TO GET HELP
If you need assistance with your build, we’re here to help. Head on over to our Discord group and post your questions. This is our primary medium to help VORON Users and we have a great community that can help you out if you get stuck.

https://discord.gg/voron


THIS IS JUST A REFERENCE
This manual is designed to be a simple reference manual. Building a Voron can be a complex endeavour and for that reason we recommend downloading the CAD files off our Github repository if there are sections you need clarification on. It can be sometimes be easier to follow along when you have the whole assembly in front of you.


https://github.com/vorondesign

5

### WWW.VORONDESIGN.COM

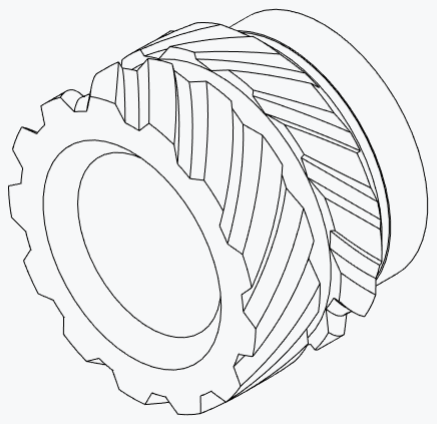
[picture p139: figure]

SOCKET HEAD CAP SCREW (SHCS) Metric fastener with a cylindrical head and hex drive. The most common fastener used on the Voron.

ISO 4762

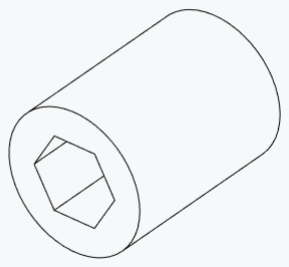
[picture p141: figure]

WASHER
Small metal disc to increase the surface area.

DIN 988

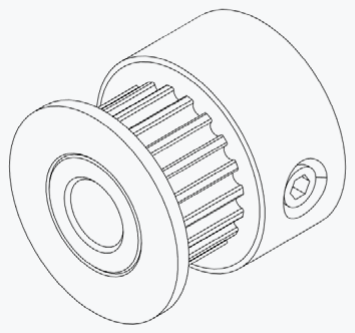
[picture p143: figure]

PULLEY
GT2 pulley used on the motion system of the Voron.

HARDWARE
HEAT SET INSERT
Heat inserts with a soldering tip so that they melt the plastic when installed. As the plastic cools, it solidifies around the knurls and ridges on the insert for excellent resistance to both torque and pull-out.

F695 BEARING
A ball bearing with a flange used in various gantry locations.

GRUB SCREW
Small headless screw with an internal drive.

ISO 4026


BUTTON HEAD CAP SCREW (BHCS) Metric fastener with a domed shape head and hex drive. Most commonly found in locations where M5 fasteners are used.

ISO 7380-1

### WWW.VORONDESIGN.COM


6

REMOVE FLANGE
Use a bottle opener or some pliers to remove the top flange.

GT2 Pulley

M3x8 BHCS

80T GEAR

7

### WWW.VORONDESIGN.COM

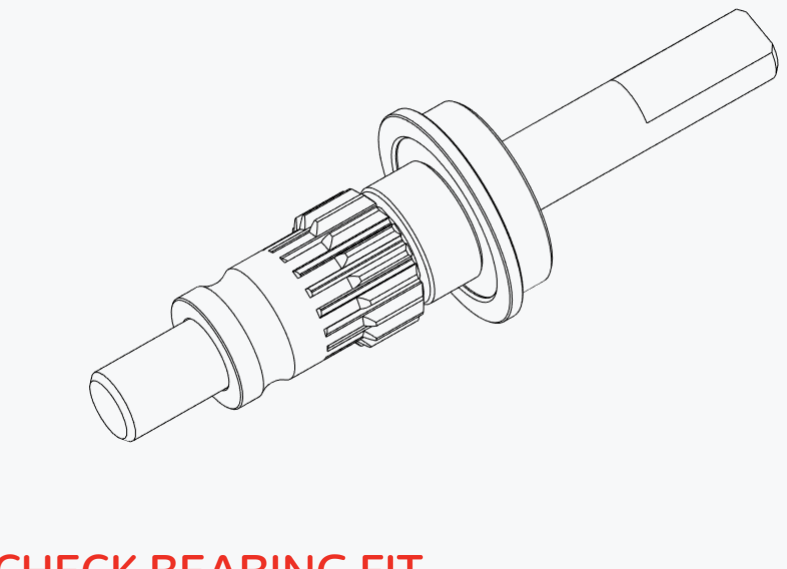
[picture p146: figure]

CHECK BEARING FIT
The bearings must slip on and off the shaft easily. Pressing the bearings on the shaft will damage them. Lightly sand the shaft if required.


5x50mm Shaft w/ Flats
F695 Bearing

4mm Printed Spacer

DRIVE GEAR POSITION
Position the drive gear 8mm from the end of the shaft and tighten the grub screw.
Use thread locker.

DRIVE SHAFT

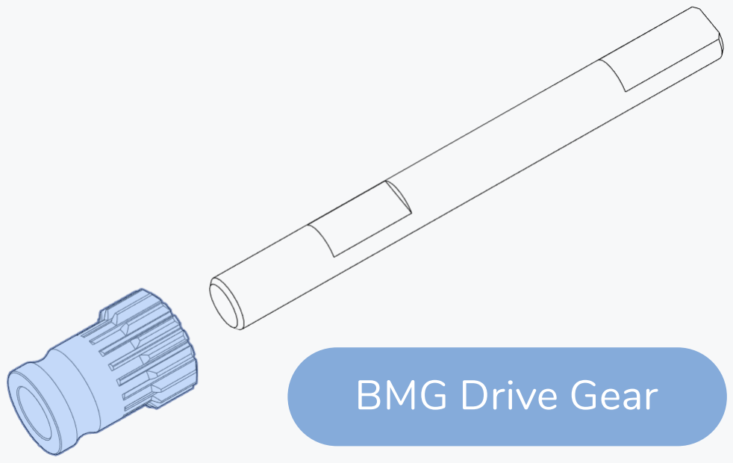
[picture p149: figure]
BMG Drive Gear

FLAT FACE ON THE SHAFT
Align the flat face of the shaft with the grub screw of the drive gear. If your shaft is fully round make a small flat spot with a file to ensure proper seating.


8

### WWW.VORONDESIGN.COM


LUBRICATE BEARINGS
A light lubrication film will help with smooth operation and longevity.


BMG Idler Assembly

IDLER ASSEMBLY

### WWW.VORONDESIGN.COM


9

HEAT SET INSERTS
You will need to install heat set inserts into the tension arms. If you need help on the correct procedure, ask in Discord.

Heat Set Insert

F695 Bearing

HEAT SET INSERTS

BODY ASSEMBLY | WWW.VORONDESIGN.COM


10

CHECK ALIGNMENT
The hobbed section of the drive gear must be aligned with the filament path. There is a small amount of play to allow for self adjustment.
Correct the gears position if required.

BODY ASSEMBLY | WWW.VORONDESIGN.COM


11

12

### WWW.VORONDESIGN.COM

BODY ASSEMBLY

M3x30 SHCS

### WWW.VORONDESIGN.COM


13

GRUB SCREWS
Loose grub screws account for the majority of issues that our users report. Save yourself hours of troubleshooting and apply thread locker to all grub screws during the build.
See the products application notes for instructions.

BMG Thumb Screw
ECAS04 Bowden Collet

BODY ASSEMBLY

### WWW.VORONDESIGN.COM


14

GT2 Pulley

Stepper Motor

STEPPER MOTOR SIZING
Stepper motor selection depends on your mounting requirements. For flush mounting use a stepper with 20mm body height (as used on the VORON Afterburner).

M3x12 SHCS

M3x16 SHCS

M3 Washer

DON’T TIGHTEN
Leave the screws slightly loose for the next step.

BODY ASSEMBLY

15

### WWW.VORONDESIGN.COM

GT2 Belt Loop 188mm

ROTATE STEPPER TO TIGHTEN
Fasten the screws after applying a light pressure to tighten the belt.


CHECK ALIGNMENT
Adjust the position of the pulley on the stepper if required. Belt must not rub on the flanges.

DRIVE BELT & ALIGNMENT

16

### WWW.VORONDESIGN.COM

Github
https://github.com/vorondesign

Website
www.vorondesign.com

Discord
https://discord.gg/voron

# VORON


17

### WWW.VORONDESIGN.COM
