verdammte/voron_2.4/Voron-2-2.4r2/Voron-2-2.4r2/Drawing_DXFs/Build_Plate/VORON_2.4_Build_Plate_250mm.pdf

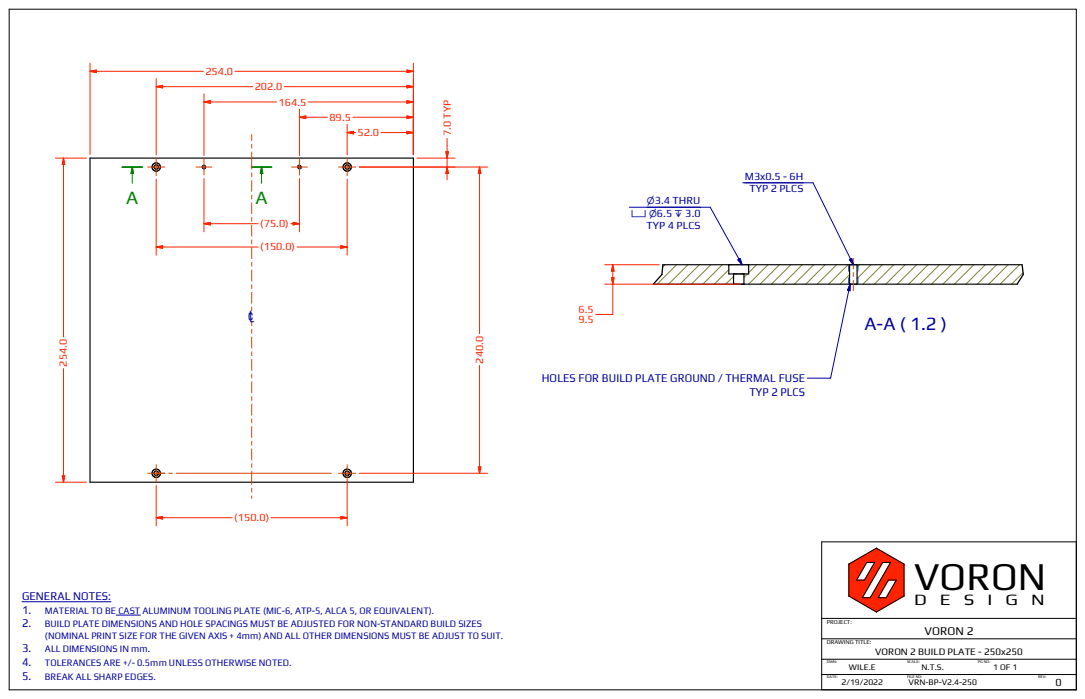
[picture p165: page 1]
VRN-BP-V2.4-250 DATE:; FILE NO:; PROJECT: DRAWING TITLE:; VORON 2; VORON 2 BUILD PLATE - 250x250 DWN:; SCALE:; PG NO: WILE.E; VORON; REV:; 164.5 240.0 7.0 TYP; TYP 2 PLCS; n3.4 THRU v n6.5 x 3.0 TYP 4 PLCS; M3x0.5 - 6H TYP 2 PLCS

HOLES FOR BUILD PLATE GROUND / THERMAL FUSE

GENERAL NOTES:
1. MATERIAL TO BE CAST ALUMINUM TOOLING PLATE (MIC-6, ATP-5, ALCA 5, OR EQUIVALENT).
2. BUILD PLATE DIMENSIONS AND HOLE SPACINGS MUST BE ADJUSTED FOR NON-STANDARD BUILD SIZES
(NOMINAL PRINT SIZE FOR THE GIVEN AXIS + 4mm) AND ALL OTHER DIMENSIONS MUST BE ADJUST TO SUIT.
3. ALL DIMENSIONS IN mm.
4. TOLERANCES ARE +/- 0.5mm UNLESS OTHERWISE NOTED.
5. BREAK ALL SHARP EDGES.
