verdammte/voron_2.4/Voron-2-2.4r2/Voron-2-2.4r2/Drawing_DXFs/Build_Plate/VORON_2.4_Build_Plate_300mm.pdf

A A

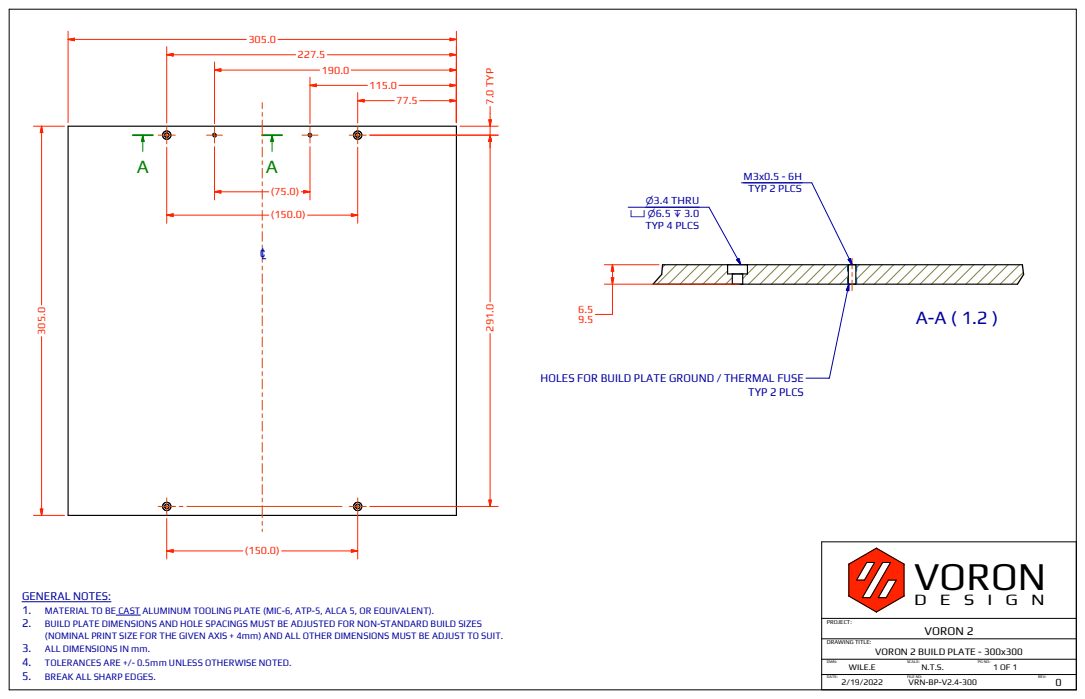
[picture p166: page 1]
VRN-BP-V2.4-300 DATE:; FILE NO:; PROJECT: DRAWING TITLE:; VORON 2; VORON 2 BUILD PLATE - 300x300 DWN:; SCALE:; PG NO: WILE.E; VORON; REV:; 190.0 291.0 7.0 TYP; TYP 2 PLCS; n3.4 THRU vn6.5 x 3.0 TYP 4 PLCS; M3x0.5 - 6H (75.0) TYP 2 PLCS

HOLES FOR BUILD PLATE GROUND / THERMAL FUSE

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
